MrAbdalrahman/university/Artifical_intelligance/projet1Genetic/AIP1/readme.txt

------------------------------this file helps you to understand how to deal with the program------------------------------

inserting input: 

to insert an input go the the input.txt each line represents a single job in each job there is a set of operations

seperated by " -> ". you dont have to decide how many machines should the system support it generates machines upon the 

higest machine id. let's say your input included M1,M2,M3,M7 it will create machines from M1 to M7.

---------------------------------------------------------------------------------------------------------------------------

analaysing output:

the output is very simple. 

the Y-axis represents the machines 

the X-axis represents the time any operation has been working 

merged togother gives us a simple view of the best schedule for your jobs in your factory

___________________________________________________________________________________________________________________________________________
