MrAbdalrahman/university/project_management/projectManegment.pptx

## Intelligent Speed Bump Alert System

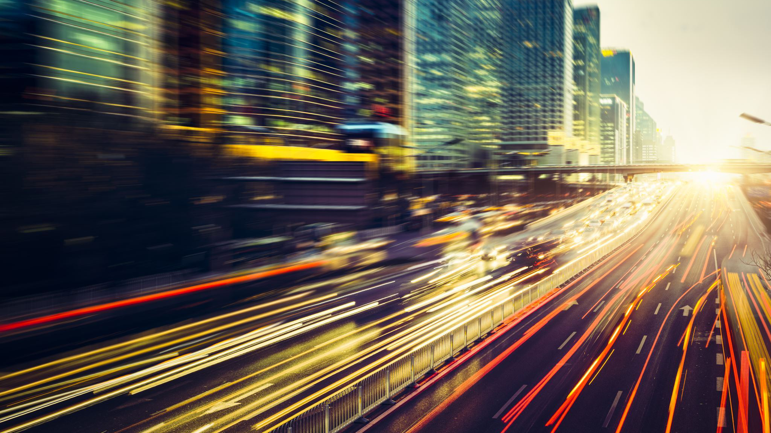
[picture p9: figure]
Traffic light trails at night

## Executive Summary

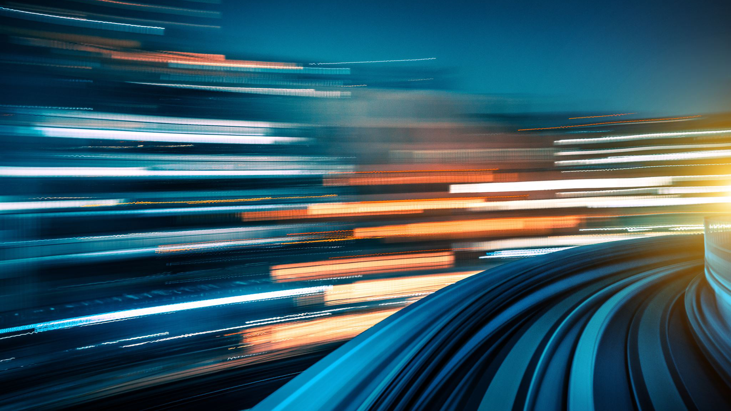
[picture p10: figure]
Long exposure of lights

The Smart Bump Alert System aims to enhance road safety through a compact device in cars. It includes a tiny computer, GPS, SIM card, and a user-friendly screen, alerting drivers about upcoming speed bumps. Our project focuses on careful research and harnessing public support for data collection. In the future, we envision collaborating with the government to enhance road safety using our collected data. Additionally, potential partnerships with map companies could involve sharing our data to improve their maps. Our ultimate objective is to contribute to safer roads for everyone. This project will begin its application on 1/1/2024 and will be ready on 21/5/2024 .

## Project Deliverables and Objective

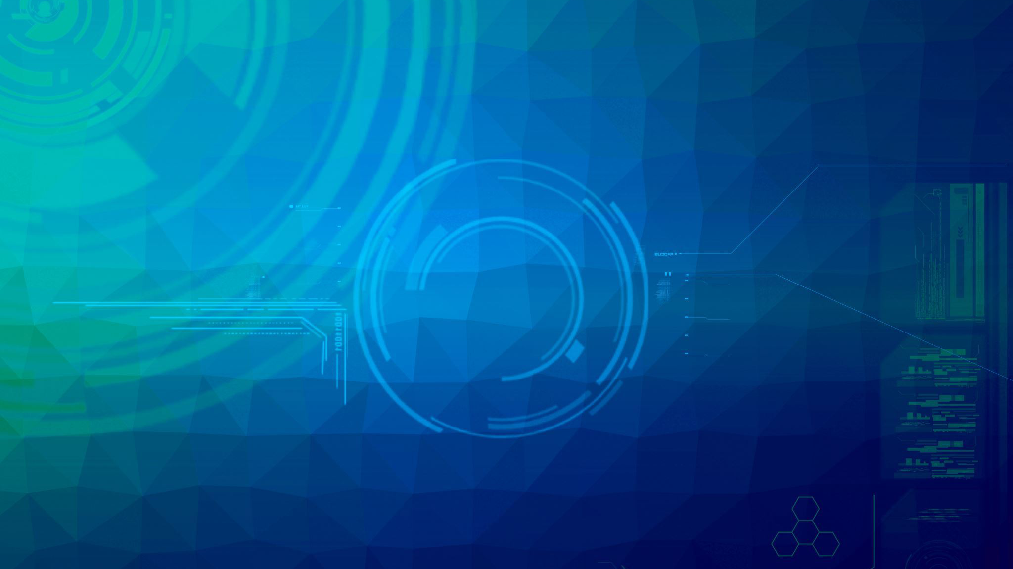
[picture p11: figure]
Technological background

Project Deliverables :
- Acquire Equipment and hire staff: Procure microcontroller, GPS module, SIM card, and necessary elements.
- Java Code Development: Write Java code for the Smart Bump Alert System.
- Data Collection Strategy: Plan how to collect both initial and real-time data.
- Digital Elements Integration: Connect and integrate digital components for seamless functionality.
- Code Installation: Install Java code onto the Smart Bump Alert Device.
- First Prototype Assembly: Assemble hardware components for the initial prototype.
- Prototype Testing: Test the prototype thoroughly for effective operation.
- Feedback application: Review feedback and refine both hardware and software.
- Data Collection Implementation: Implement the data collection strategy.
- Final Prototype Development: Develop the finalized Smart Bump Alert Device.

Project Objective :
- Smart Bump Alert Device first prototype:
Fully functional hardware device with integrated microcontroller, GPS, SIM card, and user-friendly display.
- Collected Data:
Collected initial dataset.

## Mile stones

Equipment Procurement Complete (7/1/2024):
Acquired microcontroller, GPS module, SIM card, and necessary components.
Java Code Development Completed
(14/1/2024)
Developed, tested, and finalized the Java code for the Smart Bump Alert System.
Data Collection Strategy Defined (21/1/2023):
Documented and finalized the strategy for initial and real-time data collection.
Digital Elements Integrated
(11/2/2024):
Successfully connected and integrated all digital components.
Java Code Installed on Device (Week 18/2/2024):
Completed the installation of Java code onto the Smart Bump Alert Device.
First Prototype Assembled and Tested
(18/3/2024):
Assembled hardware components into the initial prototype and conducted comprehensive testing.
Iterative Refinement Completed (17/4/2024):
Reviewed feedback, made necessary refinements to both hardware and software components.
Data Collection Implemented (31/4/2024):
Operational integration of the real-time data collection strategy.
Finalized Device Ready for Production (21/5/2024):
Completed version of the Smart Bump Alert Device ready for manufacturing.

## Slide 5

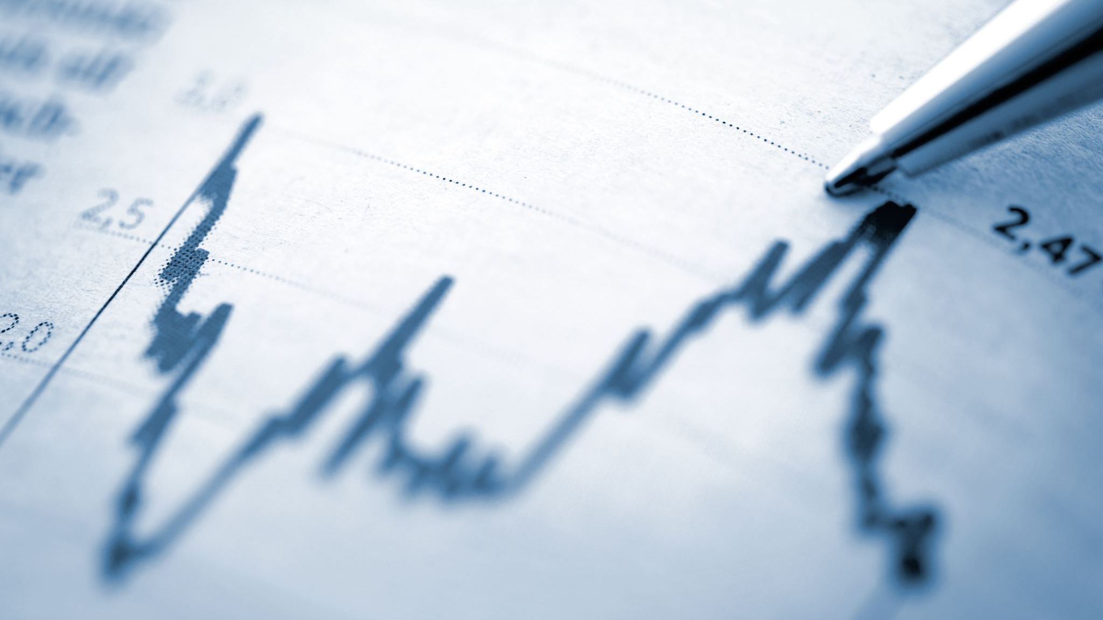
[picture p12: figure]
Graph on document with pen

Technical Requirements and limits and exclusions

Technical Requirements:
- Supplies:
Microcontroller, GPS Module , SIM Card, User-Friendly Display ,Other components like wires ,etc.
- Human resources:
Computer engineer , computer scientist , network specialist , drivers.

Limits and Exclusions:
1- Data Collection and Update:
Inclusion of Government Assistance: Collaboration with the government will be considered to aid in data collection, acknowledging the challenging nature of this task.
2- Restricted Data:
Exclusion of Hole Detection: The system will not have the capability to detect road holes or similar features. It is specifically designed for speed bump detection.
Random Road Geographies: Given that road geographies are created by random individuals, the system's focus is on speed bumps, and it does not account for variations in road conditions such as holes or other irregularities.

## Project priorities

Driver Safety:
Priority: High
Explanation: The primary goal is to enhance driver safety by providing timely and accurate alerts for speed bumps.
Clear Display in Sunlight:
Priority: High
Explanation: Ensuring the display's visibility in bright sunlight is crucial for effective communication with the driver..
Real-Time Response:
Priority: High
Explanation: Achieving a real-time response to speed bump detection is essential for immediate driver awareness and safety.
Adaptability:
Priority: Moderate
Explanation: While important, adaptability to various car models is a secondary priority compared to the core objectives of safety and real-time functionality.

## Work Breakdown structure

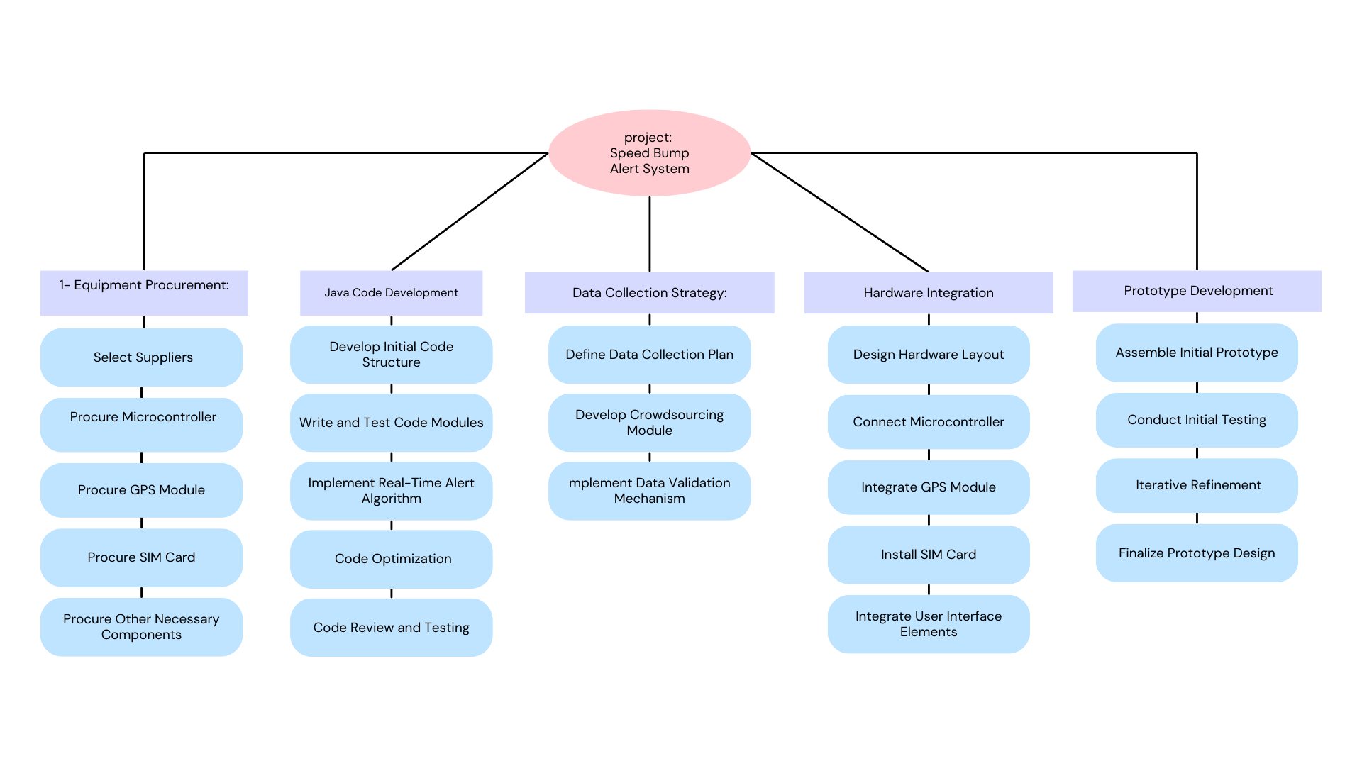
[picture p13: figure]

## Times and Costs

| Equipment procurement | Java Code Development | Initial Data Collection | Hardware and software Integration | Prototype Development
Time | 1 week: 3 days to find suppliers 4 days to purchase equipment | 1 week: 5 days to develop structure 2 days to test code | 6 weeks Initial data collection will be Distributed among workers 3 weeks to data collection 3 weeks to define method | 4weeks 1 week GPS integration 1 week SIM integration 1 week display integration 1week code installation | 4 weeks to test the device
Cost | Raspberry Pi 4 kit: $160 GPS module: $12 Hologram IoT SIM: $55 LCD Display:$10 | Programmer to write the structure: $300 Code tester to test the algorithm: $100 | $1 per 1 location Initial required locations: 1000 location $1000 | Computer Engineer will be working on this $300 per successful integration | Testing will be held by a specialized tester who will get $400 and have to handle a report.

Total time : 16 week + 4 weeks (feed back updates ) = 20 weeks
Total cost : $3237 + $400 as spare if any component lost = $3637
