MrAbdalrahman/university/networks/project1_socket/project_report.pdf

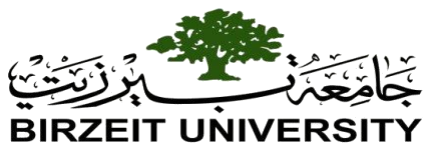
[picture p31: figure]

# Department of Electrical and Computer Engineering

# Computer Networks

# ENCS3320

# Project1

# Prepared by:

Mahmoud Awad | Student NO. 1212677

# Instructor: Dr. Abdalkarim Awad

# Section: One

Abd AlRahman Shaheen | Student NO. 1211753

# Instructor: Dr. Mohammad Jubran

# Section: Two

Omar Daghlas | Student NO. 1222500

# Instructor: Dr. Imad Tartir

# Section: Four

## Date: 22_12_2023

# Part1:

# 1. In your own words, what are ping, tracert, nslookup, and telnet (write one sentence for each one)

## - Ping: ping is a small packet of data sent from one computer to another to check if the

recipient is reachable and how long it takes for the data to travel back.

## - Tracert: tracert is a network diagnostic tool used to trace the route that packets take

from a source device to a destination device or server on an IP network.

## - Nslookup: nslookup is a command-line tool used for querying Domain Name System (DNS) servers to obtain domain name or IP address mapping, DNS records, and other

DNS-related information.

## - Telnet: telnet is a network protocol and a command-line tool that allows for

bidirectional text communication between two devices over a network.

## 2. Make sure that your computer is connected to the internet and then run the following commands:

## 1. Ping a device in the same network, e.g. from a laptop to a smartphone

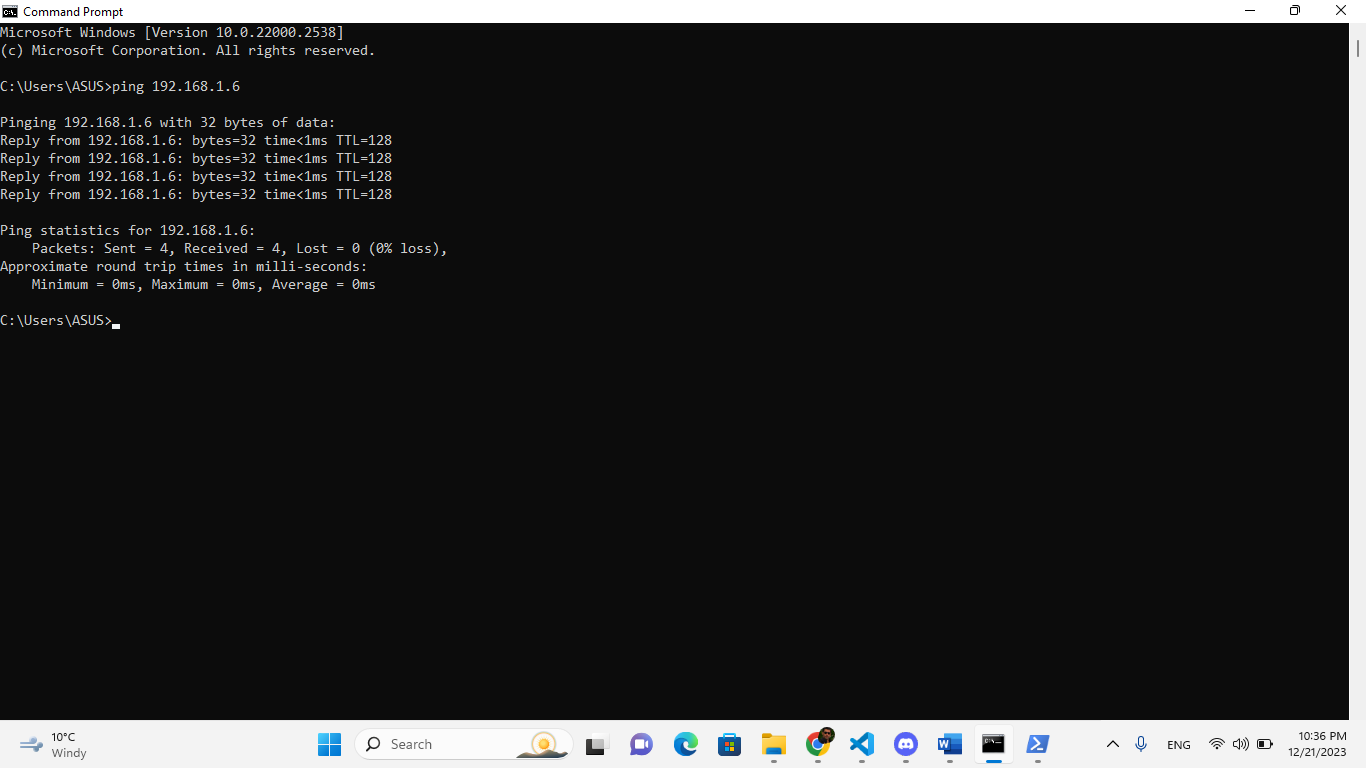
[picture p32: figure]

## Explanation of the output:

This command displays the results of each ICMP echo request. For each packet sent (four in this case), the output shows a reply from the specified IP address (192.168.1.6) along with the size of the data packet (32 bytes), the round trip time (time<1ms, indicating a response time of less than 1 millisecond), and the Time to Live (TTL) value, which is 128 in this case.

## 2. ping www.cornell.edu 1) Using Command Prompt:

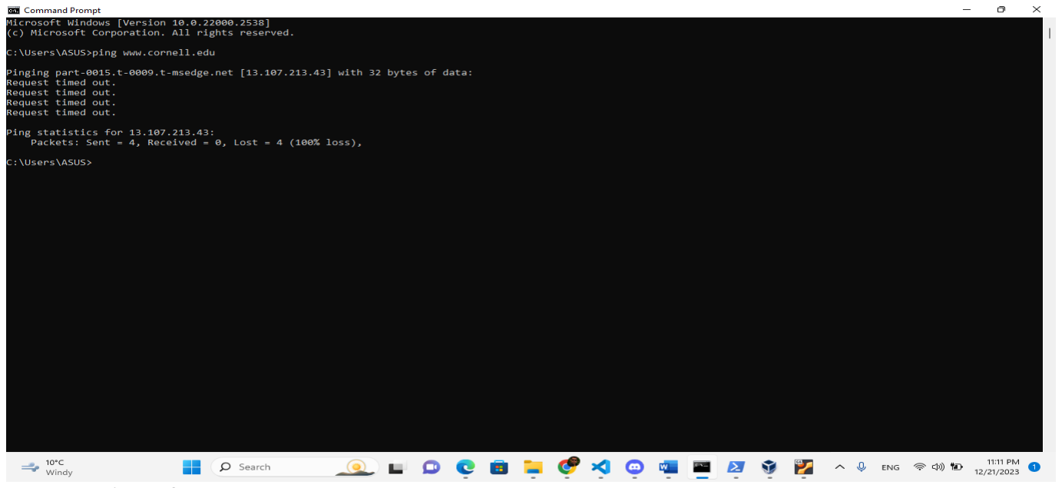
[picture p33: figure]

## Explanation of the output:

The output shows that the ping attempts to the IP address 13.107.213.43 (associated with the domain www.cornell.edu) resulted in four consecutive timeouts. Each "Request timed out" message indicates that the ping packet did not receive a response within the expected time frame.

## 2) Using Linux:

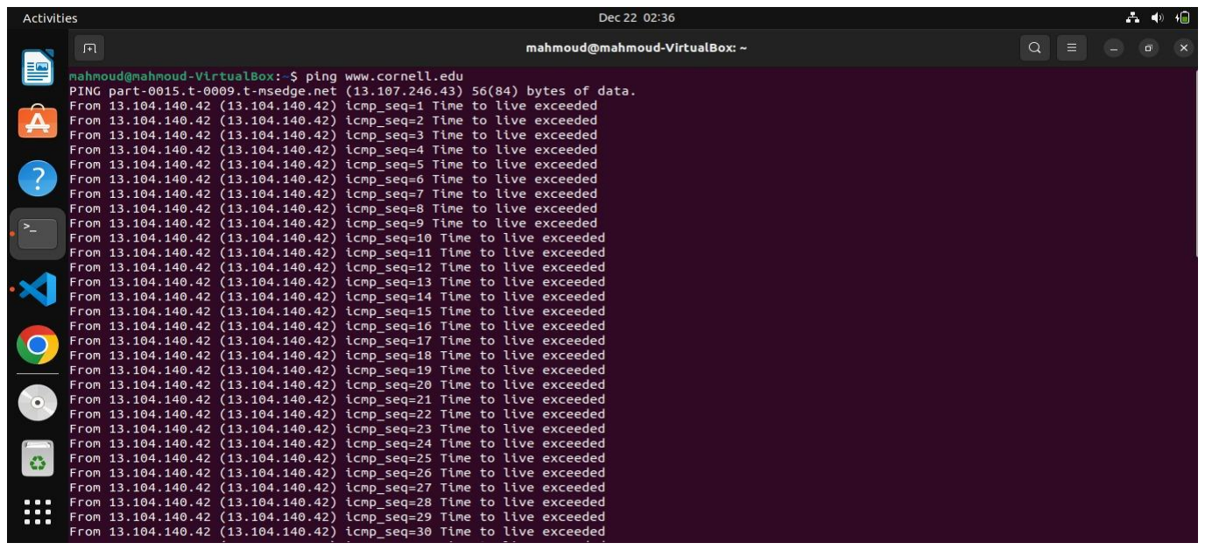
[picture p34: figure]

## Explanation of the output:

The subsequent lines show responses received from the IP address 13.104.140.42, indicating that the Time to Live (TTL) for the packets has been exceeded. This typically occurs when a packet traverses routers, and the TTL value reaches zero, preventing it from reaching the destination. The router then sends an ICMP Time to Live Exceeded message back to the source.

## 3. tracert www.cornell.edu

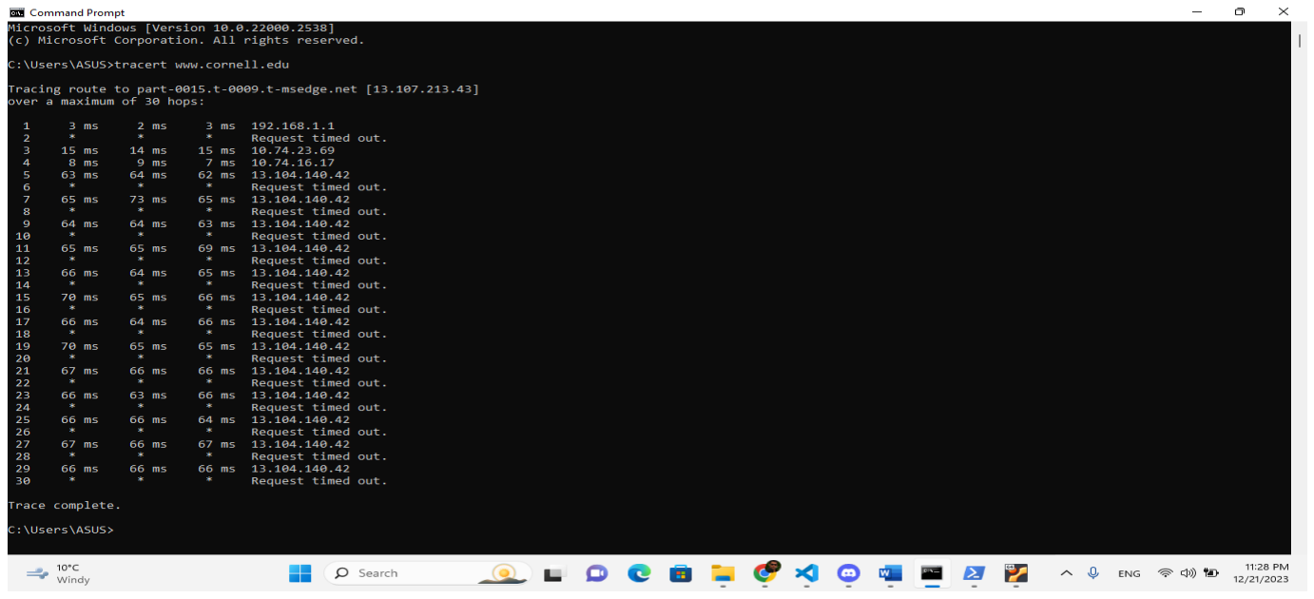
[picture p35: figure]

## Explanation of the output:

The first step (hop) is quick and takes about 3 milliseconds to reach a place labeled as 192.168.1.1, which might be like the entrance gate to the internet.
The second step didn't respond, and we don't know what happened there.
The third step took about 15 milliseconds to reach another place with the address 10.74.23.69.

## 4. nslookup www.cornell.edu

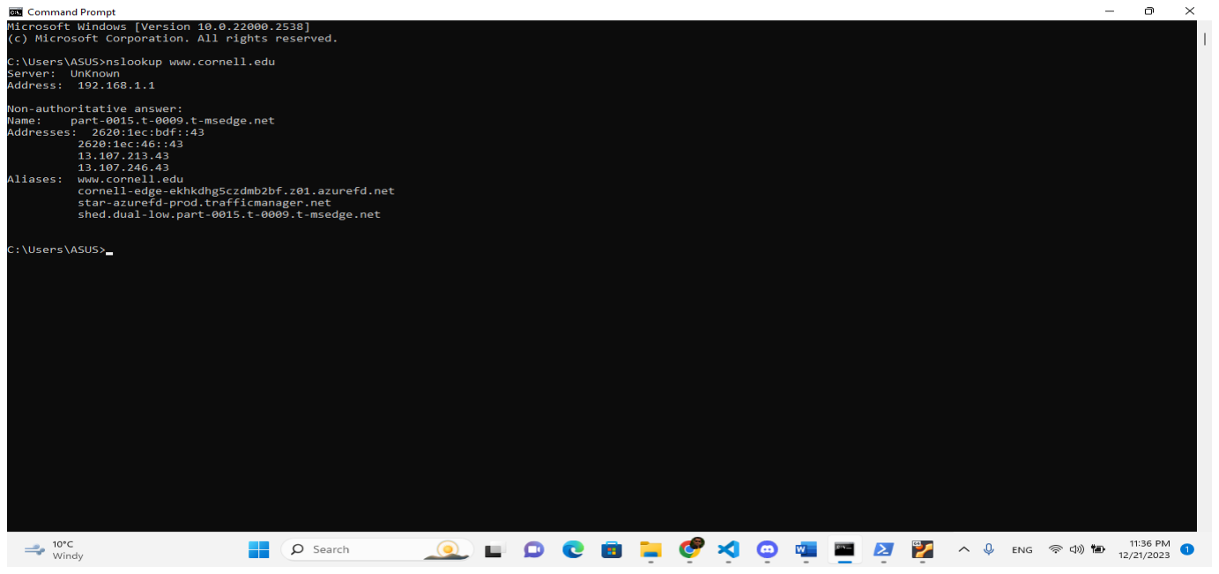
[picture p36: figure]

## Explanation of the output:

The website www.cornell.edu has other names like part-0015.t-0009.t-msedge.net.
It can be reached using different numbers (addresses) like 2620:1ec:bdf::43, 2620:1ec:46::43, 13.107.213.43, and 13.107.246.43.
The website has nicknames or aliases like www.cornell.edu.
It's associated with other names like cornell-edge-ekhkdhg5czdmb2bf.z01.azurefd.net and star-azurefd-prod.trafficmanager.net.

3. Use wireshark to capture some DNS messages.

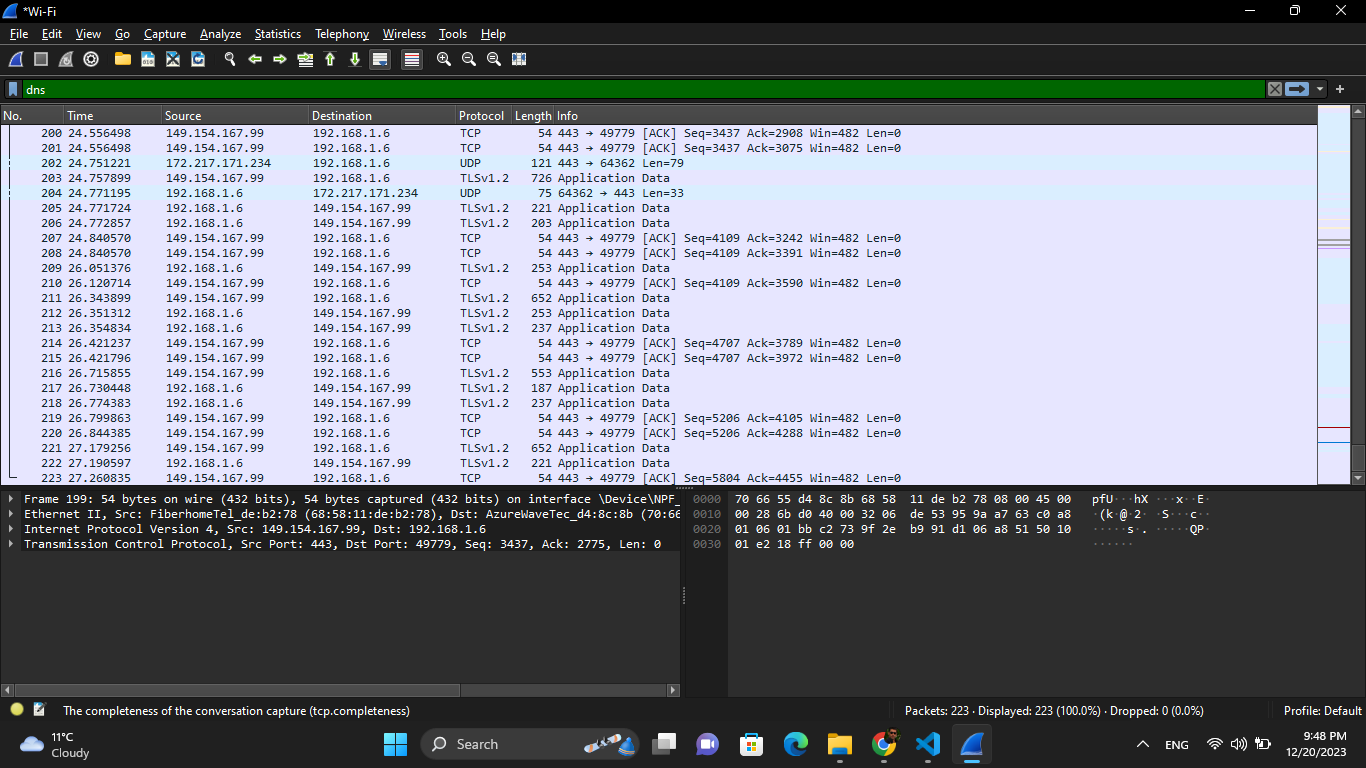
[picture p37: figure]

## Explanation of the output:

Wireshark Interface: Displays captured network packets with details like number, time, source, destination, protocol, length, and information.
Color-coded rows represent individual packets, allowing for easy identification and analysis.
TCP Details: The bottom section shows details of a specific Transmission Control Protocol (TCP) packet. Taskbar Icons: Includes Wi-Fi signal strength and battery level indicators.

## - From the ping results, do you think the response you have got is from USA?

Explain your answer briefly.

- When you use the "ping" command to talk to a server, you're checking if it responds back. The response time is shown, but it doesn't tell you the exact route or where the server is. It just says if the server is reachable or not.
- If you want to know the path your data takes to reach a destination, you can use tools like "traceroute" or "tracert" on your computer. These tools reveal each stop (router) along the way, helping you see the route and possibly the location of each middle server.

### - depending on the previous run of tracert: As you notice the time diffirance on 2 specific points: from (7ms) to (62ms)

this is where the response transported through the ocean and went to America. hence, the response we got is from USA.

# Part2:

❖ Using socket programming, implement TCP client and server applications in python. The server should listen on port 9955. The server waits for a message from a client. If the message is with one of the students ID (1211773, 1222500, 1212677).

## the sever should do the following:

## 1. display a message on the server side that the OS will lock screen after 10 seconds 2. send a message to the client that the sever will lock screen after 10 seconds 3. then wait 10 seconds

4. then call a function lock the screen of the operating system windows.

## Code:

## 1. Server Code:

1. import socket
2. import threading
3. import time

4.

5. dataBase = ["1211753", "1222500", "1212677"]
6. PORT = 9955 # using port 9955
7. FORMAT = "utf-8" # format used for our messages decoding
8. HEADER = 64
9. D = "DES"
10. SERVER = socket.gethostbyname(socket.gethostname()) # dynamic ip address getter
11. ADDR = (SERVER, PORT) # adding the server and the port
12. server = socket.socket(socket.AF_INET, socket.SOCK_STREAM) # using ipv4 address family and type

stream for the server

13. server.bind(ADDR) # binding the server and the port
14. # sever is built and ready to use

15.

16. def lockScreen():
17. print("screen is locked")

18.

19. def send(msg, client):
20. MSG = msg.encode(FORMAT) # encoding the decoded message with the same format
21. msg_len = len(MSG) # message length got
22. send_len = str(msg_len).encode(FORMAT)
23. send_len +=b' '*(HEADER - len(send_len))
24. client.send(send_len)
25. client.send(MSG)

26.

27. def client(conn, addr, clients):

28.

29. print(f"{addr} Is Connected!")

30. connected = True # connection status
31. while connected:
32. msg_len = conn.recv(HEADER).decode(FORMAT) # take the message header and check the length

and allocate 64

33. if msg_len:
34. msg_len = int(msg_len) # now we have the message length
35. msg = conn.recv(msg_len).decode(FORMAT)
36. if msg == D:
37. connected = False
38. print(f"{addr} disconnected")
39. if msg in dataBase:
40. print(f"{addr} {msg} exists")
41. print("the OS will lock screen after 10 seconds")
42. send("the OS will lock screen after 10 seconds",conn)
43. time.sleep(10)
44. lockScreen()
45. else:
46. print("student id does not exist in our data base")
47. send("the OS will not lock the screen ", conn)
48. conn.close()

49.

50. def start():
51. server.listen() # setting the server to listening mode
52. print(f"The Server Is Listening to {SERVER} ")
53. clients = []
54. while True: # this will receive any connection
55. conn, addr = server.accept() # obtaining connection and ip address
56. clients.append(conn) # appending connections
57. thread = threading.Thread(target=client, args=(conn, addr, clients))
58. thread.start()

59.

60. print("The Server Is Starting")
61. start()

## 2. Client Code:

## 1. import socket 2. import threading

3.

4. PORT = 9955 # using port 9955 5. FORMAT = "utf-8" # format used for our messages decoding 6. D = "DES" 7. HEADER = 64 8. SERVER = "192.168.56.1" # my ip address 9. ADDR = (SERVER, PORT) # adding the server and the port 10. client = socket.socket(socket.AF_INET, socket.SOCK_STREAM) # using ipv4 address family and type stream for the client 11. client.connect(ADDR)

12.

## 13. def send(msg): 14. MSG = msg.encode(FORMAT) # encoding the decoded message with the same format 15. msg_len = len(MSG) # message length got 16. send_len = str(msg_len).encode(FORMAT) 17. send_len +=b' '*(HEADER - len(send_len)) 18. client.send(send_len) 19. client.send(MSG)

20.

## 21. def read(): 22. msg_len = client.recv(HEADER).decode(FORMAT) # take the message header and check the length and allocate 64 23. if msg_len: 24. msg_len = int(msg_len) # now we have the message length 25. msg = client.recv(msg_len).decode(FORMAT) 26. print(f"{msg} ")

27.
28. x = ''

## 29. while 1: 30. x = input() 31. if x!='DES': 32. send(x) 33. thread = threading.Thread(target=read) 34. thread.start() 35. send(D)

## Result:

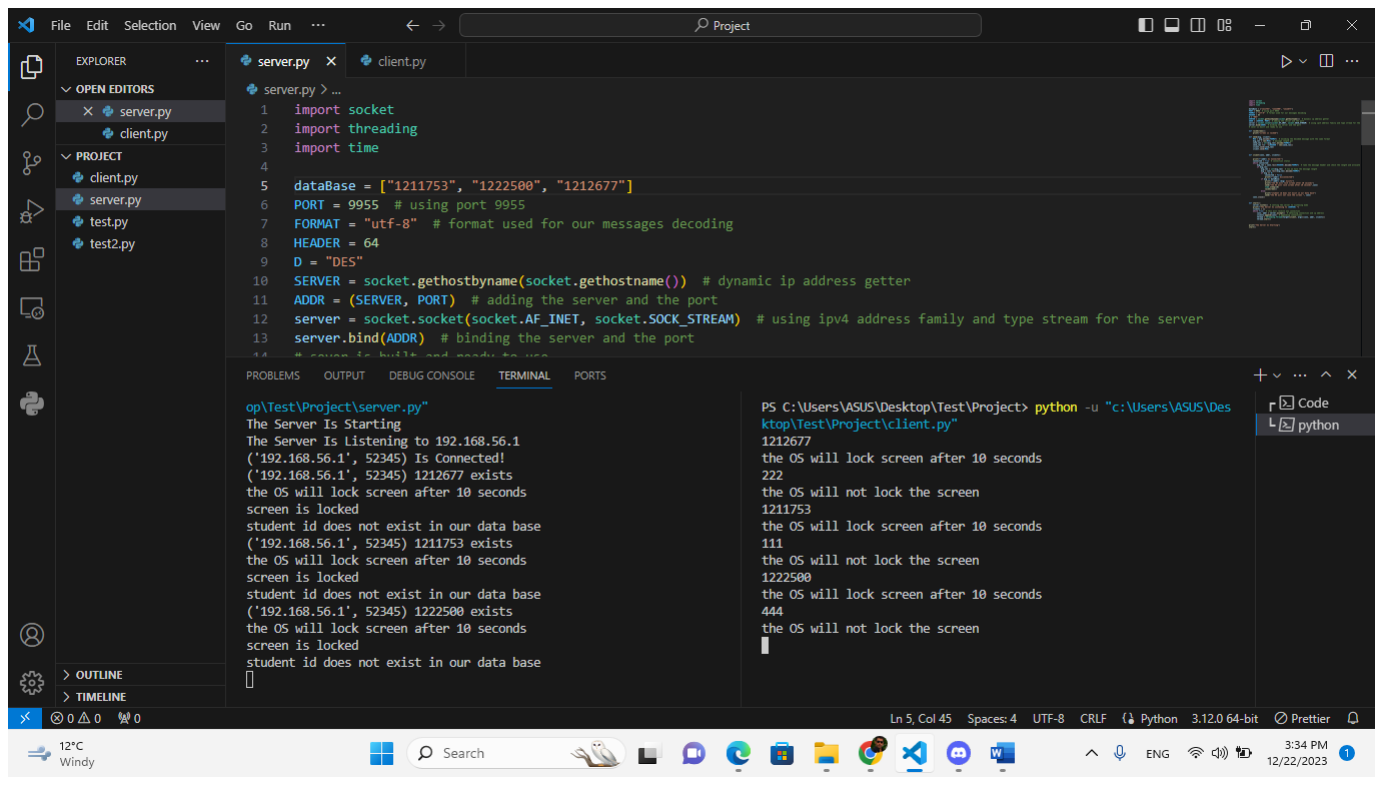
[picture p38: figure]

# Part3:

# Code:

## 1. Server Code:

1. import socket
2. import os
3. import urllib.parse
4. from threading import Thread

5.

6. class MyHTTPServer:
7. def __init__(self, host, port):
8. self.host = host
9. self.port = port
10. self.server_socket = socket.socket(socket.AF_INET, socket.SOCK_STREAM)
11. self.server_socket.setsockopt(socket.SOL_SOCKET, socket.SO_REUSEADDR, 1)
12. self.server_socket.bind((self.host, self.port))
13. self.server_socket.listen(5)

14.

15. def start(self):
16. print(f"Server listening on {self.host}:{self.port}")
17. while True:
18. client_socket, client_address = self.server_socket.accept()
19. client_handler = Thread(target=self.handle_client, args=(client_socket,))
20. client_handler.start()

21.

22. def handle_client(self, client_socket):
23. client_address = client_socket.getpeername()
24. request_data = client_socket.recv(1024).decode("utf-8")
25. if not request_data:
26. return

27.

28. method, path, _ = request_data.split(" ", 2)
29. path = urllib.parse.unquote(path)
30. file_path = path.lstrip("/")

31.

32. if method == "GET":
33. if file_path == "index.html" or file_path == "en" or file_path == "":
34. status_code = "200"
35. self.log_request_details(client_address, method, path, "HTML", status_code)
36. self.send_html_response(client_socket, "main_en.html")
37. elif file_path == "ar":
38. status_code = "200"
39. self.log_request_details(client_address, method, path, "HTML", status_code)
40. self.send_html_response(client_socket, "main_ar.html")
41. elif file_path.endswith(".html"):

42. status_code = "200"
43. self.log_request_details(client_address, method, path, "HTML", status_code)
44. self.send_html_file(client_socket, file_path)
45. elif file_path.endswith(".css"):
46. status_code = "200"
47. self.log_request_details(client_address, method, path, "CSS", status_code)
48. self.send_css_file(client_socket, file_path)
49. elif file_path.endswith(".png"):
50. status_code = "200"
51. self.log_request_details(client_address, method, path, "PNG", status_code)
52. self.send_image(client_socket, file_path, "image/png")
53. elif file_path.endswith(".jpg"):
54. status_code = "200"
55. self.log_request_details(client_address, method, path, "JPG", status_code)
56. self.send_image(client_socket, file_path, "image/jpeg")
57. elif file_path in ["cr", "so", "rt"]:
58. status_code = "307"
59. self.log_request_details(client_address, method, path, "Redirect", status_code)
60. self.send_redirect(client_socket, file_path)
61. else:
62. status_code = "404"
63. self.log_request_details(client_address, method, path, "Unknown", status_code)
64. self.send_error_response(client_socket)
65. else:
66. self.send_error_response(client_socket)

67.

68. client_socket.close()

69.

70. def log_request_details(self, client_address, method, path, file_type, status_code):
71. print(f"Received request from {client_address}: Method: {method}, Path: {path}, File Type:

{file_type}, Status Code: {status_code}")

72.

73. def send_static_file(self, client_socket, file_path, content_type):
74. abs_file_path = os.path.abspath(os.path.join(os.path.dirname(__file__), "static",

file_path))

75. if not os.path.exists(abs_file_path):
76. self.send_error_response(client_socket)
77. return

78.

79. with open(abs_file_path, "rb") as file:
80. content = file.read()

81.

82. response = f"HTTP/1.1 200 OK\r\nContent-Type: {content_type}\r\nContent-Length:

{len(content)}\r\n\r\n"

83. client_socket.sendall(response.encode("utf-8") + content)

84.

85. def send_html_response(self, client_socket, filename):
86. self.send_static_file(client_socket, filename, "text/html")

87.

88. def send_html_file(self, client_socket, file_path):
89. self.send_static_file(client_socket, file_path, "text/html")

90.

91. def send_css_file(self, client_socket, file_path):
92. self.send_static_file(client_socket, file_path, "text/css")

93.

94. def send_image(self, client_socket, file_path, content_type):
95. self.send_static_file(client_socket, file_path, content_type)

96.

97. def send_redirect(self, client_socket, target):
98. locations = {"cr": "http://cornell.edu", "so": "http://stackoverflow.com", "rt":

"http://ritaj.birzeit.edu"}

99. if target in locations:
100. response = f"HTTP/1.1 307 Temporary Redirect\r\nLocation: {locations[target]}\r\n\r\n"
101. client_socket.sendall(response.encode("utf-8"))
102. else:
103. self.send_error_response(client_socket)

104.

105. def send_error_response(self, client_socket):
106. response = "HTTP/1.1 404 Not Found\r\nContent-Type: text/html\r\n\r\n"

107.

108. try:
109. with open(os.path.join("static", "DNE.html"), "rb") as file:
110. content = file.read()
111. client_socket.sendall(response.encode("utf-8") + content)
112. except FileNotFoundError:
113. error_message = "<html><body><h1>File Not Found</h1></body></html>"
114. client_socket.sendall(response.encode("utf-8") + error_message.encode("utf-8"))

115.

116. if __name__ == "__main__":
117. host = '0.0.0.0'
118. port = 9966
119. server = MyHTTPServer(host, port)

120.

121. try:
122. server.start()
123. except KeyboardInterrupt:
124. print("Server stopped by user") 125.

## 2. main_en.html:

1. <!DOCTYPE html>
2. <html>
3. <head>
4. <title>ENCS3320-My Tiny Webserver 23/24</title>
5. <style>
6. body {
7. background: linear-gradient(to right, #6dd5ed, #2193b0);
8. font-family: Arial, sans-serif;
9. color: #fff;
10. margin: 0;
11. padding: 0;
12. }

13.

14. .info-box,
15. .student {
16. background-color: #fff;
17. color: #333;
18. border-radius: 10px;
19. box-shadow: 0 0 10px rgba(0, 0, 0, 0.2);
20. margin: 20px;
21. padding: 20px;
22. position: relative;
23. transition: all 0.3s ease;
24. }

25.

26. .info-box:hover,
27. .student:hover {
28. box-shadow: 0 0 15px rgba(0, 0, 0, 0.3);
29. }

30.

31. .students {
32. display: flex;
33. justify-content: space-around;
34. flex-wrap: wrap;
35. }

36.

37. .student-photo {
38. width: 100px;
39. height: 100px;
40. border-radius: 50%;
41. object-fit: cover;
42. position: absolute;
43. top: 10px;
44. right: 10px;

45. }

46.

47. footer {
48. text-align: center;
49. padding: 20px;
50. }

51.

52. a {
53. color: #1a75ff;
54. margin: 0 10px;
55. transition: color 0.3s ease;
56. }

57.

58. a:hover {
59. color: #ffcc29;
60. }
61. </style>
62. </head>
63. <body>
64. <h1>Welcome to our course Computer Networks, <span style="color: blue;">This is a tiny

webserver</span></h1>

65.

66. <div class="info-box">
67. <p>Content-Type in HTTP is used to indicate the media type of the resource. In responses,

a Content-Type header tells the client what the content type of the returned content actually

is.</p>

68. </div>

69.

70. <div class="student-container">
71. <div class="student">
72. <img src="student1.png" alt = "student1 image" style="width: 100px; height: 100px;

border-radius: 50%; object-fit: cover; position: absolute; top: 10px; right: 10px;">

73. <h2>Omar Daghlas</h2>
74. <p>ID: 1222500</p>
75. <p>Projects: Gaza- Humanitarian Information Managing System</p>
76. <p>Skills: Public Speeches</p>
77. <p>Hobbies: Swimming</p>
78. </div>

79.

80. <div class="student">
81. <img src="student2.jpg" alt="student2 image" style="width: 100px; height: 100px;

border-radius: 50%; object-fit: cover; position: absolute; top: 10px; right: 10px;">

82. <h2>Abd AlRahman Shaheen</h2>
83. <p>ID: 1211753</p>

84. <p>Projects: private accounting program (c), local web server(html)(css)(python),

simple CPU(multisim)(vhdl). </p>

85. <p>Skills: c,c++,css,html,python,java,verilog,embeded c, fast learning, self learning.

</p>

86. <p>Hobbies: Coding, gamming, smoking. </p>
87. </div>

88.

89. <div class="student">
90. <img src="student3.jpg" alt="student3 image" style="width: 100px; height: 100px;

border-radius: 50%; object-fit: cover; position: absolute; top: 10px; right: 10px;">

91. <h2>Mahmoud Awad</h2>
92. <p>ID: 1212677</p>
93. <p>Projects: Train Seat Reserving System</p>
94. <p>Skills: Programming</p>
95. <p>Hobbies: Cycling</p>
96. </div>
97. </div>

98.

99. <a href="main_ar.html"> Arabic Page</a>
100. <a href="https://www.w3schools.com/python/python_strings.asp">Python Strings at W3Schools</a>
101. </body>
102. </html>

## 3. main_ar.html:

1. <!DOCTYPE html>
2. <html lang="ar" dir="rtl">
3. <head>
4. <meta charset="UTF-8">
<title/<خادم الويب الصغير الخاص بي 3320-24/23ENCS>title <5.
6. <link rel="stylesheet" type="text/css" href="style.css">
7. </head>
8. <body>
<1h/><span/<هذا خادم ويب صغير<";blue :color="style span<مرحبًا بكم في دورتنا لشبكات الكمبيوتر، <1h <9.

10.

11. <div class="info-box">
لإلشارة إلى نوع الوسائط للمورد. في االستجابات، يخبر رأس نوع المحتوى العميل بنوع المحتوى الفعلي HTTP يُستخدم نوع المحتوى في<p <12.

<p/<.ال ُمرجع

13. </div>

14.

15. <div class="student-container">

16. <div class="student">
17. | <img src="student1.png" alt=" | االول | الطالب | صورة | "class="student-photo" style="width: 100px;

height: 100px; border-radius: 50%; object-fit: cover; position: absolute; top: 10px; left: 10px;"> <2h/<عمر دغلس<2h <18.

<p/<الرقم التعريفي: 1222500<p <19.

<p/<المشاريع: نظام إدارة المعلومات اإلنسانية في غزة<p <20.

<p/<المهارات: الخطابة العامة<p <21.

<p/<الهوايات: السباحة<p <22.

23. </div>

24.

25. <div class="student">
26. | <img src="student2.jpg" alt=" | الثاني | الطالب | صورة | "class="student-photo" style="width: 100px;

height: 100px; border-radius: 50%; object-fit: cover; position: absolute; top: 10px; left: 10px;"> <2h/<عبد الرحمن شاهين<2h <27.

<p/<الرقم التعريفي: 1211753<p <28.

<p/<معالج بسيط ,المشاريع: برنامج محاسبة خاص , خادم ويب محلي <p <29.

<p/<المهارات: البرمجة,التلعم السريع,التعلم الذاتي<p <30.

<p/<الهوايات: البرمجة,العاب الفيديو,التدخين<p <31.

32. </div>

33.

34. <div class="student">
35. | <img src="student3.jpg" alt=" | الثالث | الطالب | صورة | "class="student-photo" style="width: 100px;

height: 100px; border-radius: 50%; object-fit: cover; position: absolute; top: 10px; left: 10px;">

<2h/<محمود عوض<2h <36.
<p/<الرقم التعريفي: 1212677<p <37.

<p/<المشاريع: برنامج حجز مقاعد الطائرات<p <38.

<p/<المهارات: البرمجة<p <39.

<p/<الهوايات: ركوب الدراجات <p <40.

41. </div>
42. </div>

43.

44. <a href="main_en.html">English</a>
45. | <a href="https://www.w3schools.com/python/python_strings.asp">في | األحرف | سالسل | Python | موقع | على

W3Schools</a>

46. </body>
47. </html>
48.

## 4. DNE.html:

1. <!DOCTYPE html>
2. <html lang="en">
3. <head>
4. <meta charset="UTF-8">
5. <meta name="viewport" content="width=device-width, initial-scale=1.0">
6. <title>Error 404</title>
7. <style>
8. body { font-family: Arial, sans-serif; }
9. .error-message { color: red; }
10. .bold { font-weight: bold; }
11. </style>
12. <script>
13. document.addEventListener("DOMContentLoaded", function() {
14. // Use JavaScript to get client IP address and port
15. document.querySelector(".bold.client-ip").innerText = "Client IP: " +

window.location.hostname;

16. document.querySelector(".bold.client-port").innerText = "Client Port: " +

window.location.port;

17. });
18. </script>
19. </head>
20. <body>
21. <h1>HTTP/1.1 404 Not Found</h1>
22. <p class="error-message">The file is not found</p>
23. <p class="bold">Student1 Name: [Omar Daghlas]</p>
24. <p class="bold">Student1 ID: [1222500]</p>
25. <p class="bold">Student2 Name: [Abd AlRahman Shaheen]</p>
26. <p class="bold">Student2 ID: [1211753]</p>
27. <p class="bold">Student3 Name: [Mahmoud Awad]</p>
28. <p class="bold">Student3 ID: [1212677]</p>
29. <p class="bold client-ip"></p>
30. <p class="bold client-port"></p>
31. </body>
32. </html>
33.

## 5. Style.CSS:

1. /* style.css */
2. body {
3. background: linear-gradient(to right, #6dd5ed, #2193b0);
4. font-family: Arial, sans-serif;
5. color: #fff;
6. margin: 0;
7. padding: 0;
8. }
9. .info-box,
10. .student {
11. background-color: #fff;
12. color: #333;
13. border-radius: 10px;
14. box-shadow: 0 0 10px rgba(0, 0, 0, 0.2);
15. margin: 20px;
16. padding: 20px;
17. position: relative;
18. transition: all 0.3s ease;
19. }
20. .info-box:hover,
21. .student:hover {
22. box-shadow: 0 0 15px rgba(0, 0, 0, 0.3);
23. }
24. .students {
25. display: flex;
26. justify-content: space-around;
27. flex-wrap: wrap;
28. }
29. /* Remove styles related to the student photo */
30. footer {
31. text-align: center;
32. padding: 20px;
33. }

34.

35. a {
36. color: #1a75ff;
37. margin: 0 10px;
38. transition: color 0.3s ease;
39. }
40. a:hover {
41. color: #ffcc29;
42. }
43.

## Results:

## 1. main_en.html Results:

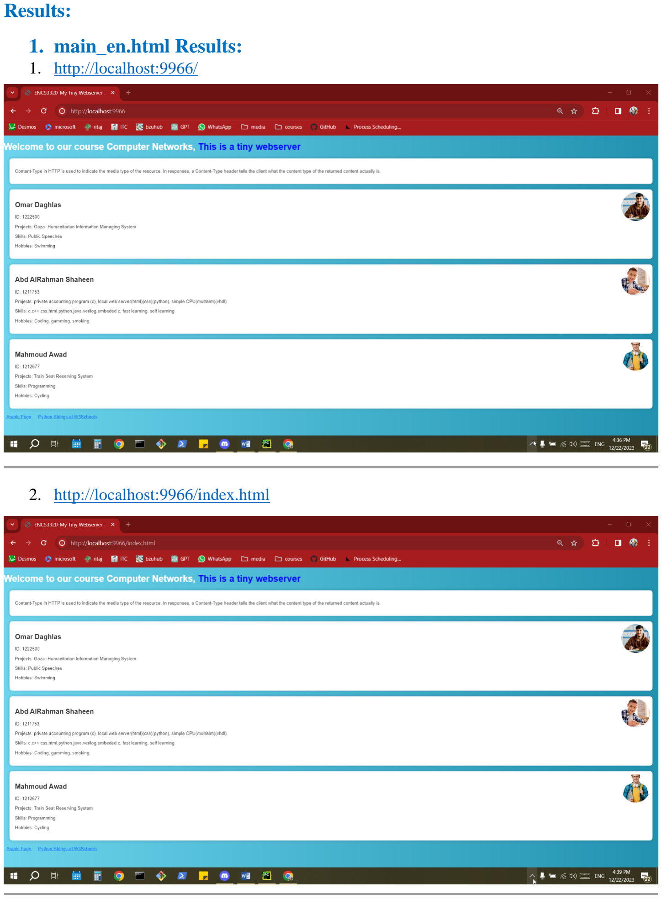
[picture p39: page 19]

## 1. http://localhost:9966/

## 2. http://localhost:9966/index.html

## 3. http://localhost:9966/main_en.html

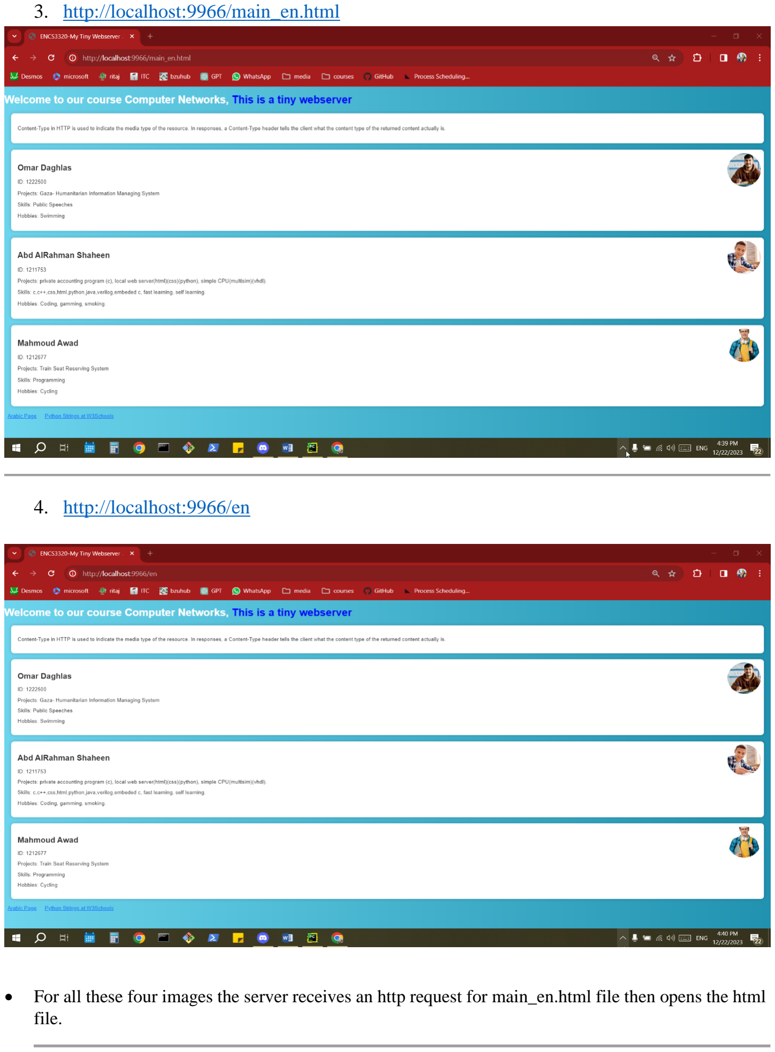
[picture p40: page 20]

## 4. http://localhost:9966/en

- For all these four images the server receives an http request for main_en.html file then opens the html file.

## 2. main_ar.html Result:

## ❖ http://localhost:9966/ar

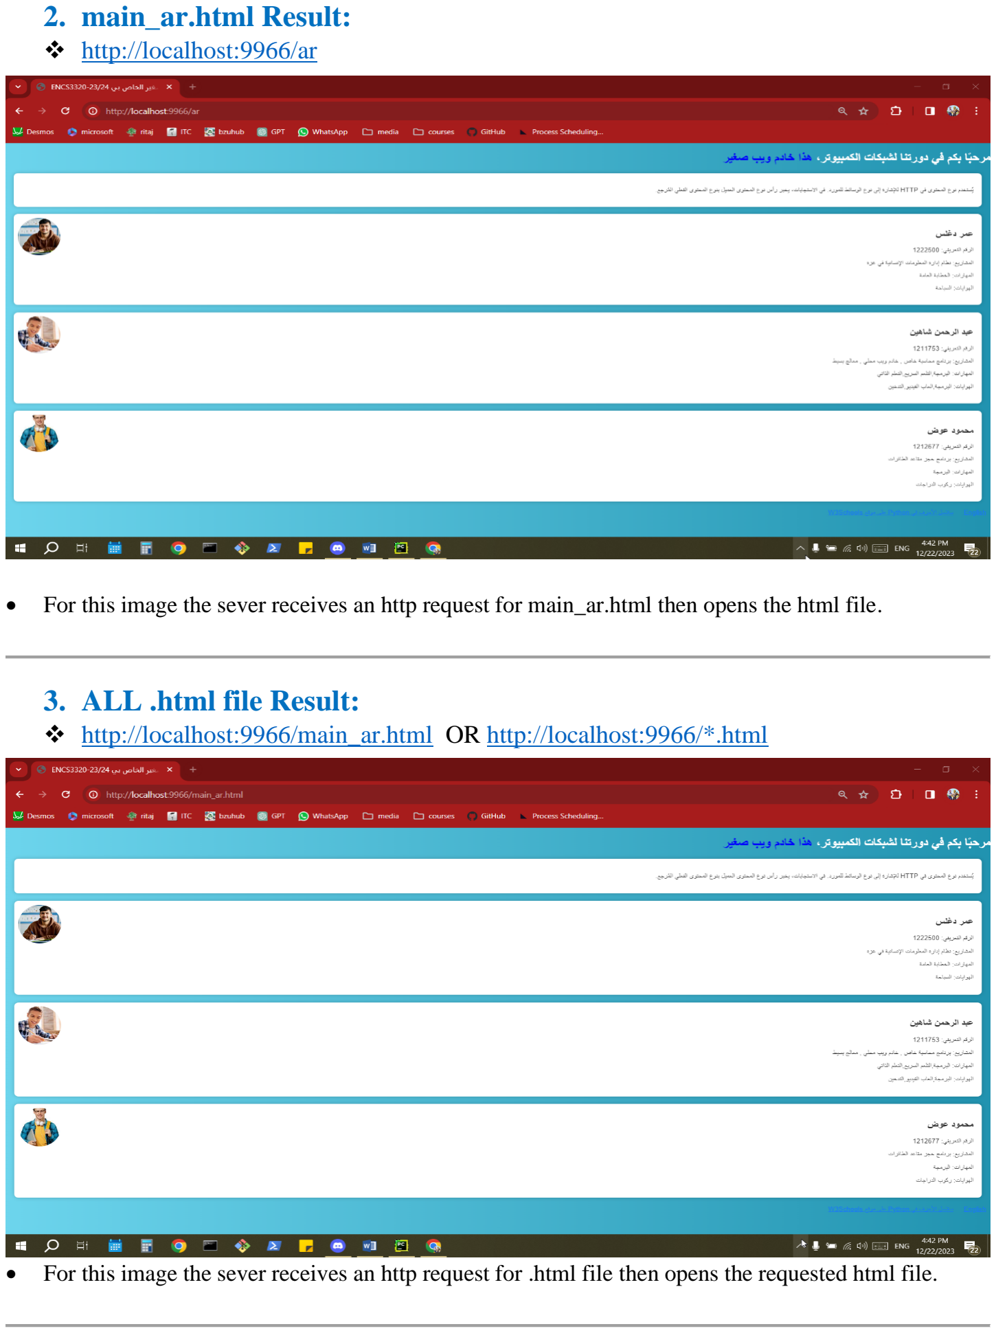
[picture p41: page 21]

- For this image the sever receives an http request for main_ar.html then opens the html file.

## 3. ALL .html file Result:

## ❖ http://localhost:9966/main_ar.html OR http://localhost:9966/*.html

- For this image the sever receives an http request for .html file then opens the requested html file.

## 4. .CSS Result:

## ❖ http://localhost:9966/style.css

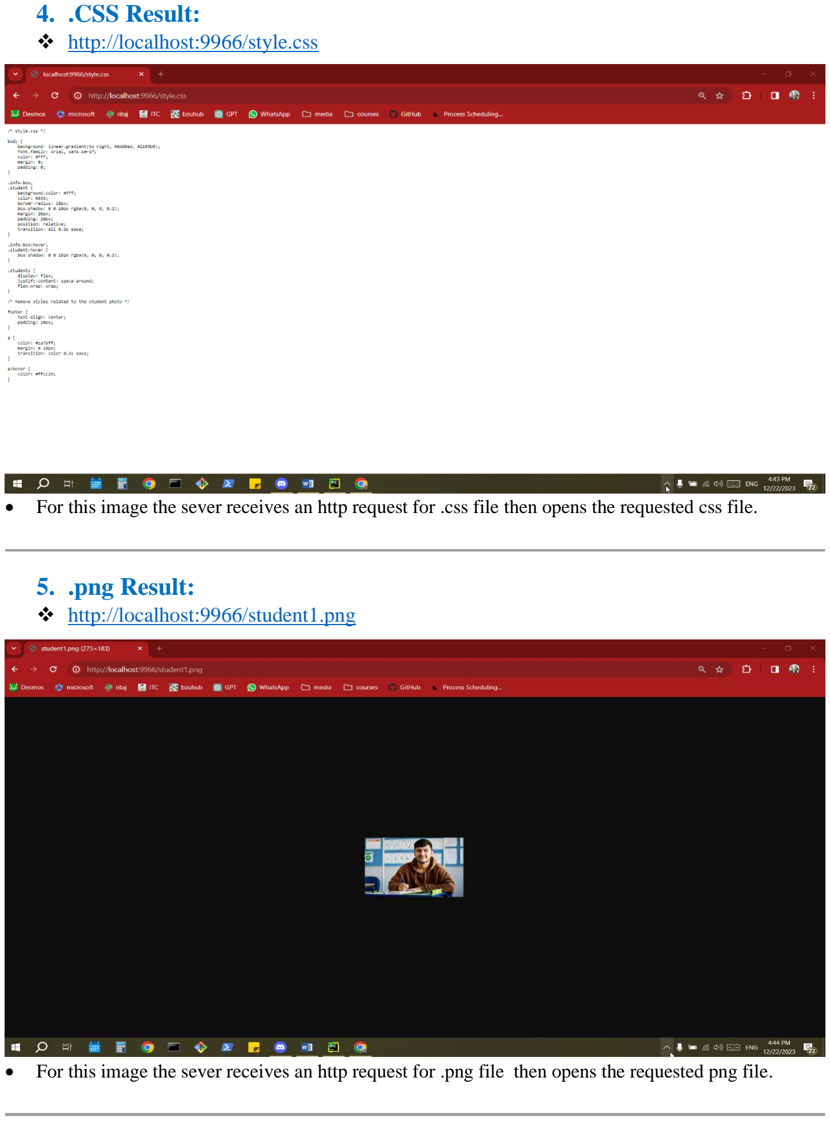
[picture p42: page 22]

- For this image the sever receives an http request for .css file then opens the requested css file.

## 5. .png Result:

## ❖ http://localhost:9966/student1.png

- For this image the sever receives an http request for .png file then opens the requested png file.

## 6. .jpg Result:

## ❖ http://localhost:9966/student2.jpg

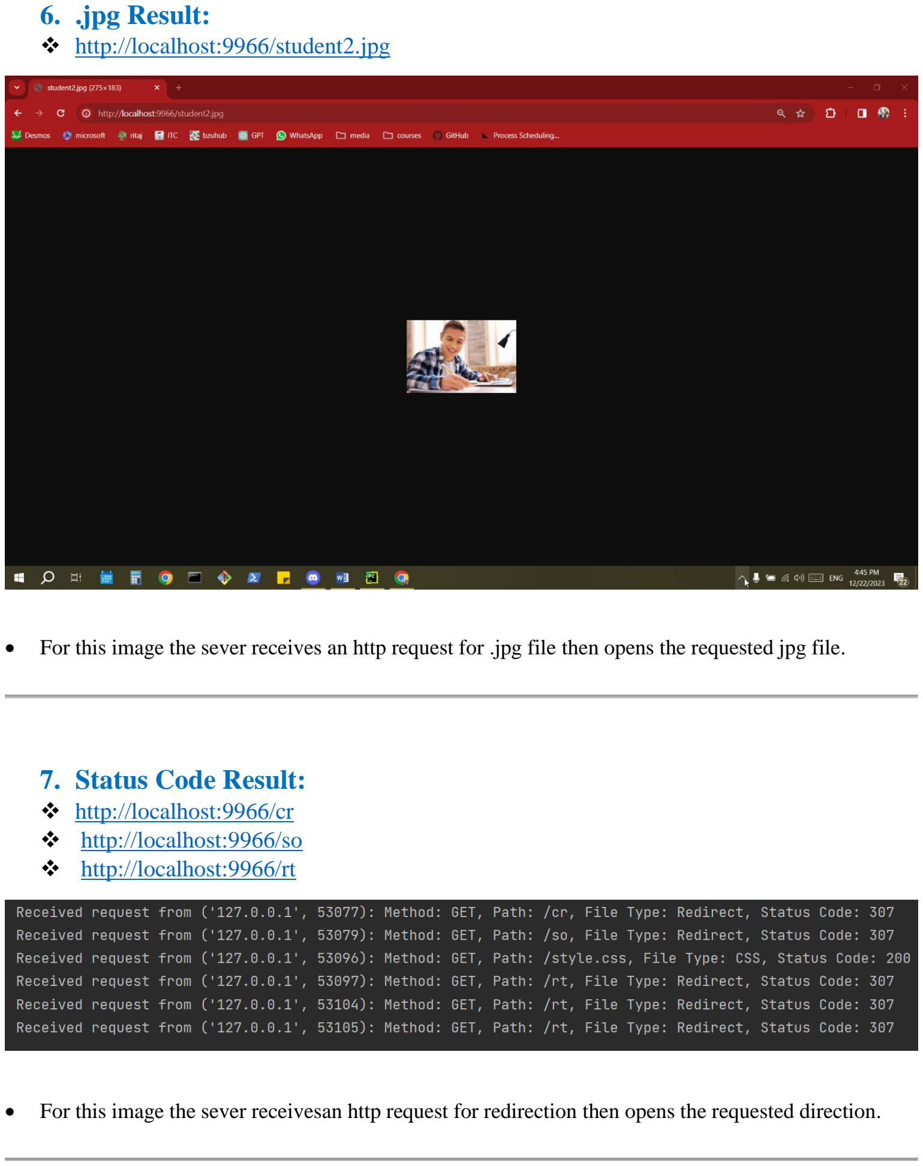
[picture p43: page 23]

- For this image the sever receives an http request for .jpg file then opens the requested jpg file.

## 7. Status Code Result:

## ❖ http://localhost:9966/cr ❖ http://localhost:9966/so ❖ http://localhost:9966/rt

- For this image the sever receivesan http request for redirection then opens the requested direction.

## 8. The Result if the File doesn't Exist:

## ❖ http://localhost:9966/any_does_not_exist_url_:)

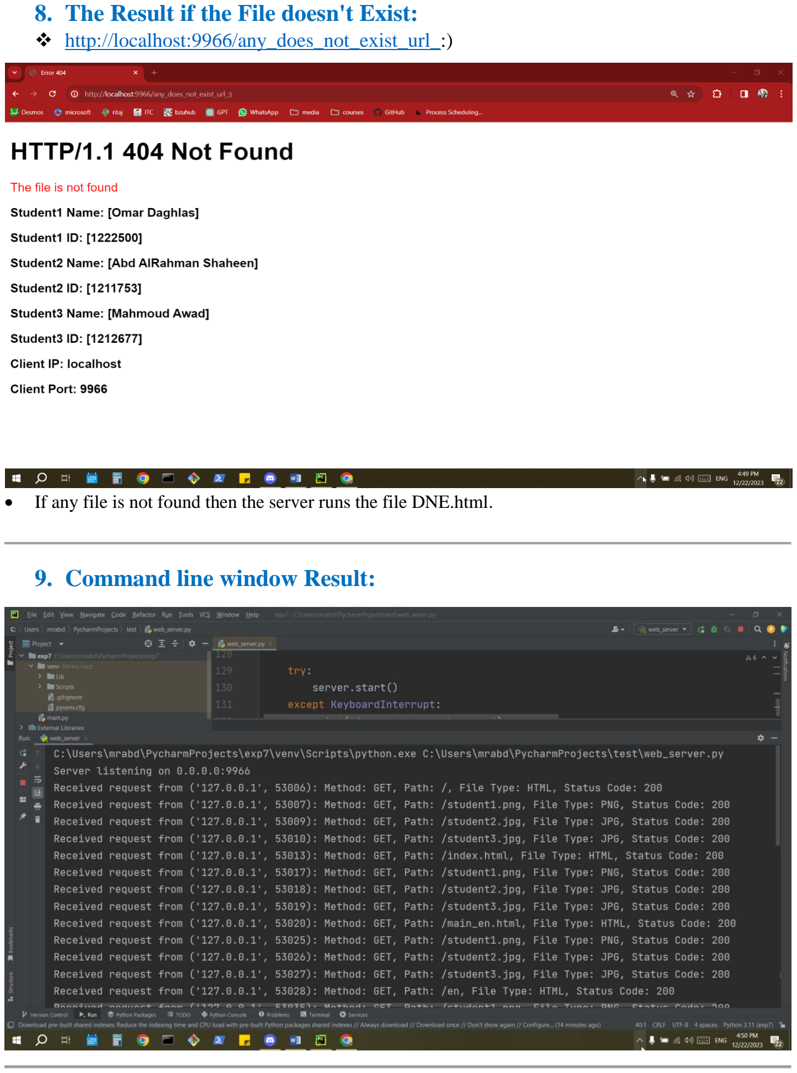
[picture p44: page 24]

- If any file is not found then the server runs the file DNE.html.

## 9. Command line window Result:

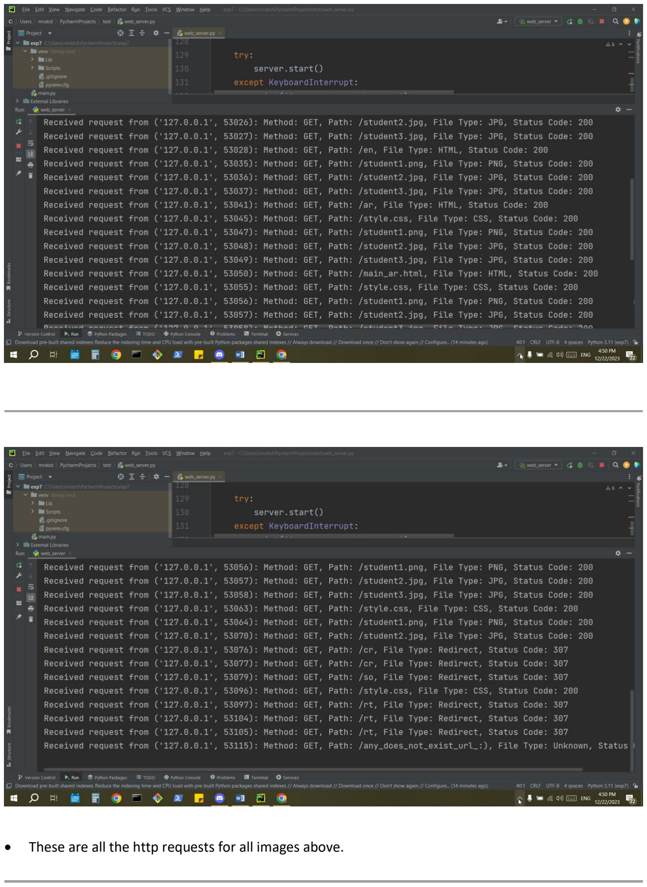
[picture p45: page 25]

- These are all the http requests for all images above.

## - A device on the same Network:

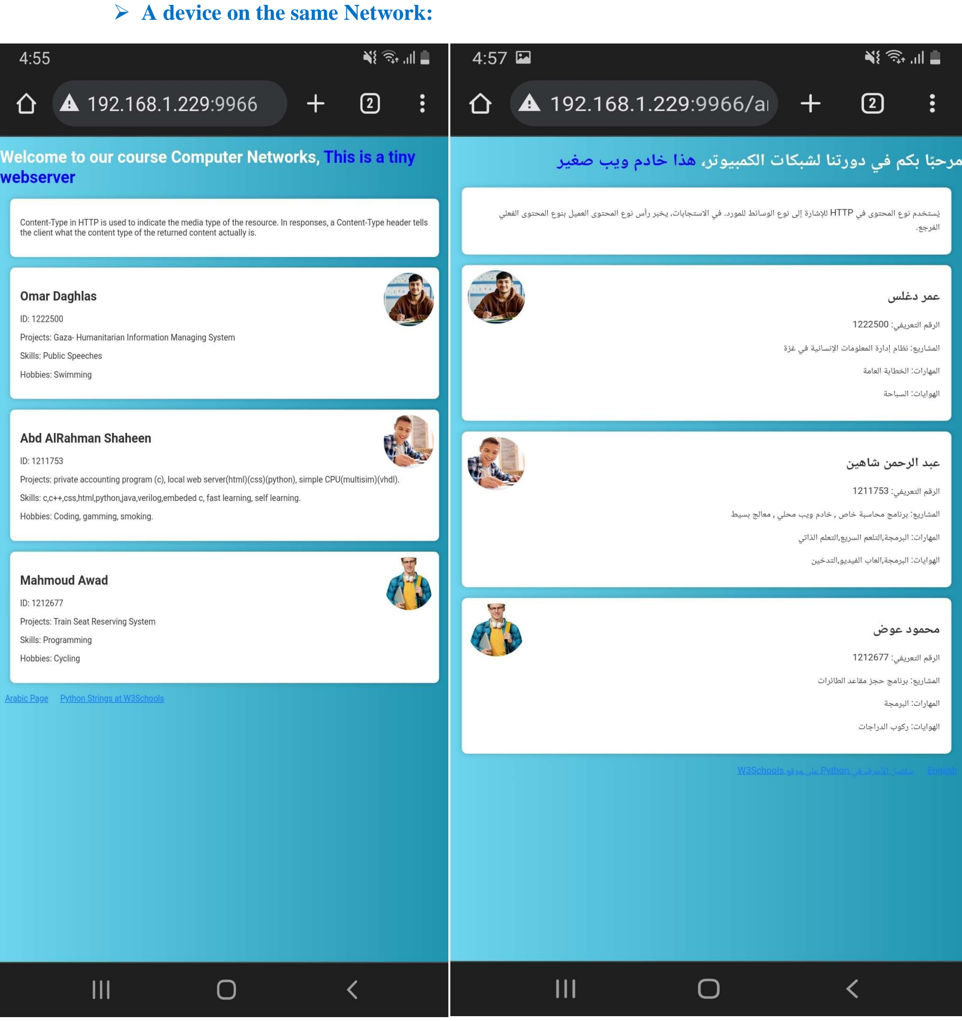
[picture p46: page 26]

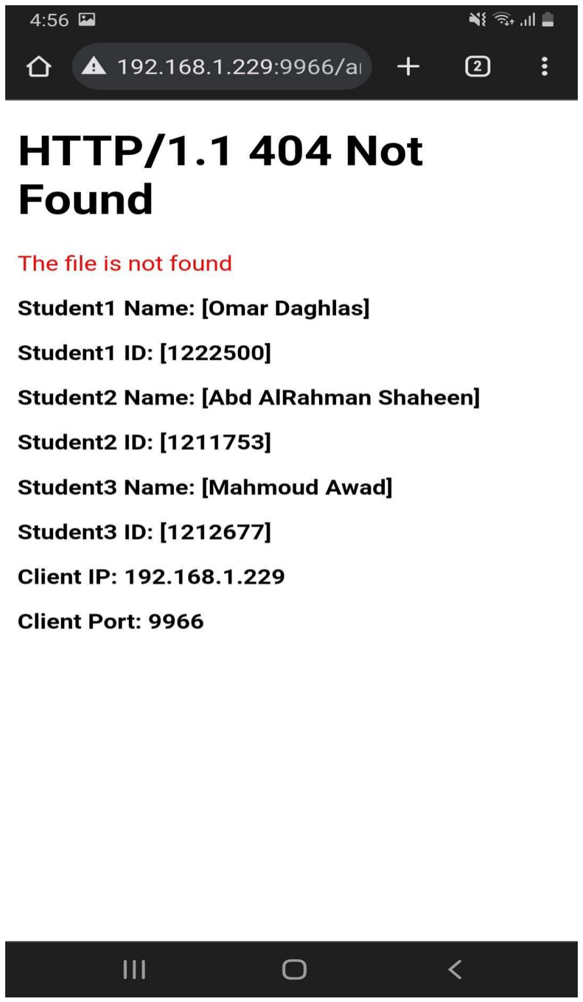
[picture p47: figure]

- These are the runs of my phone on the same network.
