MrAbdalrahman/university/circuit_analysis/pspice.pdf

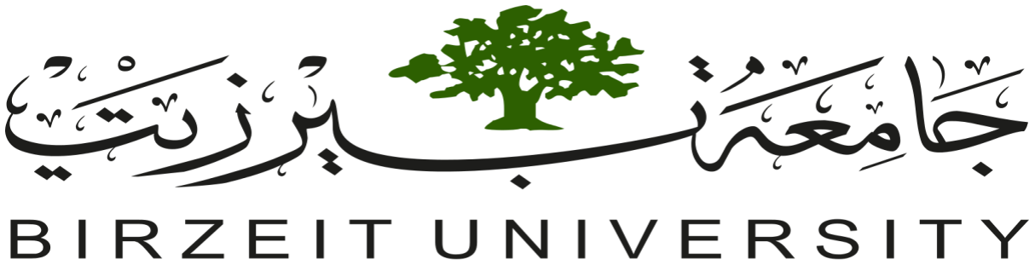
[picture p55: figure]

Electrical and computer engineering department.

Circuit analysis (ENEE 2304).

PSPICE assignment.

Student name: Mr. Abdalrahman Shaheen

Student ID:1211753.

Instructure: Dr. Hakam Shehadeh.

Date: 24/6/2023.

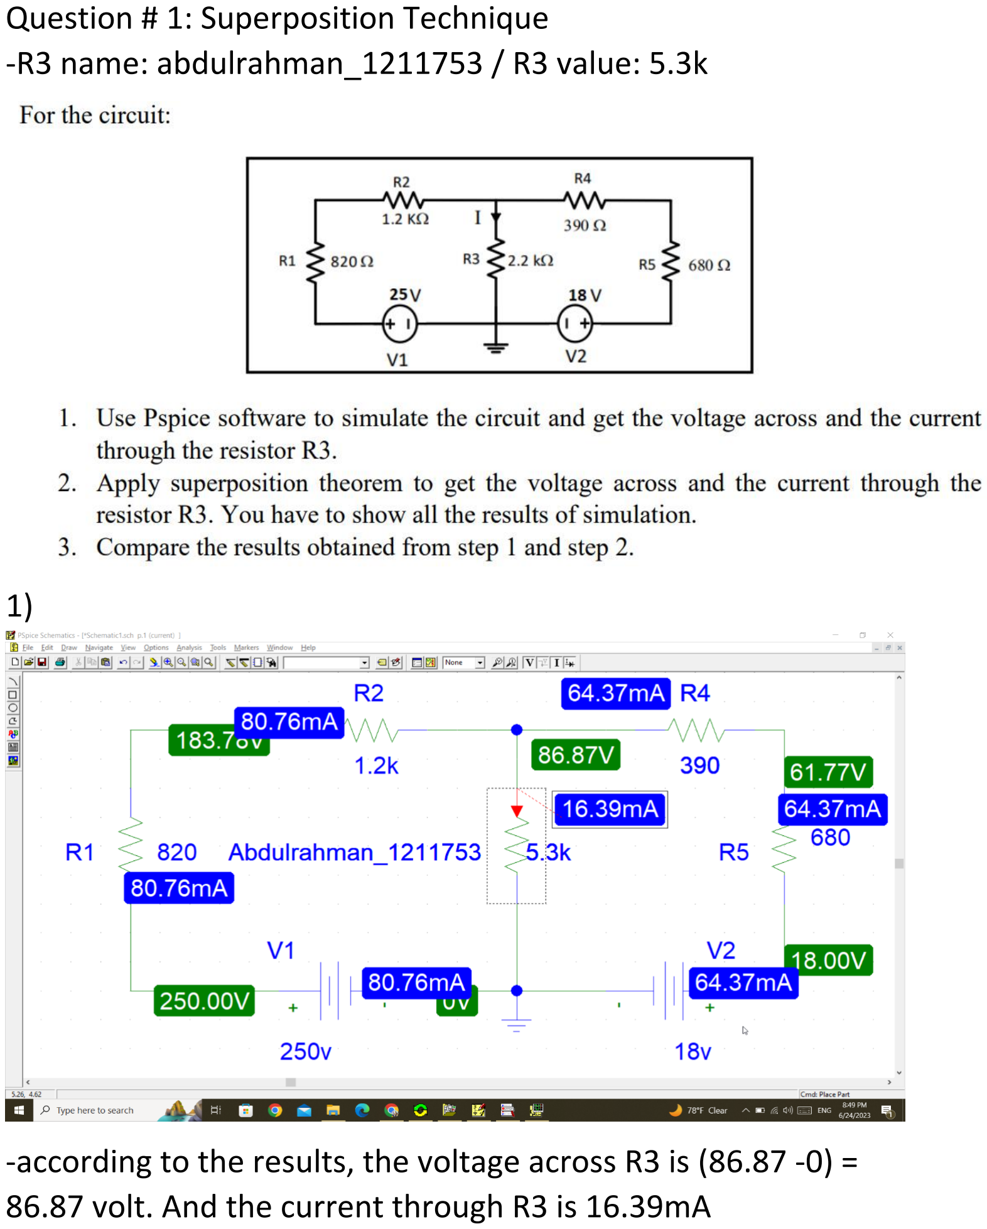
[picture p56: page 2]

Question # 1: Superposition Technique
-R3 name: abdulrahman_1211753 / R3 value: 5.3k

1)

-according to the results, the voltage across R3 is (86.87 -0) = 86.87 volt. And the current through R3 is 16.39mA

2) We need to apply superposition theorem.
- let's start from (I and V) by v1:

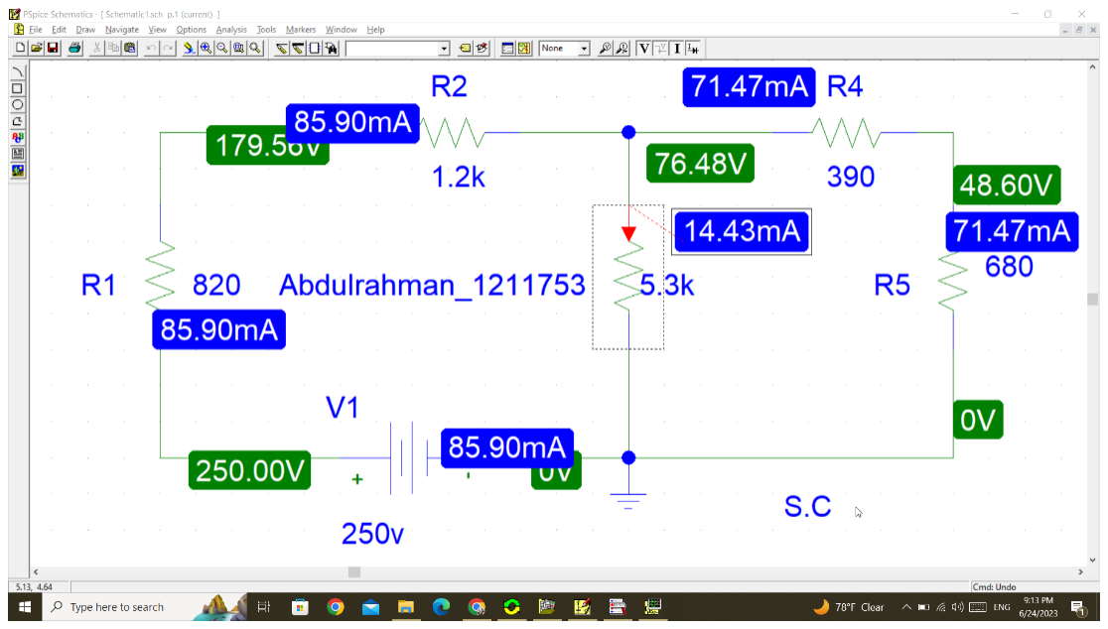
[picture p57: figure]

-V by v1 is 76.48 volt and I is 14.43mA

V0 = 76.48 volt, I0 = 14.43mA

- Now (v and I) by v2:

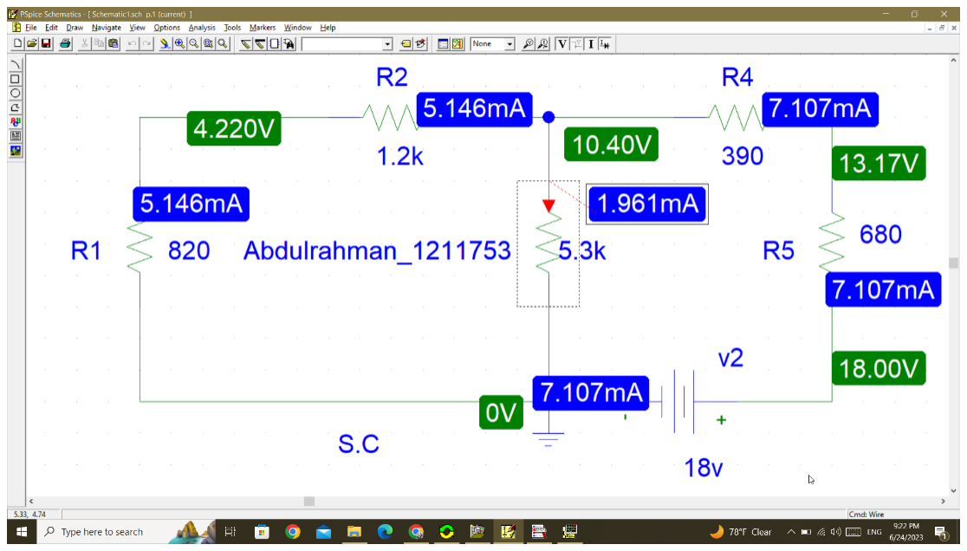
[picture p58: figure]

-V by v2 is 10.40 volt and I is 1.961mA

V1 = 10.40 volt, I1 = 1.961mA

-using superposition theorem:

-V on R3 should equal to V0 + V1:

V0 + V1 = 76.48 + 10.40 = 86.88 volt

-I on R3 should equal to I0 + I1:

I0 + I1 = 14.34m + 1.961m = 16.301 mA

3) V3 = 86.88 volt ≈ 86.87 volt (correct). I3= 16.301 mA ≈ 16.39 mA (correct).

Question #2: Thevenin's Theorem & Maximum Power Transfer

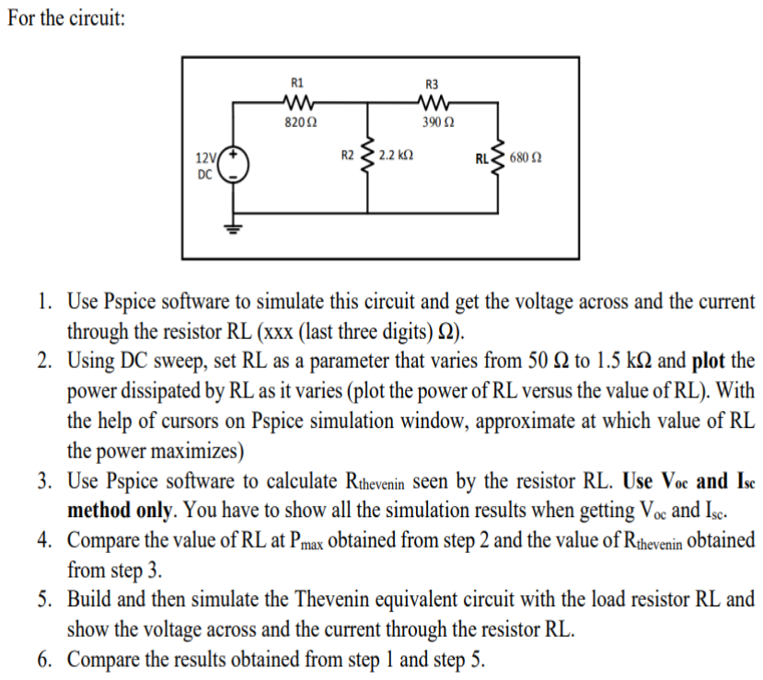
[picture p59: figure]
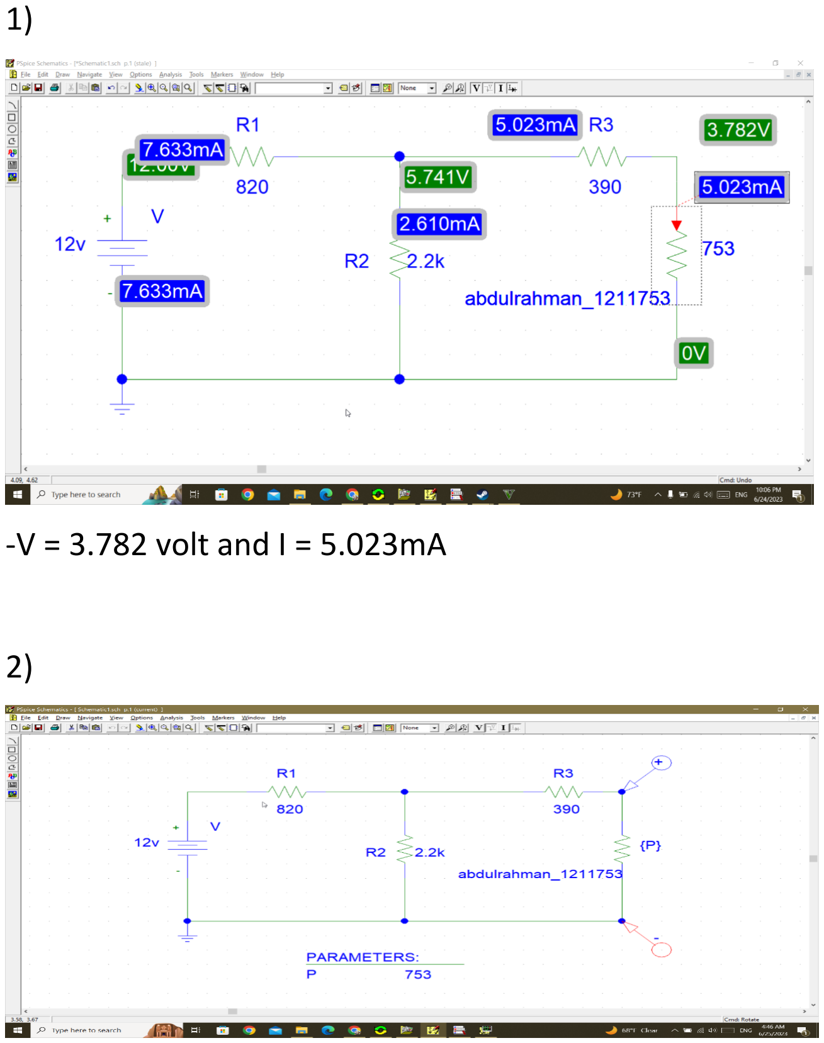
[picture p60: page 6]

1)

-V = 3.782 volt and I = 5.023mA

2)

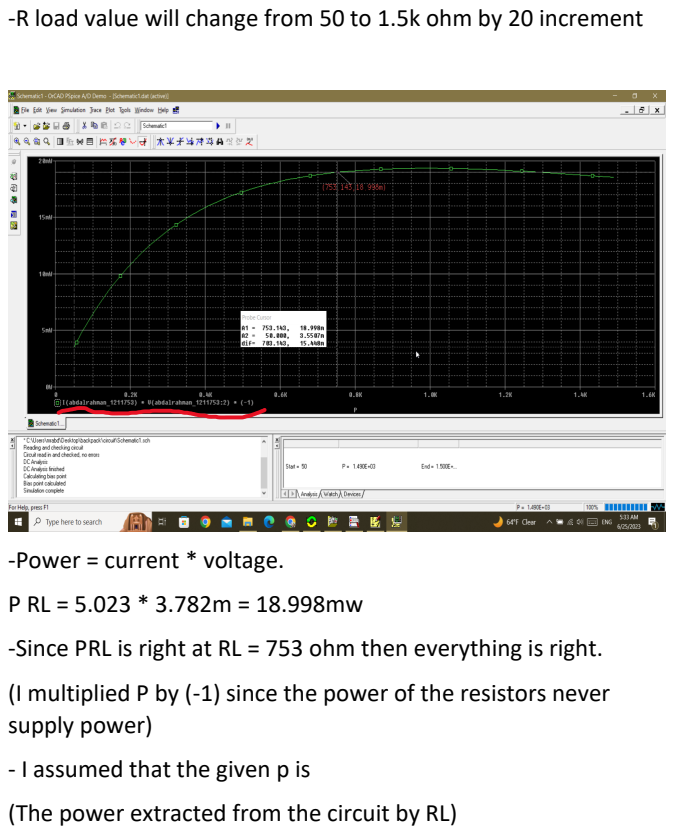
[picture p61: page 7]

-R load value will change from 50 to 1.5k ohm by 20 increment

-Power = current * voltage.
-Since PRL is right at RL = 753 ohm then everything is right.
(I multiplied P by (-1) since the power of the resistors never
supply power)
- I assumed that the given p is
(The power extracted from the circuit by RL)

-By using curser peak tool, I managed to get the value of RL when p is max

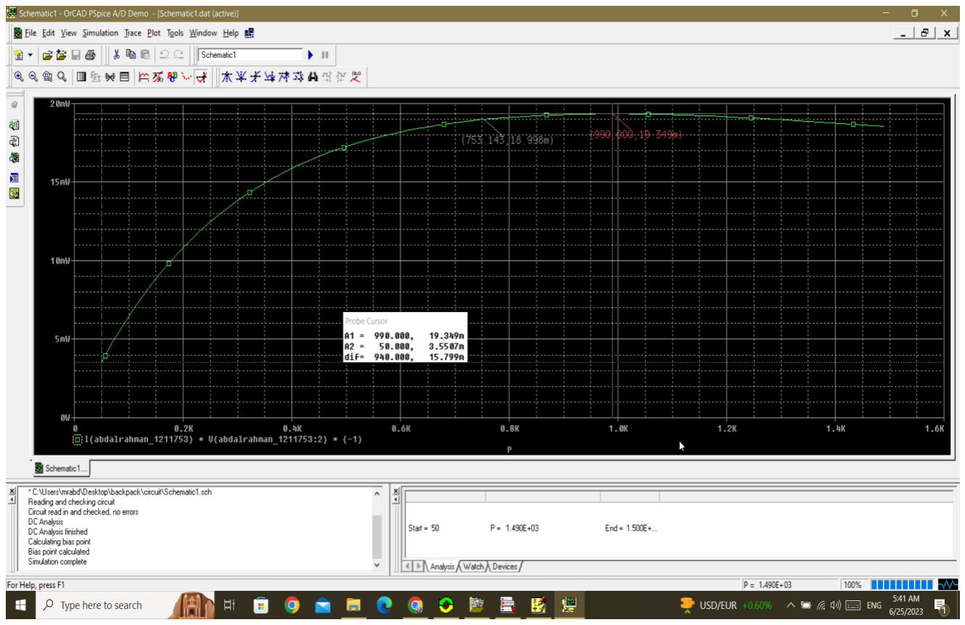
[picture p62: figure]

-As shown in the plot RL = 990 ohm when p is max.

3)

Voc:

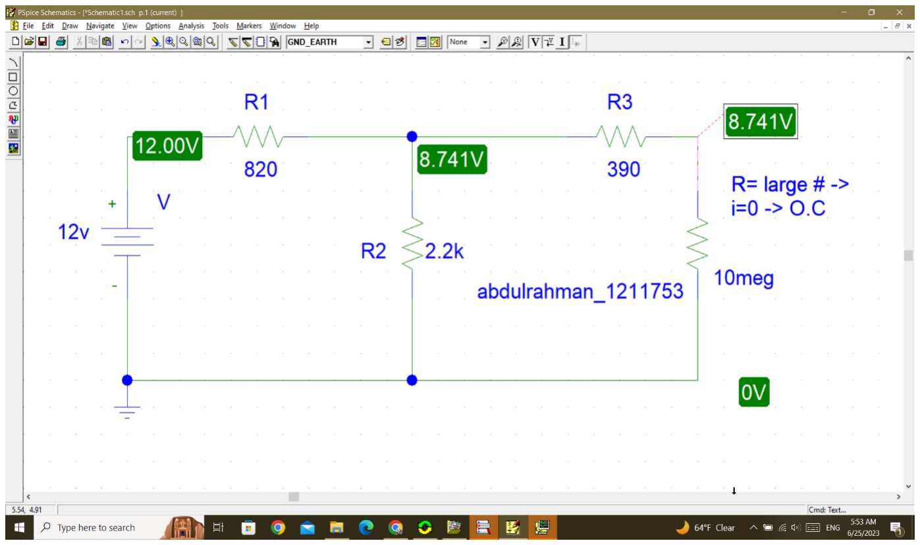
[picture p63: figure]

Voc =8.741 volt.

Isc:

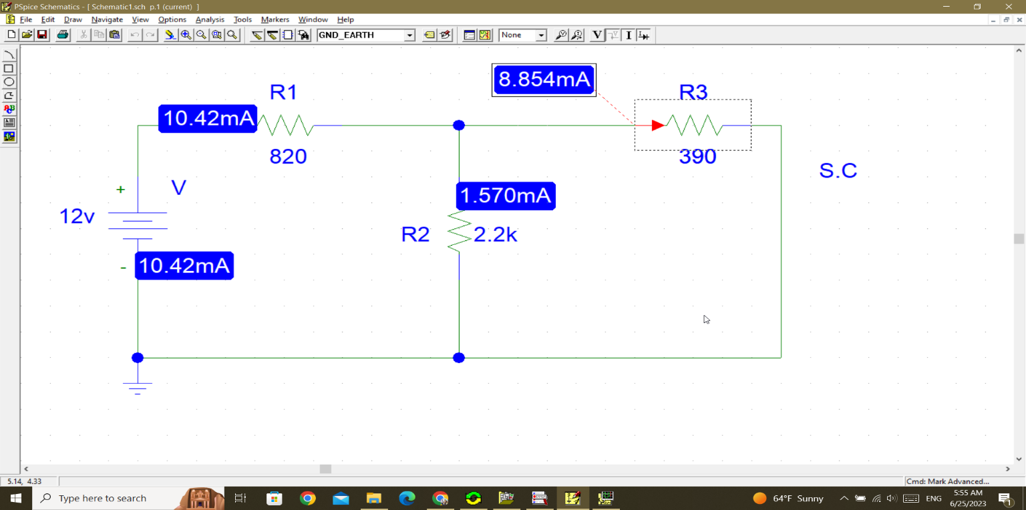
[picture p64: figure]

Isc = IR3 = 8.854mA

-Rth = Voc/Isc = 8.741 / 8.854m = 987 ohm.

- RL when Pmax = Rth = 987 ohm

4)

-from step 2 RL at Pmax = 990 ohm

- from step 3 RL at pmax = 987 ohm

5)

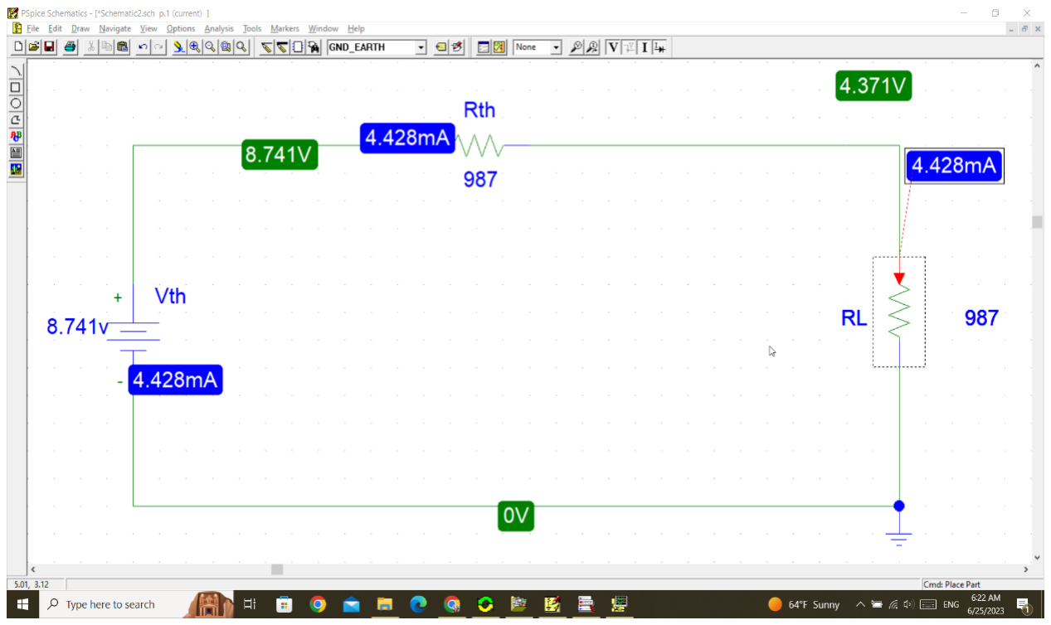
[picture p65: figure]

V = 4.371 volt and I = 4.428mA

6)

In step 1: V = 3.782 volt and I = 5.023mA

But in step 5: V = 4.371 volt and I = 4.428mA

Question # 3: Sinusoidal Steady State Analysis

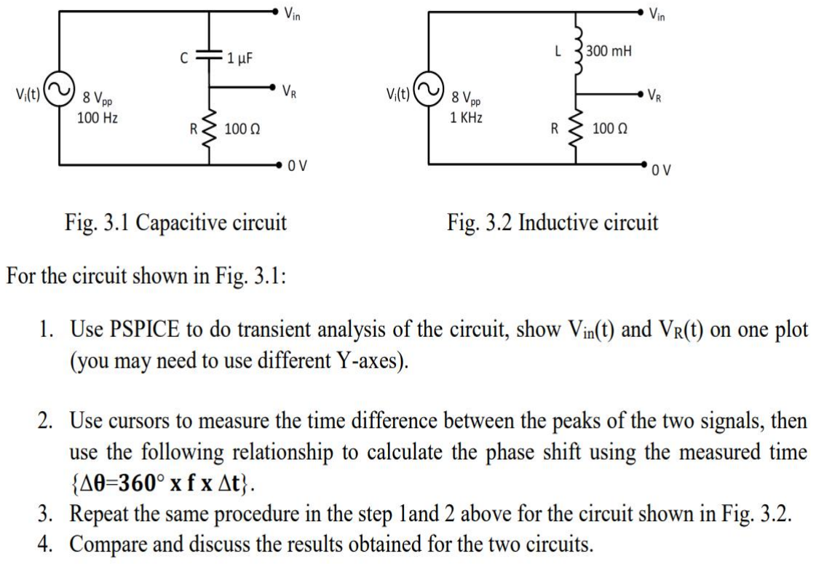
[picture p66: figure]
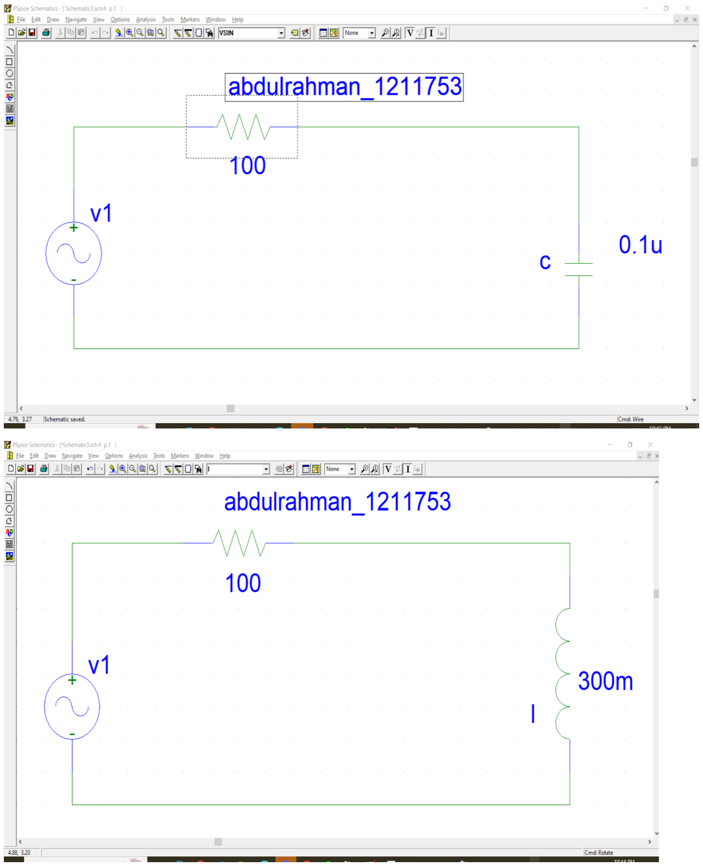
[picture p67: page 13]

1 + 2)

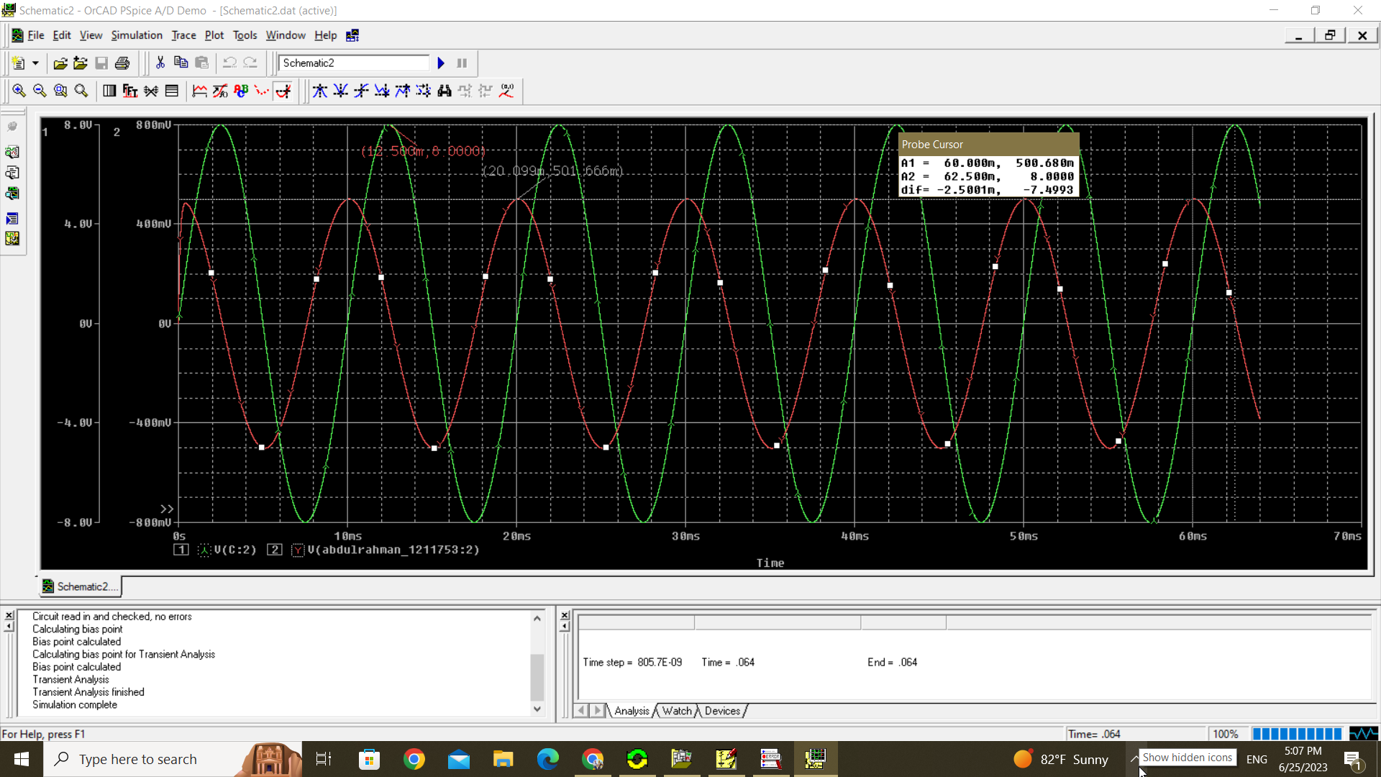
[picture p68: figure]

Δθ=360° * f * Δt
Δt = -2.5 ms

f = 100 hz
Δθ = 360° * 100 *-2.5m = -90°

-When the voltage across a resistor and a capacitor is compared, a phase shift of 90 degrees is expected. This is due to the inherent behavior of capacitors in AC circuits.

3)

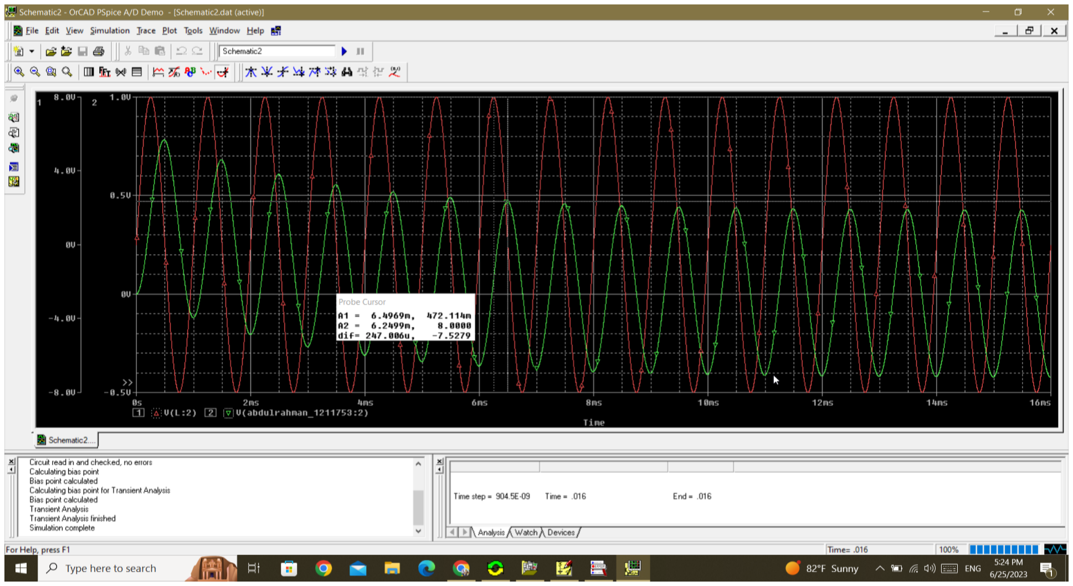
[picture p69: figure]

θ=360° * f * Δt
Δt = -241 us

f = 1k hz
Δθ = 360° * 1000 *247u = 88.92° ≈ 90°.

When comparing the voltage across a resistor and an inductor in an AC circuit, a phase shift of 90 degrees is expected because of the inherent behavior of inductors.

4)
Voltage across a Resistor and an Inductor (R and L):
- The voltage across a resistor and an inductor in series will have a phase shift between them. The voltage across the inductor lags the voltage across the resistor by 90 degrees.

Voltage across a Resistor and a Capacitor (R and C):

- The voltage across a resistor and a capacitor in series will also have a phase shift between them. The voltage across the capacitor leads the voltage across the resistor by 90 degrees.
Question #4: First Order RC Circuit Analysis

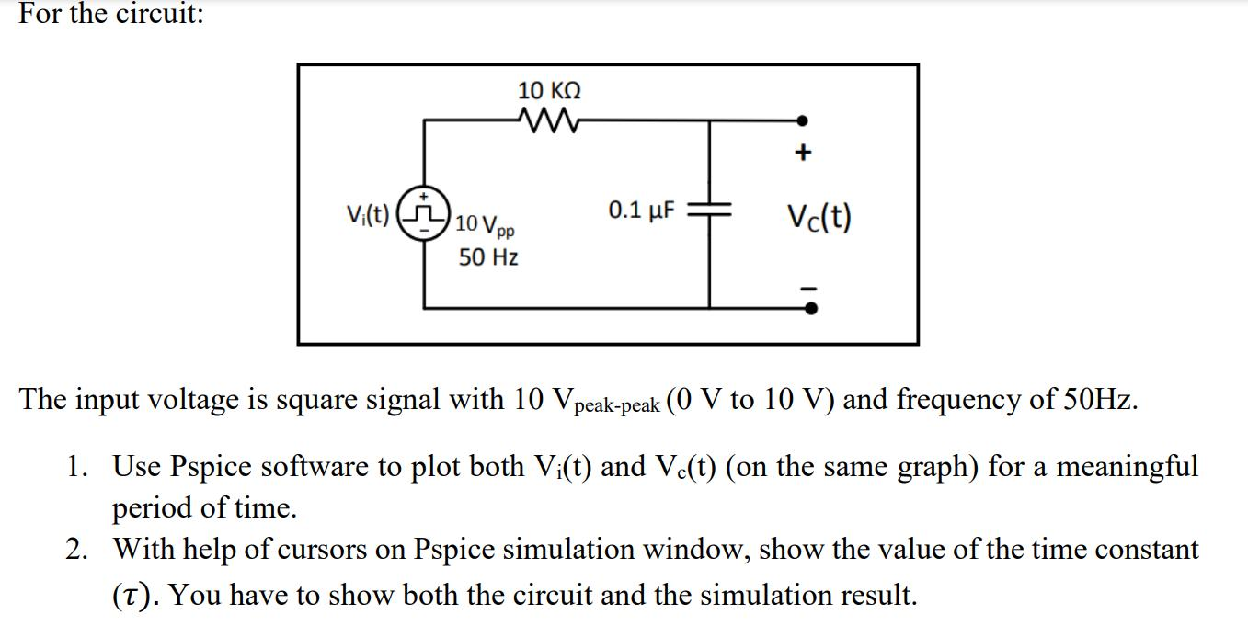
[picture p70: figure]

1)

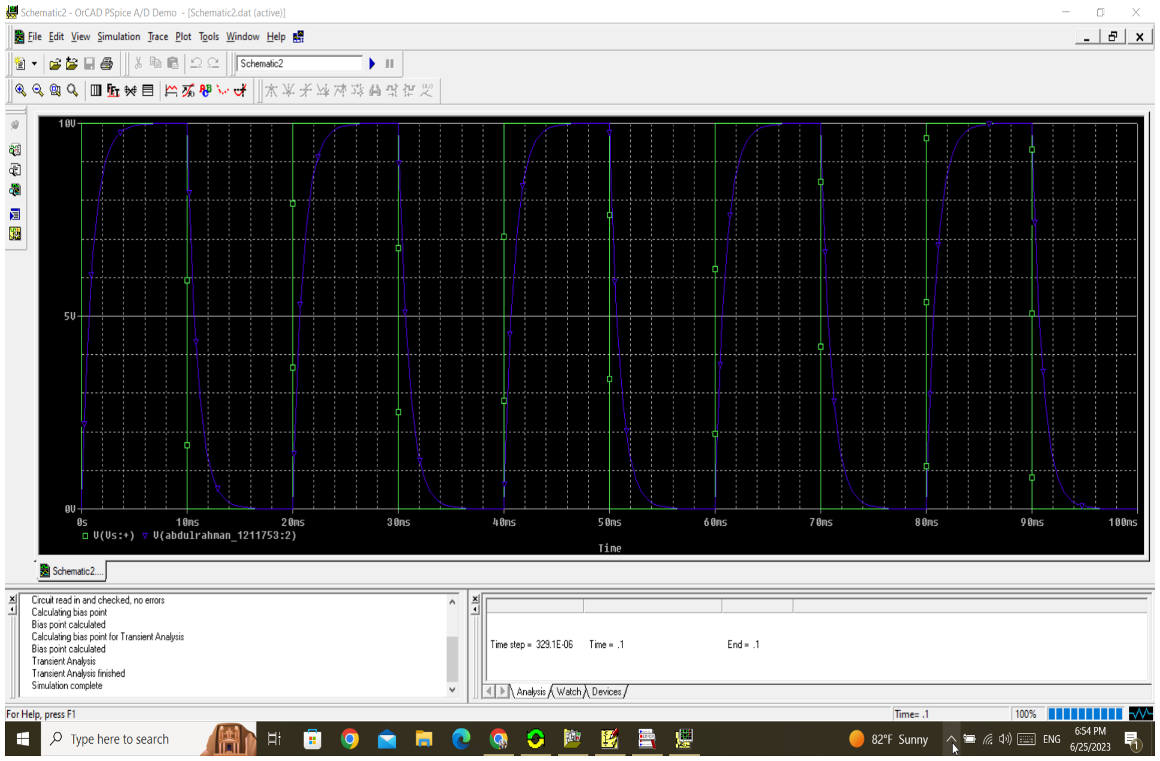
[picture p71: figure]

2) the RC circuit's time constant is defined as the product of the resistance and capacitance values (RC), representing the time it takes for the capacitor to charge or discharge to 63.2% of its maximum voltage.

In this circuit time constant = 0.1u * 10k = 1ms

And by the graph you can calculate it by finding 63.2% of the vc when its full charged -> 63.2% * 10 volt = 6.5891, then the time by this voltage value is time constant = 1ms

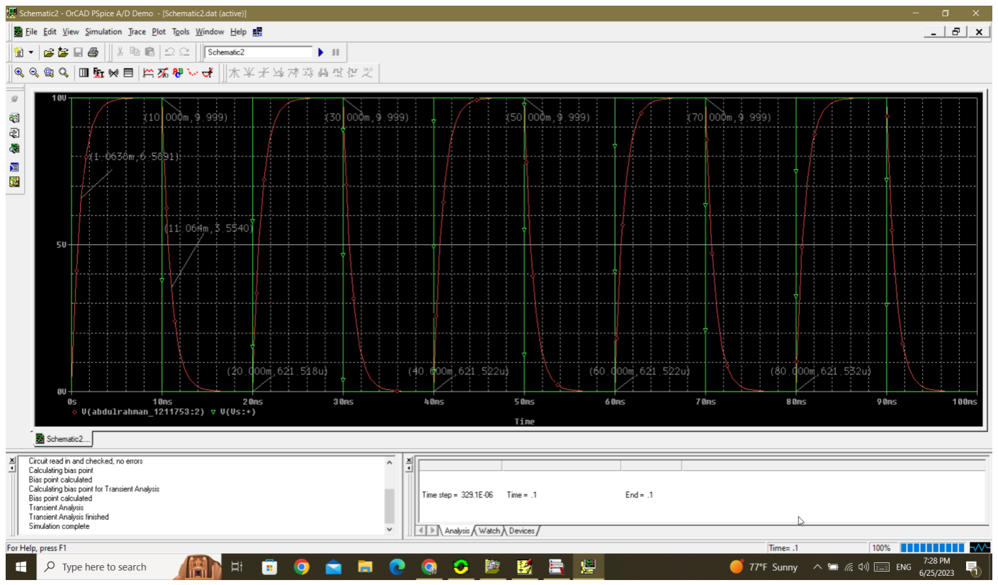
[picture p72: figure]

-As shown in the figure the maximum voltage in the capacitor when it’s fully charged Is 10 volts.

The voltage on t= time constant = 6.5891 volt ≈ 63.2% of 10 volt.

- likely the voltage when time constant passed after 10ms (t = 11ms) the voltage in the capacitor is decreased to 3.5540 volt which means the voltage decreased from 10 volt to 3.5540 volt is 63.2%of 10 volts.

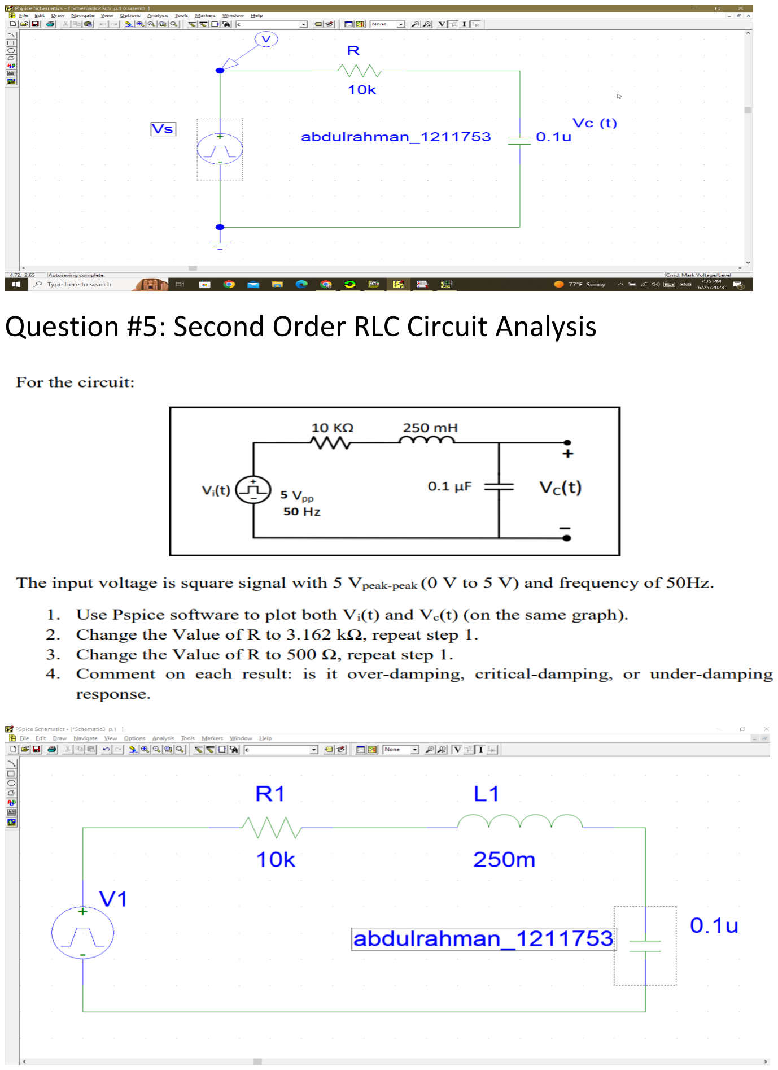
[picture p73: page 19]

Question #5: Second Order RLC Circuit Analysis

1)

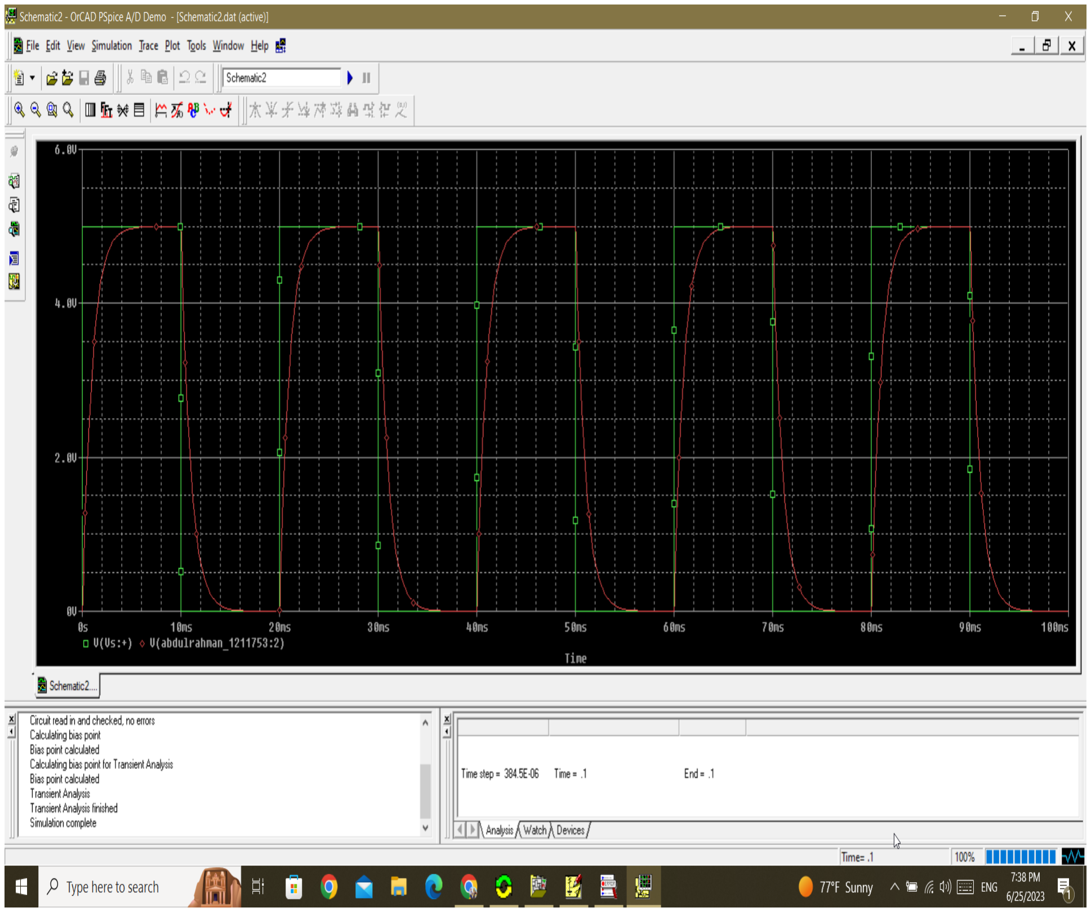
[picture p74: figure]

R=10k, alpha= 20000, Wo = 6324

Alpha > Wo ---> over damped

2)

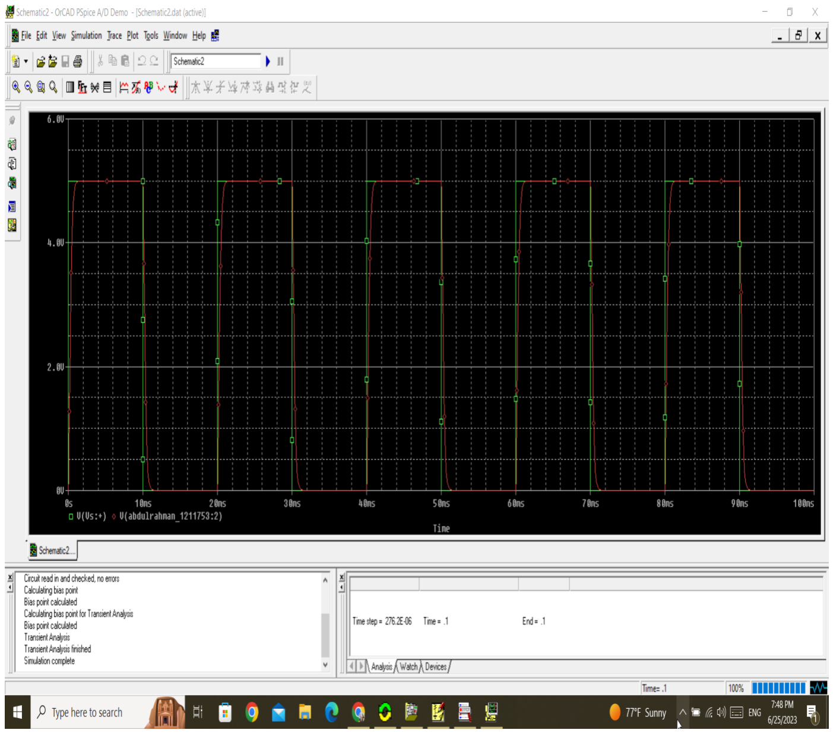
[picture p75: figure]

R=3.162k, alpha= 6324, Wo = 6324

Alpha = Wo ---> critically damped

3)

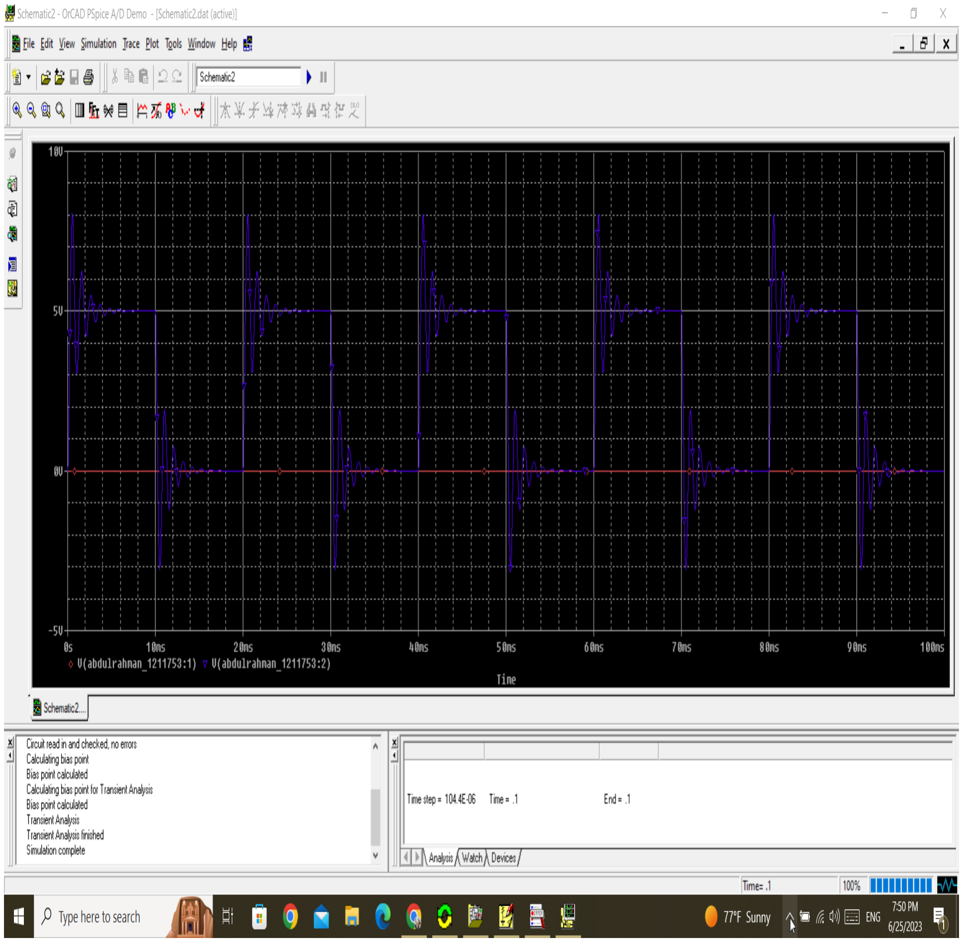
[picture p76: figure]

R=500, alpha= 1000, Wo = 6324

Alpha < Wo ---> under damped

(You also can see the state via graphs.)
