MrAbdalrahman/university/computer_applications/exp_8/Exp8_UART.pdf

### Electrical and Computer Engineering

Computer Design Lab – ENCS4110

## Serial Communication

Objectives:

1. To be familiar with the USART (RS-232) protocol.
2. To be able to transfer data from LPC-PC, PC-LPC and LPC-LPC.
3. To test serial communications with virtual serial ports with Keil and Proteus programs tools.

Introduction

Serial communications is the process of sending data one bit at one time, sequentially, over a communications channel or computer bus. This is in contrast to parallel communications, where all the bits of each symbol are sent together. Serial communications is communications and most computer networks, where the cost of cable and synchronization difficulties makes parallel communications impractical.

Serial computer buses are becoming more common as improved technology enables them to transfer data at higher speeds. Examples of serial communication architectures includes: RS-232, RS-485, Universal Serial Bus (USB), SPI, I2C and others. Serial interfaces have certain advantages over parallel interfaces. The most significant advantage is simpler wiring. In addition, serial interface cables can be longer than parallel interface cables.

USART Protocol

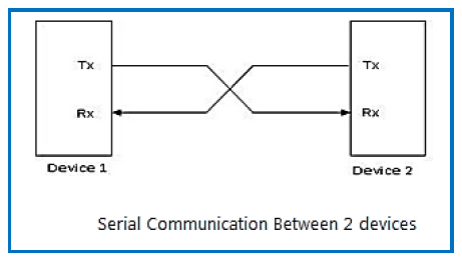
[picture p83: figure]

USART stands for the Universal Synchronous/Asynchronous Receiver/Transmitter.

- Universal means that it can be used with a wide scope of devices
- Synchronous devices that communicate with each other require an external synchronization line (the clock).
- Asynchronous The Asynchronous mode (without the common clock) is easier to implement, although it is generally slower than the synchronous. It is also the older way – The COM port in the PC uses the UART, therefore it named as UART (without S).
- Receiver/Transmitter means that this device can receive and transmit (send) data simultaneously. It is also called the two-way or full duplex communication.

USART Asynchronous Mode

Asynchronous transmission allows data to be transmitted without the sender having to send a clock signal to the receiver. In the case, the sender and receiver must agree on timing parameters(Baud Rate) prior transmission and special bits are added to each word to synchronize the sending and receiving units. The sender sends a Start bit, 5-8 data bits, an optional parity bit, and 1-2 stop bits.

TTL Level

Most microcontrollers with USART uses TTL (Transistor-transistor Logic) level.

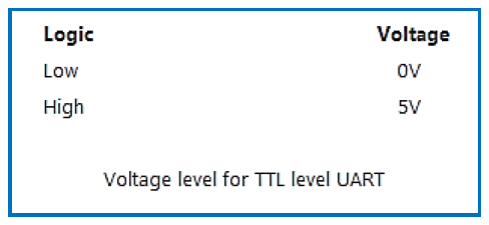
[picture p84: figure]

The USART transmits and receives data using standard non-return-to-zero (NRZ) format. As seen in figure below, this mode does not use clock signal, while the data format being transferred is very simple:

Briefly, each data is transferred in the following way:

- In idle state, data line has high logic level (1);
- Each data transmission starts with START bit which is always a zero (0);
- Each data is 8- or 9-bit wide (LSB bit is first transferred); and
- Each data transmission ends with STOP bit which always has logic level which is always a one (1).

For example Data is H’90’ = B’01011010’ (LSB bit is first transferred)

Each USART contains a shift register which is the fundamental method of conversion between serial and parallel forms. After waiting a further bit time, the state of the line is sampled and the resulting level clocked into a shift register. After the required number of bit periods for the character length (8 ,9 bits typically) have elapsed, the contents of the shift register is made available.

RS-232

The RS-232 standard defines the voltage levels that correspond to logical one and logical zero levels for the data transmission and the control signal lines. Valid signals are plus or minus 3 to 15 volts - the range near zero volts is not a valid RS-232 level.

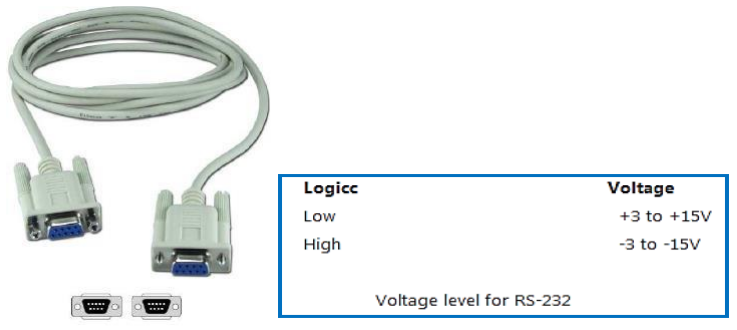
[picture p85: figure]

Pin | Signal abbreviation | Signal Name | DTE (PC)
1 | DCD | Data Carrier Detect | In
2 | RXD | Receive Data | In
3 | TXD | Transmit Data | Out
4 | DTR | Data Terminal Ready | Out
5 | GDN | Signal Ground | -
6 | DSR | Data Set Ready | In
7 | RTS | Request to Send | Out
8 | CTS | Clear to Send | In
9 | RI | Ring Indicator | In

UART Programming

The LPC2138 has two UARTs called UART0 and UART1. The two are identical except that UART1 has some additional functions that make it easier to control a modem. The interface to the outside world is by way of two pins: the transmit pin is TXD0 and the receive pin is RXD0. UART0 has eleven registers which are shown in the table below.

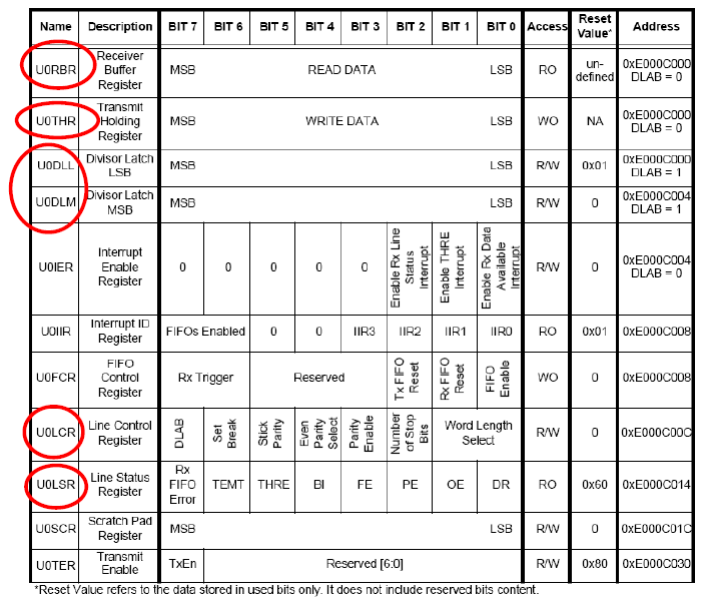
[picture p86: figure]

To use the UART for simple transmission and reception we need to set up the prescaler divider registers (U0DLM and U0DLL), the line control register (U0LCR), pclk (VPBDIV), and the pin select register to enable the UART pins for transmit and receive (PINSEL0). The remaining register reset states allow the UART to run.

To transmit data you write the U0 transmit holding register (U0THR) and to receive data you read it from the U0 Receive Buffer Register (U0RBR).

The Line Status Register can be used to determine if the UART has a character to read or if its transmit buffer is empty. Since the processor can read and write much faster than the UART can transmit data, you must always check the bits in these registers to determine the UART status before reading or writing.

Line Control Register

The Line Control Register U0LCR bit description is shown in table 5.2 below. This register is used to determine such things as the number of stop bits, even or odd parity, etc.

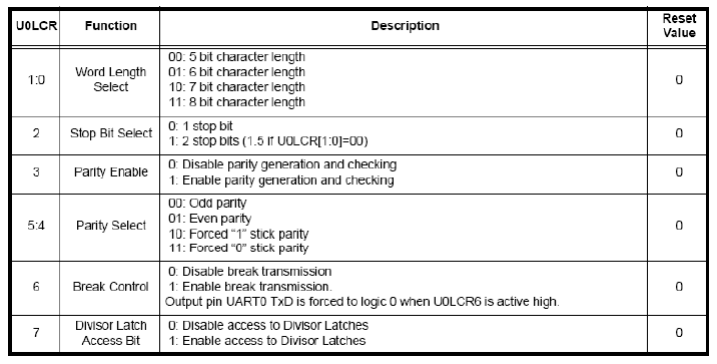
[picture p87: figure]

For our applications in this lab we will have an 8-bit character length, 1 stop bit, disabled parity checking, disabled break control, and we will enable access to the Divisor latches. For example :

U0LCR = 0x83; //8-bit, 1 stop bit, no parity, enable divisor latch

Pin Select Register

The Pin Function Select (PINSEL) Registers enable you to select which pin functions you would like to use, you need to use one of the the three PINSEL registers: PINSEL0, PINSEL1 and PINSEL2. Which register you would use depends on which pin you want to modify.

PINSEL0 contains GPIO pins 0.0 to 0.15

PINSEL1 contains GPIO pins 0.16 to 0.31

PINSEL2 contains GPIO pins 1.16 to 1.31

Each pin of the controller is assigned a 2-bit address from the PINSEL register. For example, P0.0 uses the first two bits in PINSEL0, P0.1 uses the next two bits, and so on. The whole description is as following:

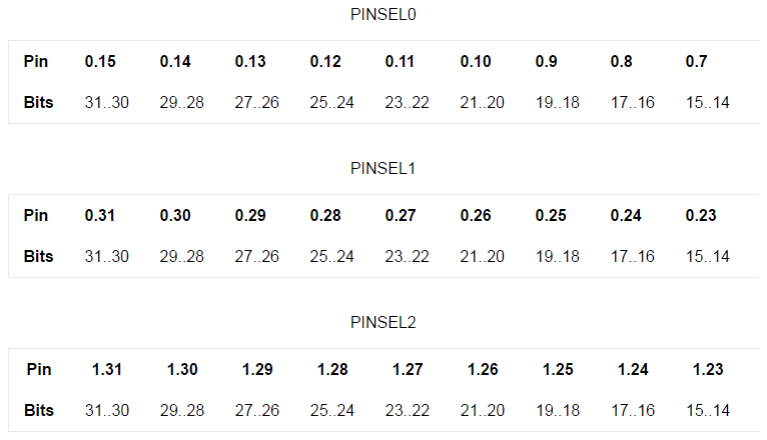
[picture p88: figure]

Now let us see what we have to do to select a specific function of a pinTo select a specific function you simply assign one the following 2-bit values to the appropriate location in your PINSEL register:

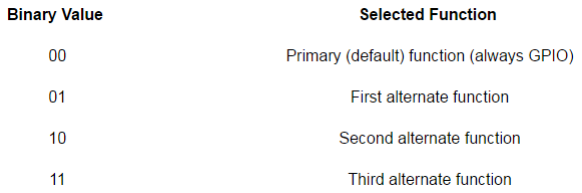
[picture p89: figure]

To enable UART0 I/O pins bits 3, 2, 1, and 0 should be set to 0101. (UART1 needs bits 19, 18, 17, and 16 set to 0101.

PINSEL0 = 0x5;

Baud Rate Prescale Registers

Both UARTs have their own baud rate generators. The input to these generators is the peripheral clock (pclk).

VPBDIV = 0x1; //make pclk = cclk = 30 MHz

then, the master formula for calculating baud rate is given as :

BAUD_RATE = PCLK IN HERTZ/(16 ×(256×DLM+DLL)×( 1+DIVADDVALMULVAL))

The quickest and also the dirtiest(accuracy wise) method without using any algorithm or finetuning is to set DLM=0 and completely ignore the fraction by setting it to 1. In this case MULVAL=1 and DIVADDVAL=0 which makes the Fraction Multiplier = 1. Now we are left with only 1 unknown in the equation which is U0DLL and hence we simplify the equation and solve for U0DLL.

U0DLL = PCLK IN HERTZ/(16 ×DESIRED_BAUDRTE)

Now for a baud rate of 9600 baud we want a divisor = pclk/(16 x 9600) = 195.3125. Rounding this to 195 = 0xC3 gives a true baud rate of 9615.

U0DLM = 0;
U0DLL = 0xC3;

Line Status Register

The line status register bit 0 and bit 5 definitions are shown in the table below.

Bit 0 in this register may be tested to determine if a character has been received and is in the buffer. Bit 5 can be used to determine if the transmit holding register is empty. To transmit a character we can poll bit 5 as shown below:

while (!(U0LSR & 0x20)); //Test bit 5

U0THR = ch; //When bit 5 = 1, load data to transmit ch

Likewise, to receive a character in a polling mode:

while (!(U0LSR & 0x01)); //Test bit 0

return (U0RBR); //When bit 0 = 1, get data from buffer

Lab Work 1

You are going to use these keywords when you search for parts in Proteus:

Part | Keyword
Microcontroller | LPC2138

Write a program that sends a text from LPC to PC.

Keil:

#define NEW_LINE 0x0D

#include <LPC213x.H>

void UART0_init(void);
int putchar (int ch);
void UART0_write_str(char *msg);

int main() {
char msg1[]="Welcome to Serial Communication Lab :)"; char msg2[] = "End";
UART0_init();
UART0_write_str(msg1);
putchar(NEW_LINE);
UART0_write_str(msg2);

while(1);

}

void UART0_init(void){
PINSEL0 = 0x5; /* Enable RxD0 and TxD0 */
U0LCR = 0x83; /* 8 bits, no Parity, 1 Stop bit */
U0DLL = 97; /* 9600 Baud Rate @ 12MHz VPB Clock */ U0LCR = 0x03; /* DLAB = 0 */
}

int putchar (int ch) /* Write single character to Serial Port */ {
while (!(U0LSR & 0x20));
return (U0THR = ch);
}

void UART0_write_str(char *str){ /* send string to the serial port */ int i=0;
while(str[i]!='\0'){
putchar(str[i]);
i++;
}
}

Proteus:

We will use virtual terminal (V.T.) for implementing PC.

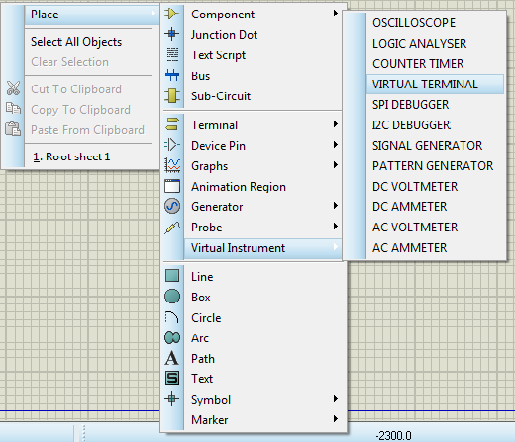
[picture p90: figure]

Double click << Change the baud rate to 9600

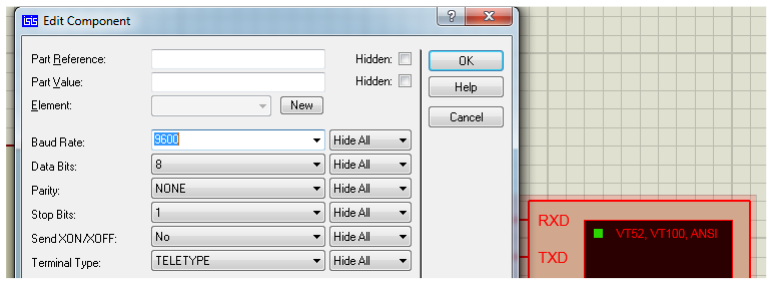
[picture p91: figure]

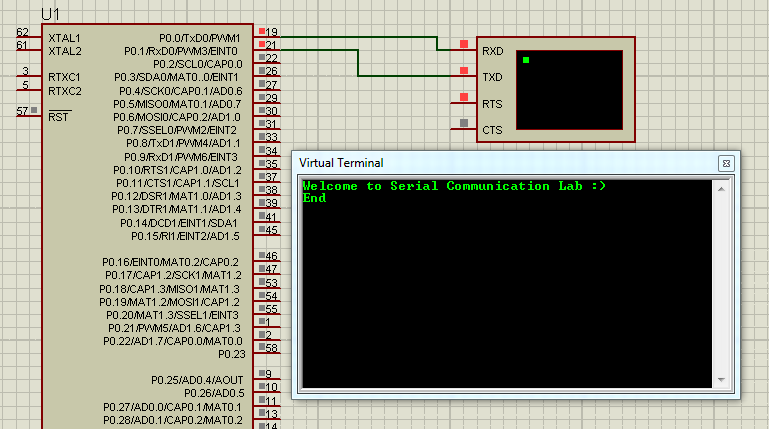
[picture p92: figure]

Lab Work 2

Write a program that sends a text from PC to LPC and view on LCD

Keil:

#include <lpc213x.H>

char UART0_read(void) {
while (!(U0LSR & 0x1)); //wait until the receiver buffer is full return(U0RBR);
}

Int main() {
unsigned char name[20] = "ENCS4110";
unsigned char msg1[50] = "Welcome to Serial Communication Lab:)"; unsigned char msg2[5] = "write here:";

IO1DIR = 0x00FE0000; /* LCD pins set as output P1.16 ..P1.19 */ UART0_init();
Delay(100);
UART0_write_str(msg1);
putchar(NEW_LINE);
UART0_write_str(msg2);
LCD_Init(); | /* Initialise LCD | */
Delay(100);
While(1)
{
LCD_Data(UART0_read());
Delay(50);
}
}

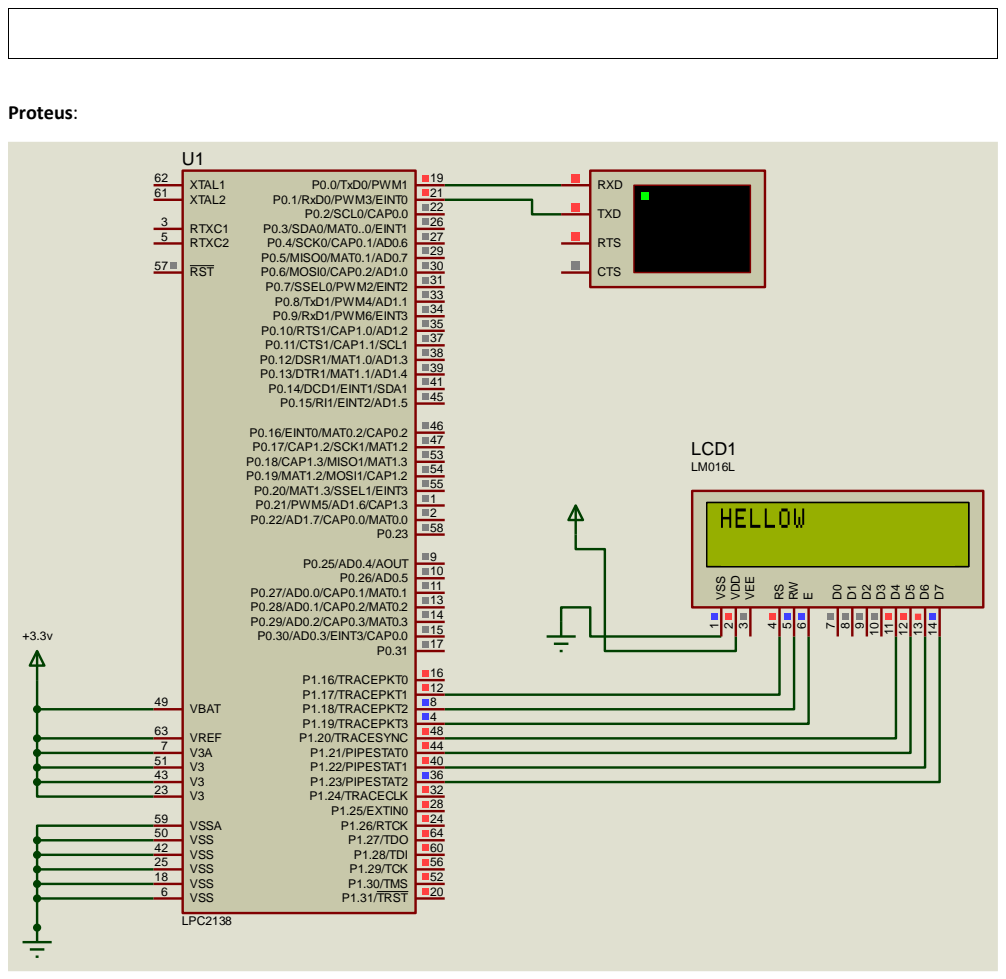
[picture p93: page 9]

Lab work3:

Write a program that sends the state of switch from master LPC to slave LPC(Leds).

Keil:

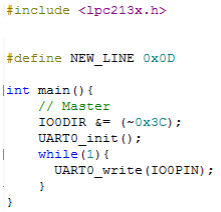
[picture p94: figure]

Proteus:

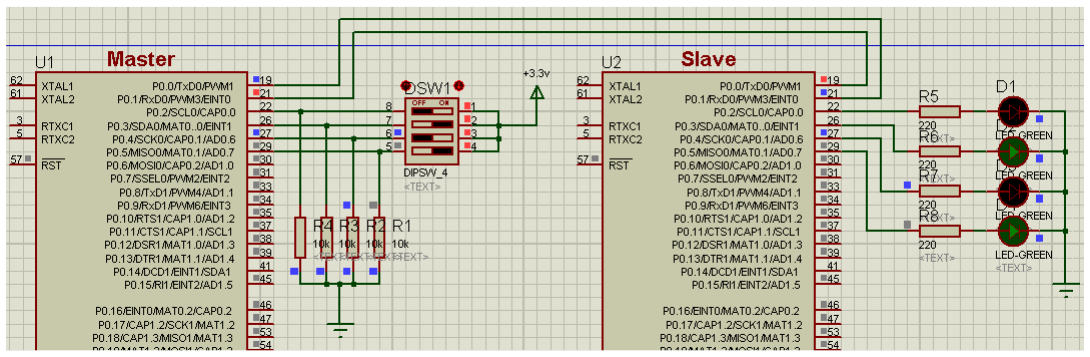
[picture p95: figure]

Post Lab (ToDo)

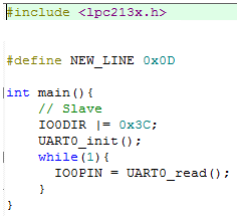
[picture p96: figure]

Write a program (and circuit) that shines the led connected to LPC if the PC (V.T.) entered “hi” word.
