MrAbdalrahman/university/digital_lap/assigments/post lap 3.pdf

post-Lab
Experiment No. 3 - Encoders, Decoders, Multiplexers, and Demultiplexers Logic Circuits. *Student name: Abdulrahman shaheen.
* ID#: 1211753.
* Instructor Name: Dr. Qadri Mayyala * Date: 14/4/2023.
* Section: 2.

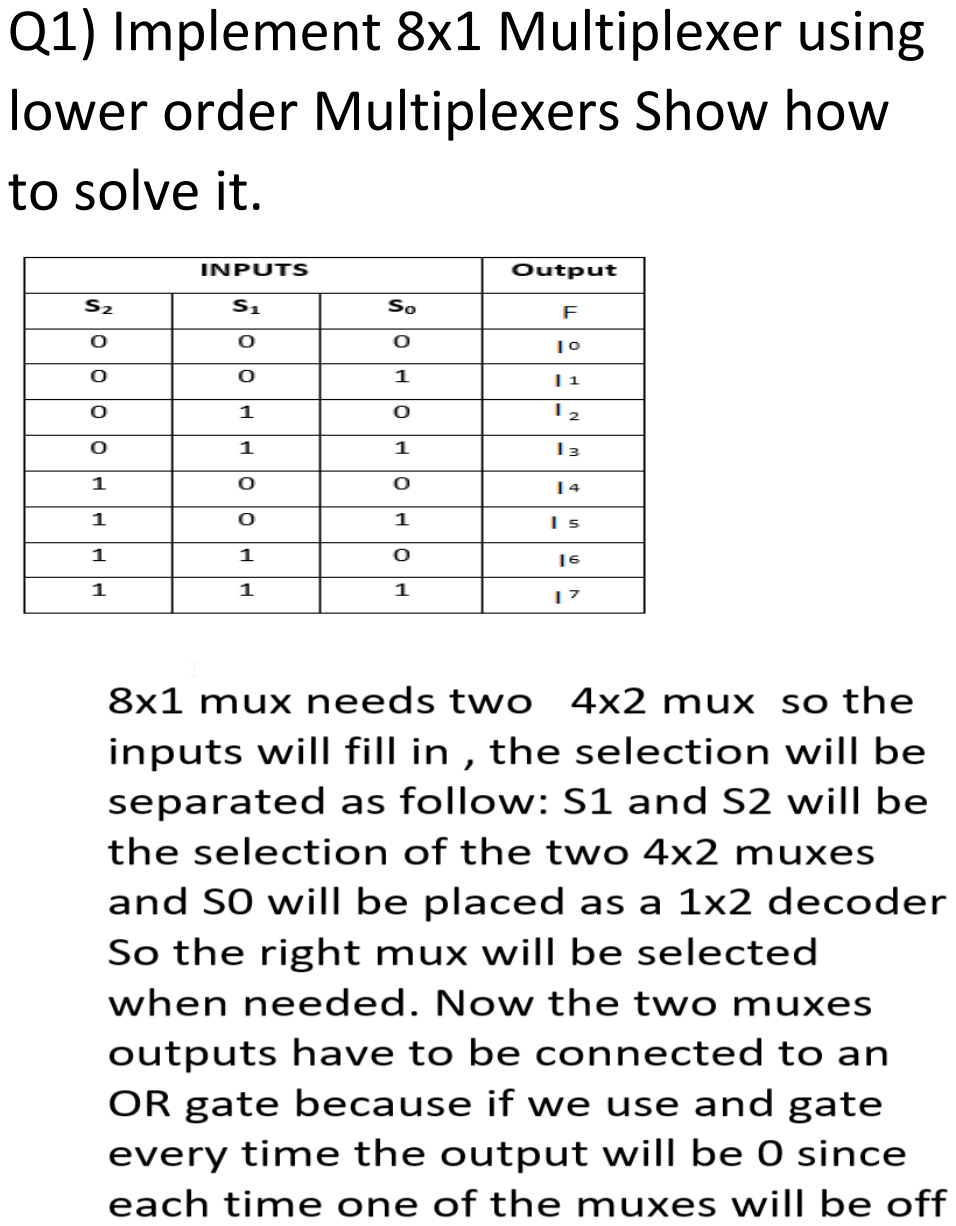
[picture p103: page 2]

Q1) Implement 8x1 Multiplexer using lower order Multiplexers Show how to solve it.

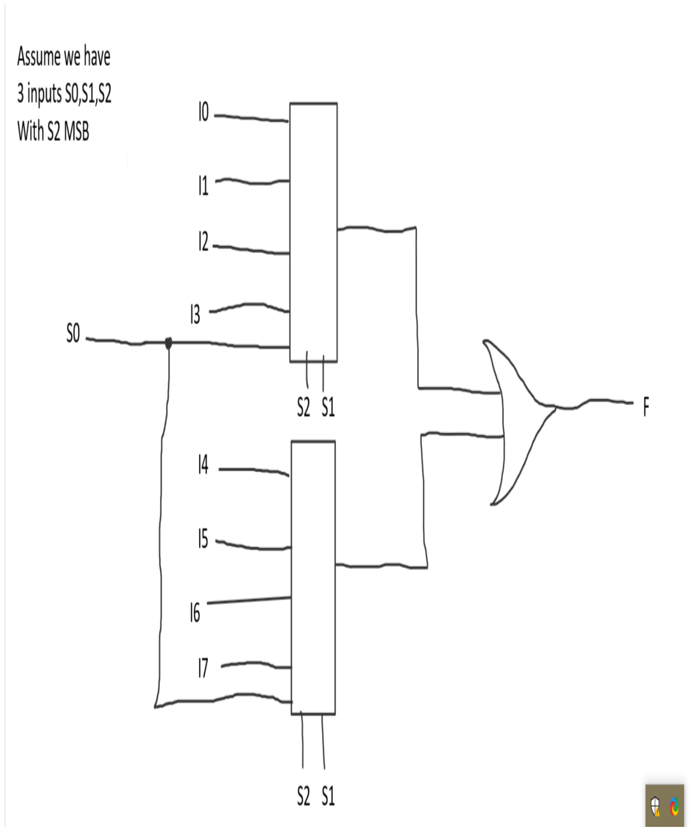
[picture p104: page 3]

Q2) Design a Majority Circuit; a circuit that takes 4 inputs A, B, C, D and 1 output Y. Its output equals 1 when 3 or 4 of the inputs are 1. You can only use two 4×1 multiplexers.
Sol 1)

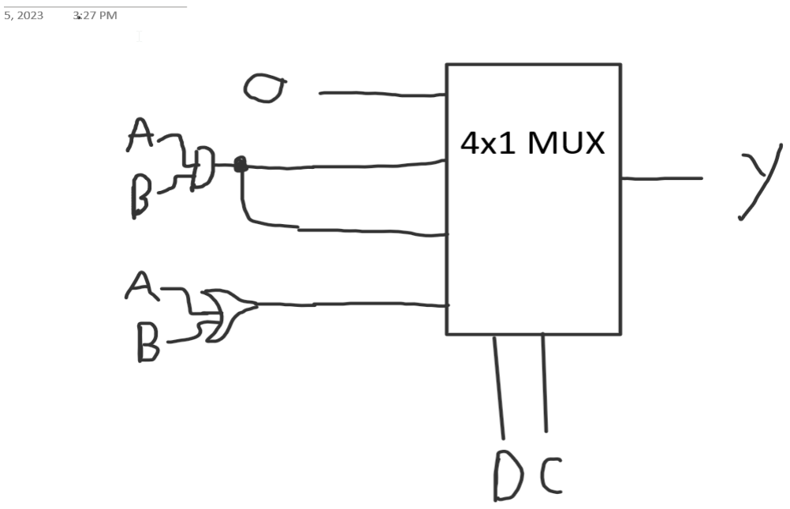
[picture p105: figure]
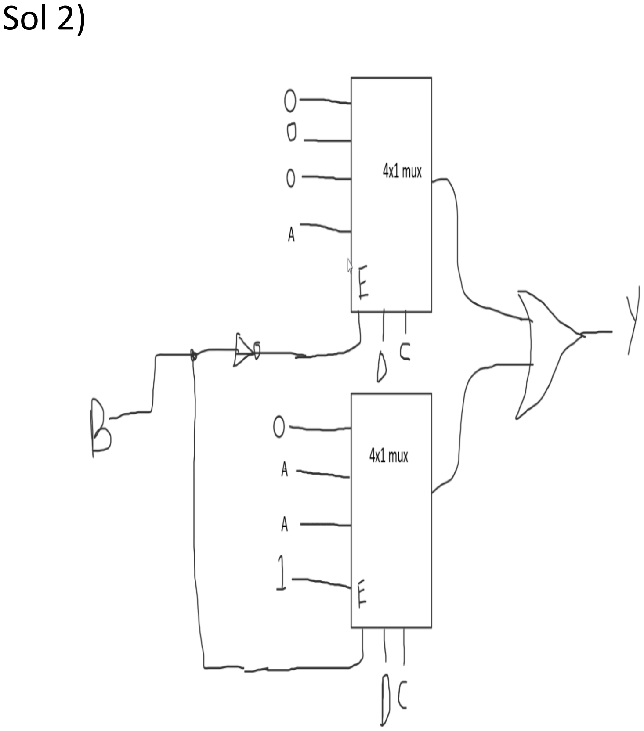
[picture p106: page 5]

Sol 2)
