MrAbdalrahman/university/digital_lap/assigments/preLap6.pdf

# preLab Experiment No. 6 - Sequential Logic Circuits using Breadboard and IC’s *Student name: Abdulrahman

shaheen.
* ID#: 1211753.

# * Instructor Name: Dr. Qadri Mayyala

* Date: 17/5/2023.
* Section: 2.

## 1) What is the appropriate display type (common anode/common cathode) that must be used with 7447 display decoders? Explain

your answer.

The appropriate display type to be used with the 7447 decoder depends on the internal circuitry of the 7447. 7447A: This version is designed for use with common anode 7-segment displays. In a common anode display, the anode (positive terminal) of all the LED segments are connected together and are typically driven with a logic low (0) to activate a particular segment. 7447B: This version is designed for use with common cathode 7-segment displays. In a common cathode display, the cathode (negative terminal) of all the LED segments are connected together and are typically driven with a logic high (1) to activate a particular segment.

t's important to note that connecting the 7447 to a display of the incorrect type will result in incorrect output.

## 2) Assuming that the turn-on voltage for the LEDs is 1.7v, what is the proper value of the 94 resistors to be connected between the

7447 decoder and the seven-segment display,

## to limit the current in the LED segments to

10mA?

R = Vr / I

Vr= Vcc – Vled

where Vr = Voltage across the resistor, Vcc = Supply voltage Vled = LED voltage drop

I=10mA (given), Vcc= 5V since it’s what we are using. Vled= 1.7 (given)

R = (5V - 1.7V) / 0.01A

R = 330Ω

## 3)Assume that the resistors provided in the lab are 220Ω. What would the current flowing into the LEDs be?

I = V / R ---> I = (Vcc - Vled) / R -----> I = (Vcc - 1.7V) / 220Ω -----> I = (5V - 1.7V) / 220Ω

I ≈ 0.013A or 13mA

## 4) Design a decade counter circuit using the 7490 counters, the 7447 decoder and a seven-segment display. Show the pin

numbers on the ICs in your design.

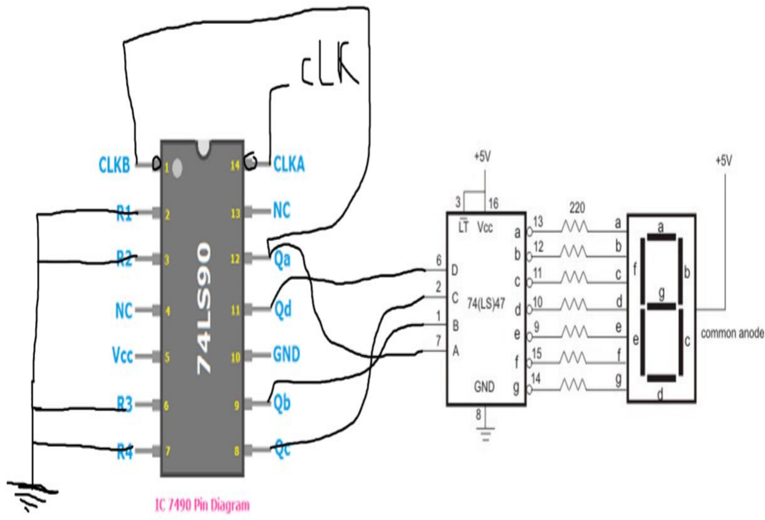
[picture p121: figure]
