MrAbdalrahman/university/digital_lap/assigments/post lap 1 .pdf

post-Lab
Experiment No. 1 - Combinational Logic Circuits.
*Student name: Abdulrahman shaheen.
* ID#: 1211753.
* Instructor Name: Dr. Qadri Mayyala * Date: 4/5/2023.
* Section: 2.

Q1: Draw the logic diagram showing the implementation of the following Boolean equation using “NAND” gates
a) F = AB (CA).
b) F= (D.A) + (C.B)
c) F = XZ + Y’Z + X’YZ

a)

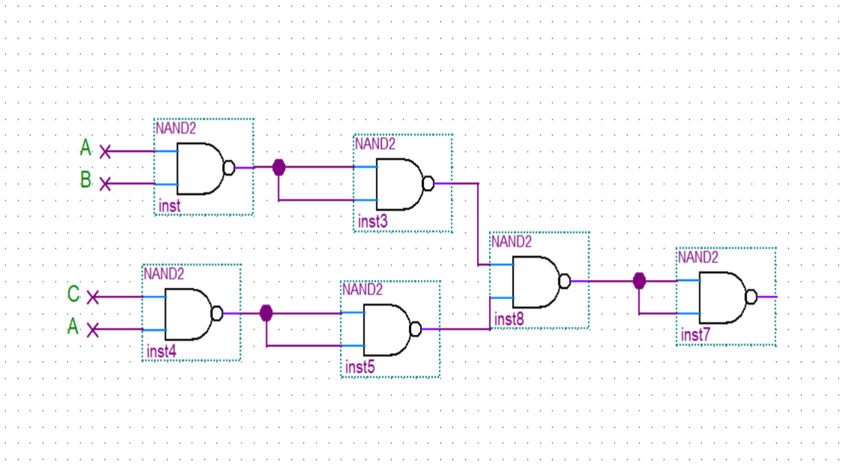
[picture p251: figure]
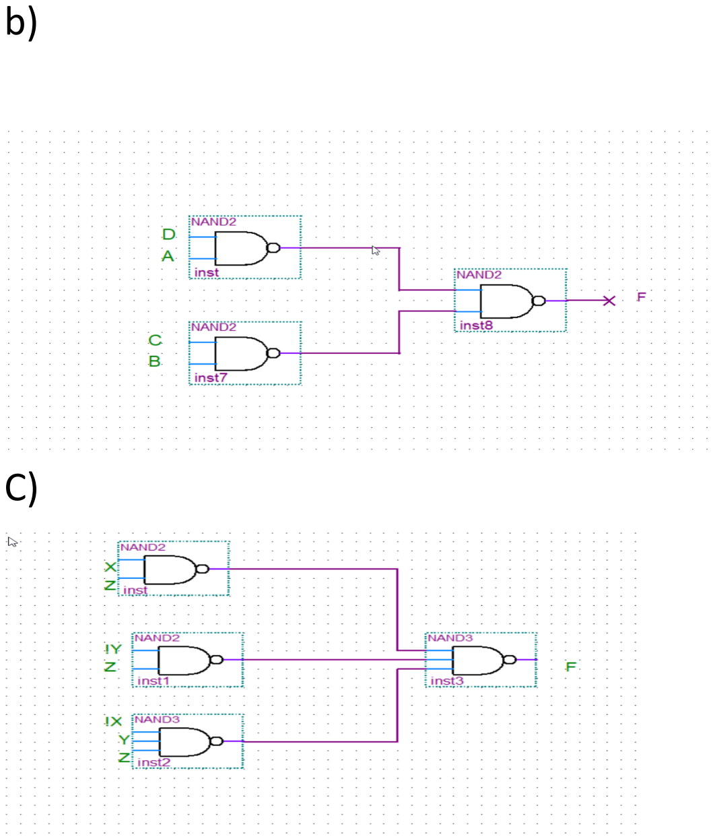
[picture p252: page 3]

b)

C)

Q2:
Draw the logic diagram of the following Boolean equations using NOR gates.
a) F=(A+B) (CD+A)
b) F= (ABC+D) C
c) F = (X+Z) (Y’+Z) (X’+Y+Z)

a)

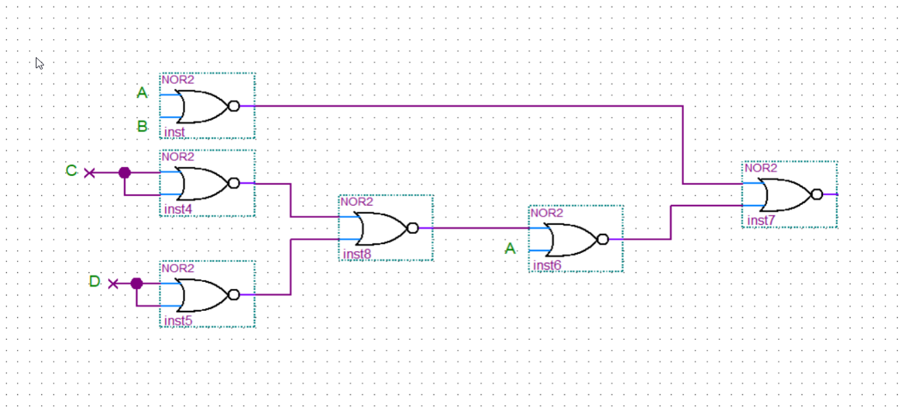
[picture p253: figure]

b)

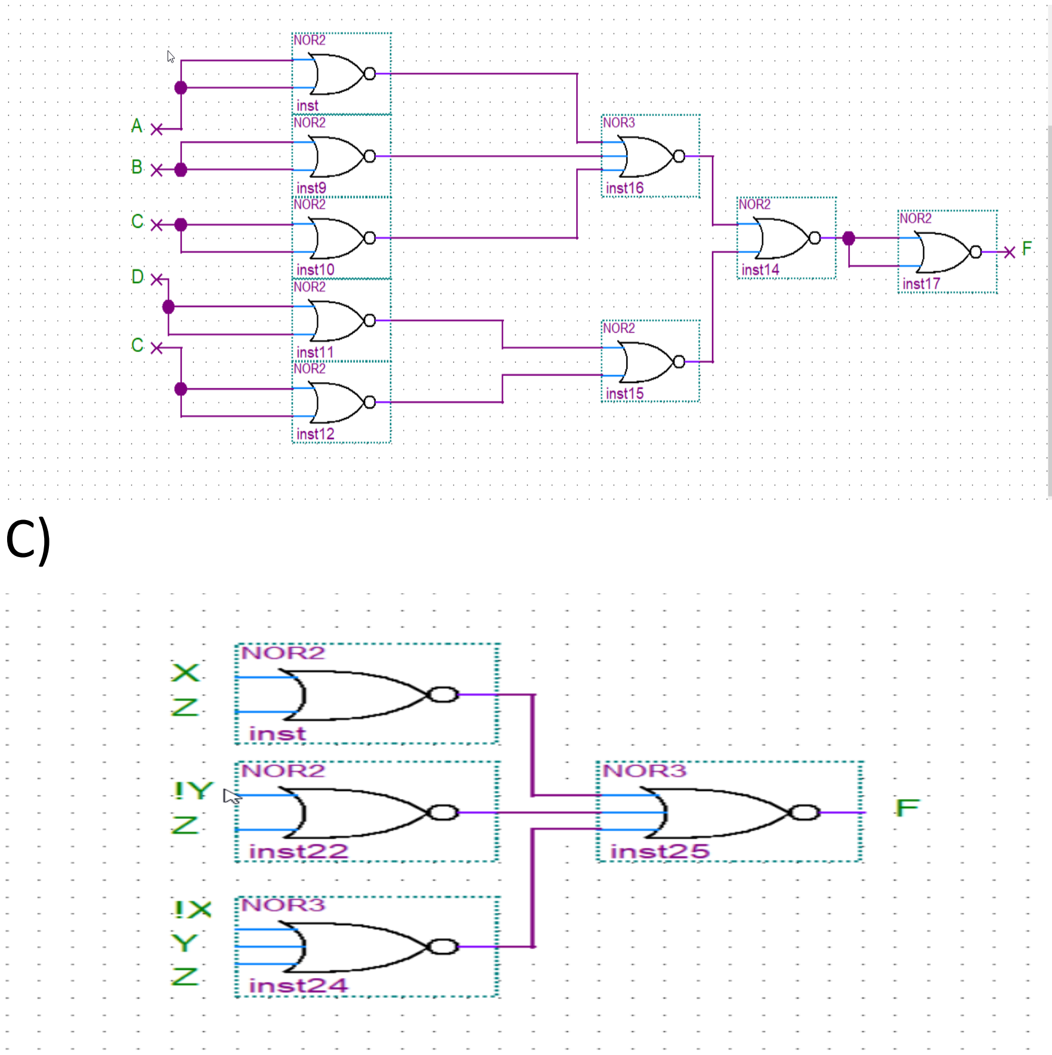
[picture p254: page 5]

C)

Q3) Implement the OR operation using AND, NOT gate. Draw the logic diagram and write the Boolean equation.

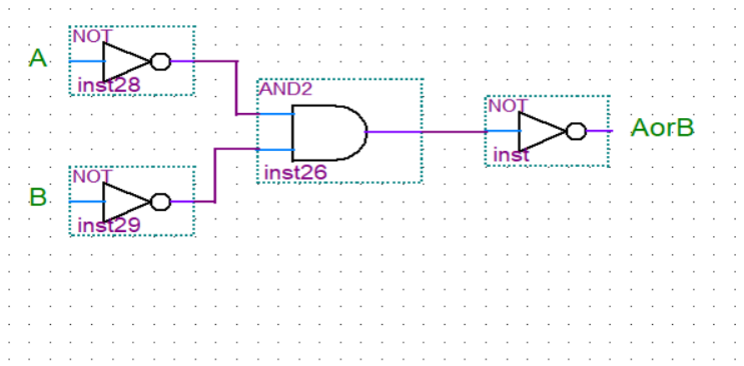
[picture p255: figure]

A OR B = !(!A and !B)
A+B=!(!A.!B)

Q4) Implement the AND gate using OR, NOT gate. Draw the logic diagram and write the Boolean equation.

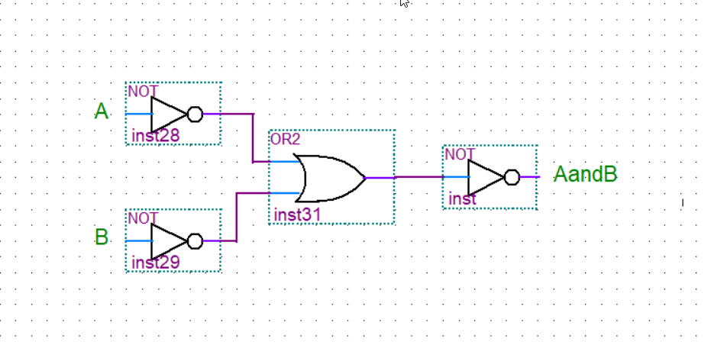
[picture p256: figure]

A and B = !(!A or !B)
A.B=!(!A+!B)

Q5) Prove that the equality operation Fl =AB+A’B’ is the inverse of exclusive OR operation F2=AB’+A’B (use Demerger’s theorem).
(ab+a’b’)’=(a’+b’).(a+b)=
ab’+bb’+aa’+a’b=ab’+a’b=xor

Q6) Show how is it possible to reduce Boolean expressions using the Karnaugh map:

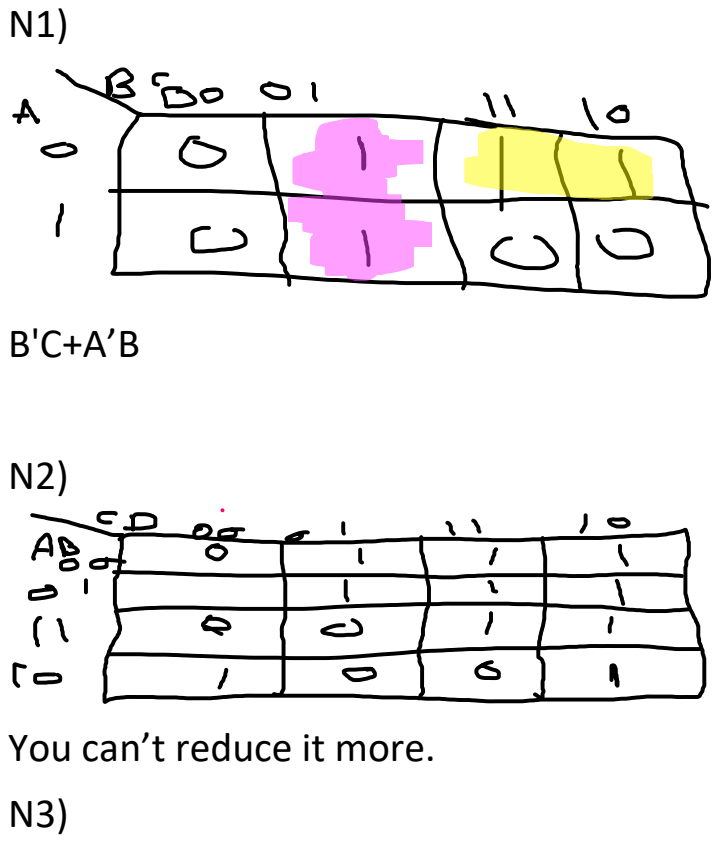
[picture p257: page 9]

You can’t reduce it more.

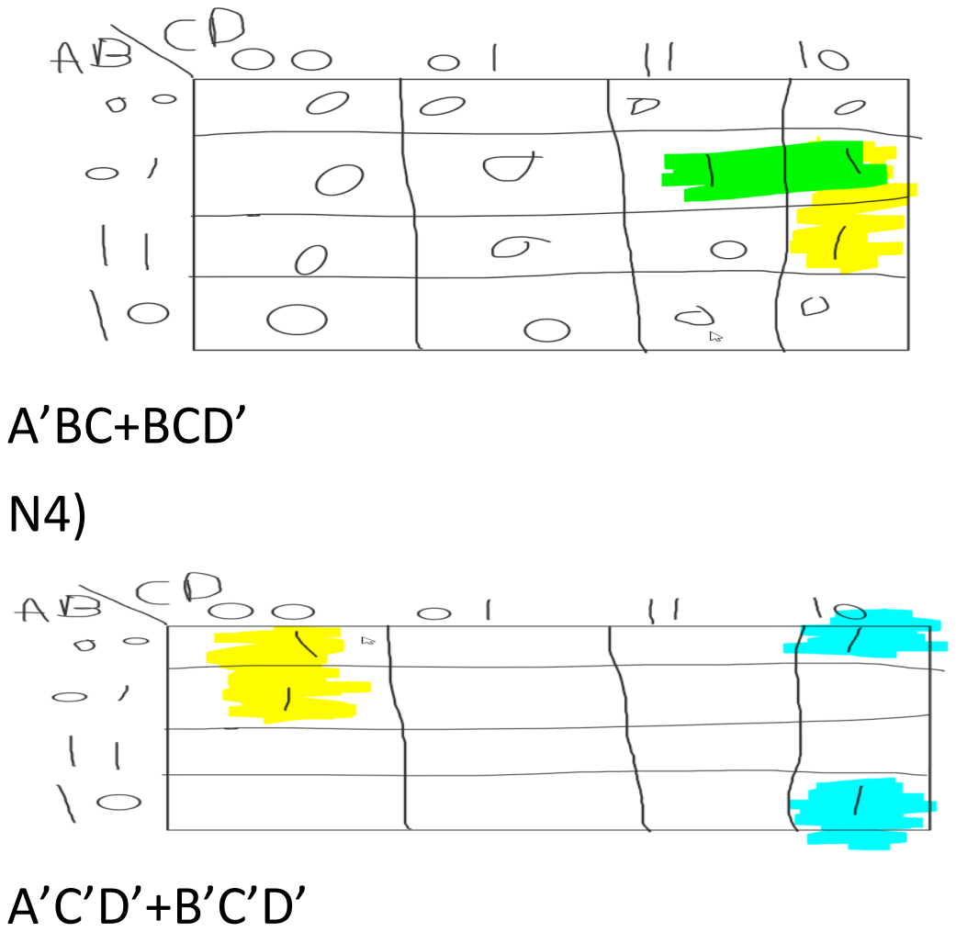
[picture p258: page 10]

A’BC+BCD’
N4)

A’C’D’+B’C’D’
