MrAbdalrahman/university/digital_lap/assigments/post lap 2.pdf

Post-lap
Experiment No. 2 - Comparators, Adders, and Subtractors
*Student name: Abdulrahman shaheen.
* ID#: 1211753.
* Instructor Name: Dr. Qadri Mayyala * Date: 4/12/2023.
* Section: 2.

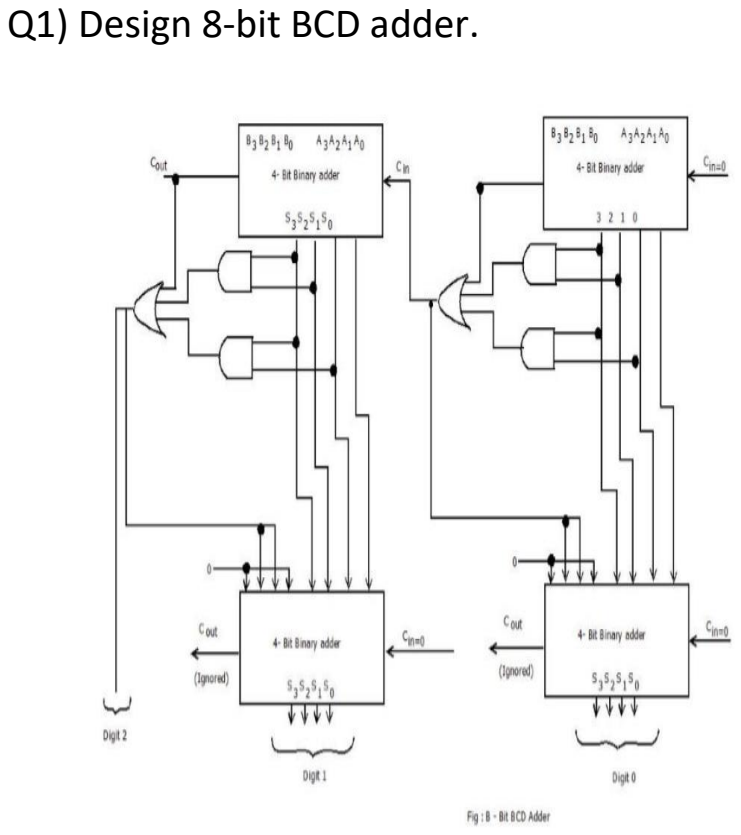
[picture p259: page 2]

Q1) Design 8-bit BCD adder.

Q2) Design 8-bit comparator using 2 of 4-bit comparator.

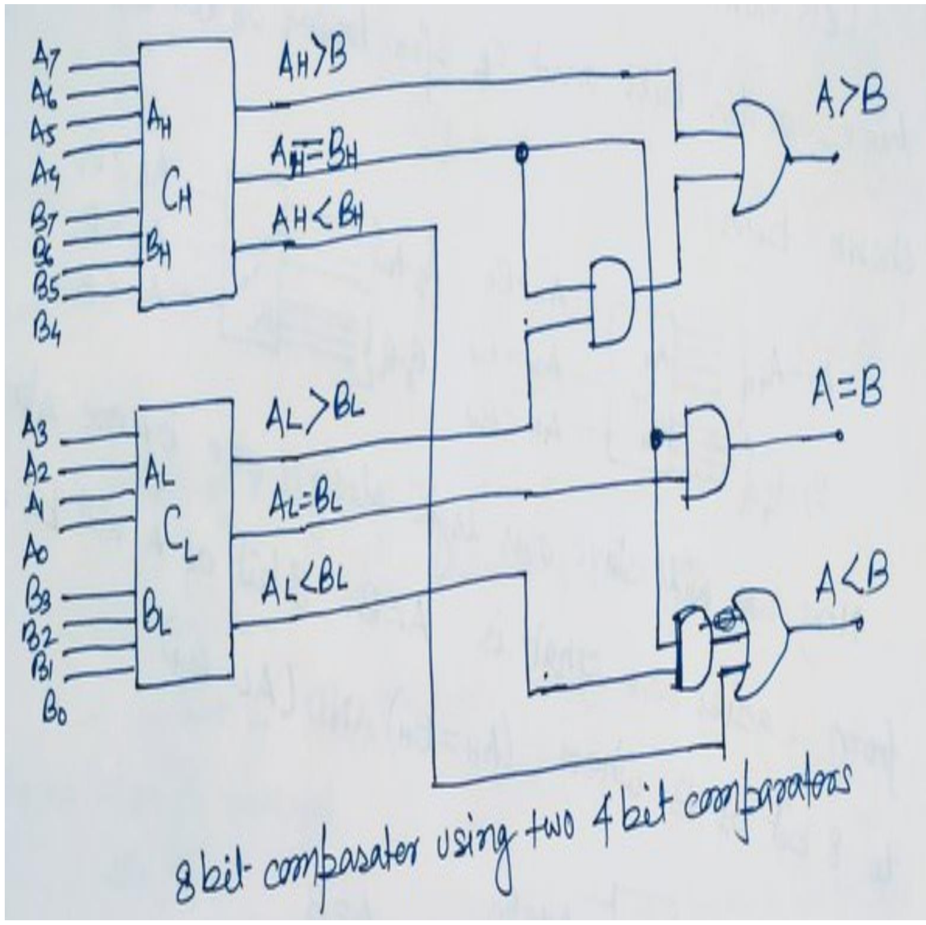
[picture p260: figure]

Q3) A 4-inputs, 3-outputs circuit that compares 2-bit unsigned numbers and outputs a ‘1’ on one of three output lines according to whether the first number is greater than, equal to, or less than the other number. You can only use two 4×1 multiplexer.

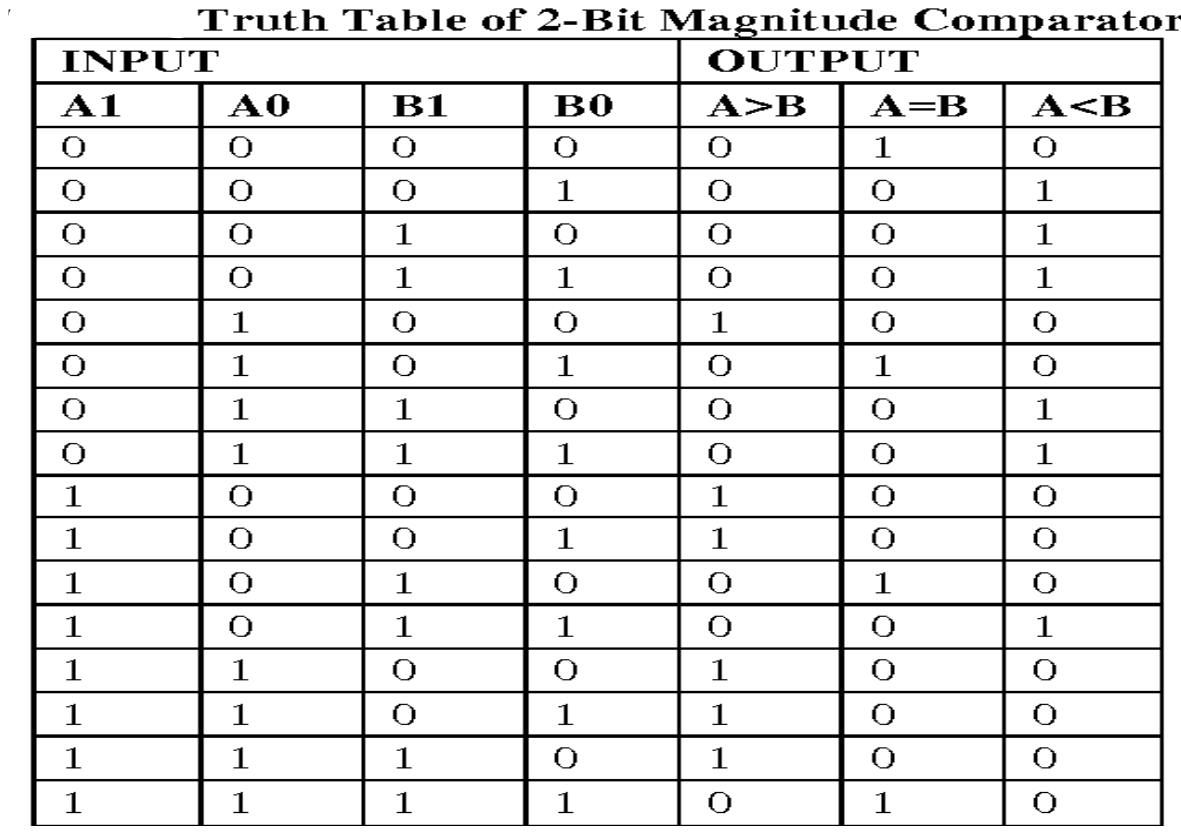
[picture p261: page 5]

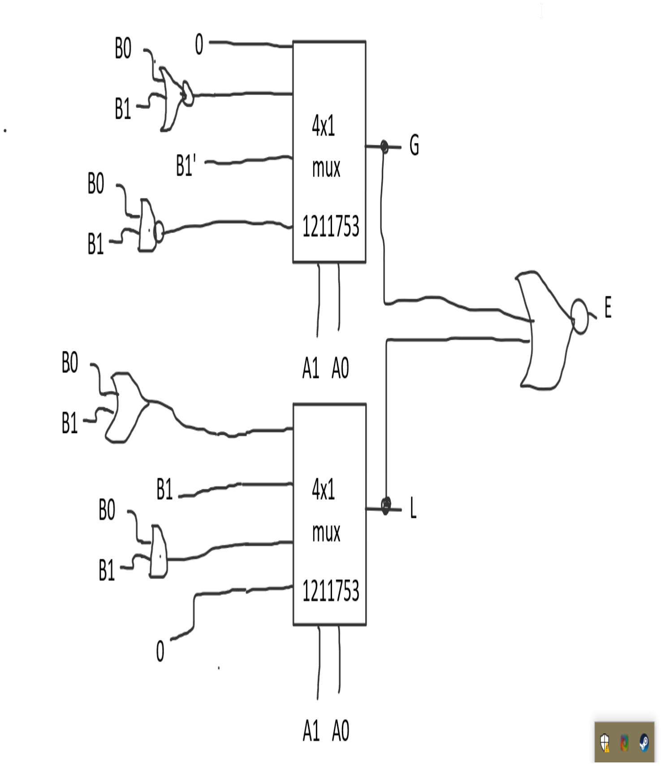
[picture p262: figure]
