MrAbdalrahman/university/digital_lap/assigments/post_lap4.pdf

post-Lab
Experiment No. 4 - Digital Circuits Implementation using Breadboard *Student name: Abdulrahman shaheen.
* ID#: 1211753.
* Instructor Name: Dr. Qadri Mayyala * Date: 3/5/2023.
* Section: 2.

Q1) by just adding the enable signal to each and gate:

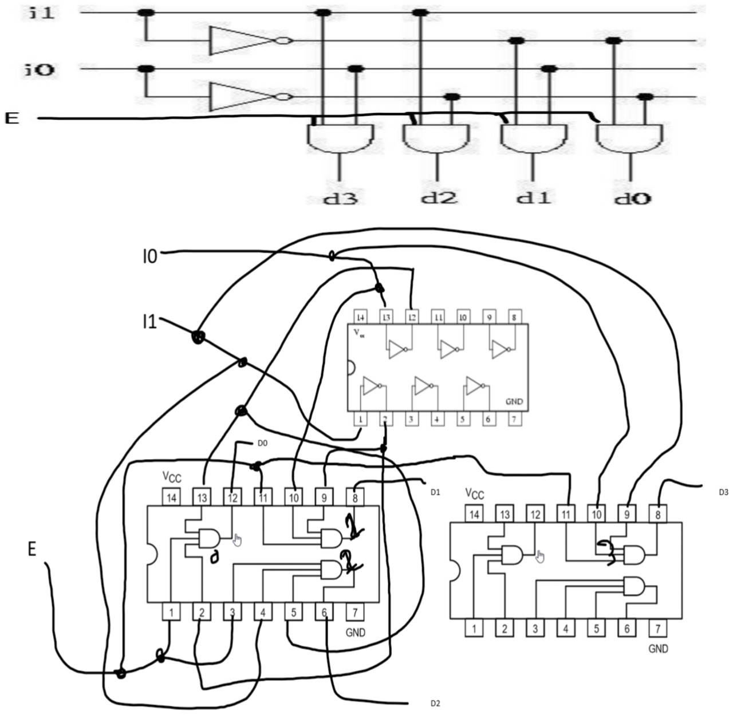
[picture p263: figure]

Q2)

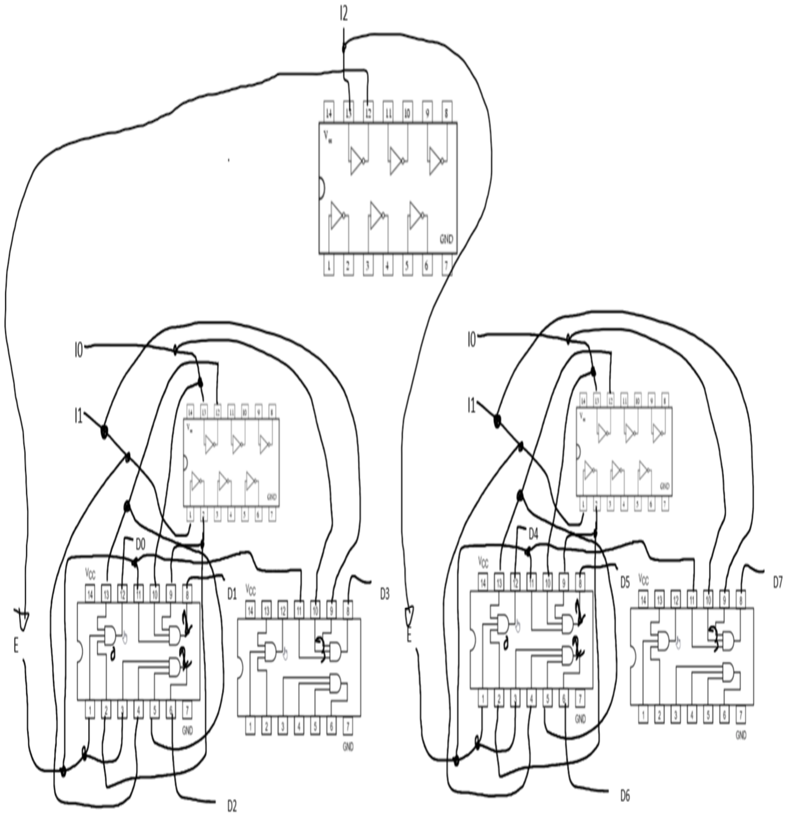
[picture p264: figure]
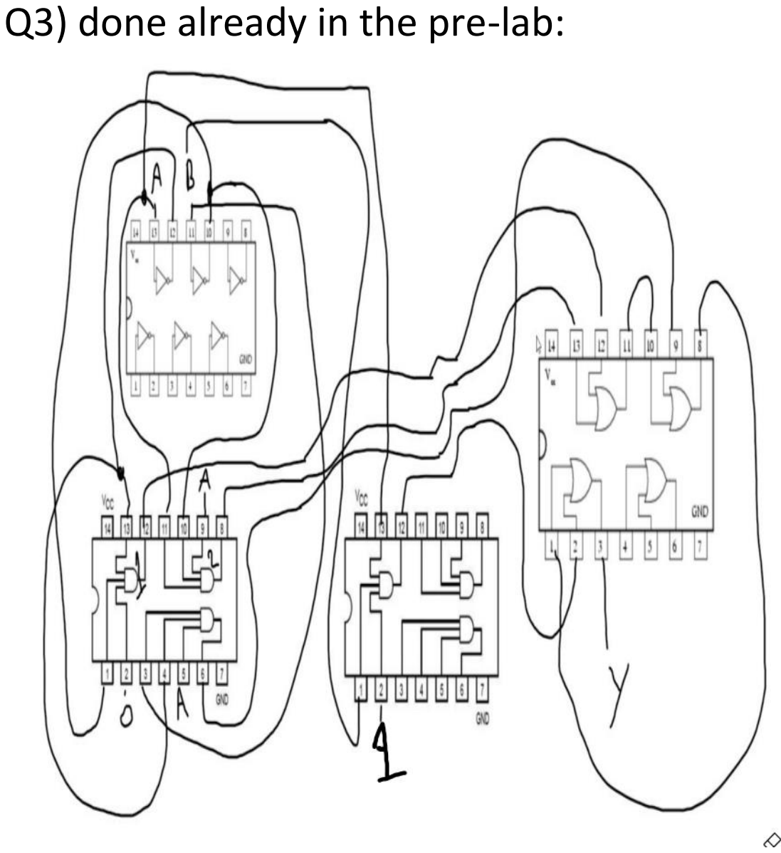
[picture p265: page 5]

Q3) done already in the pre-lab:

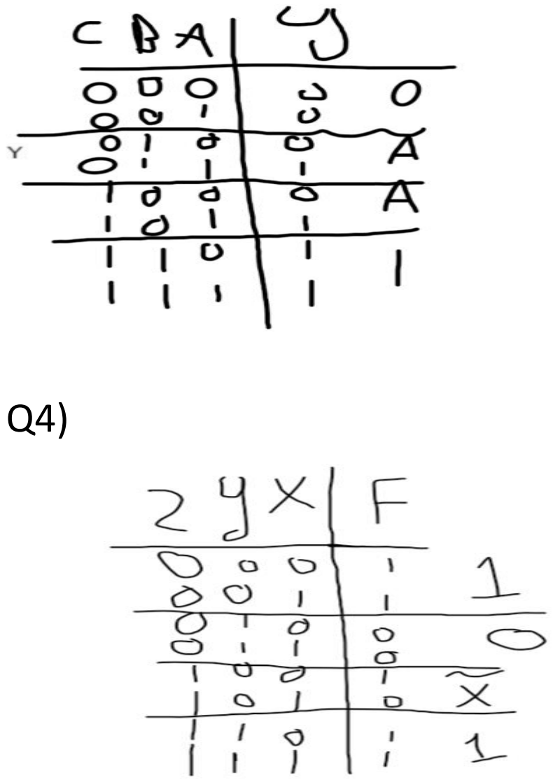
[picture p266: page 6]

Q4)

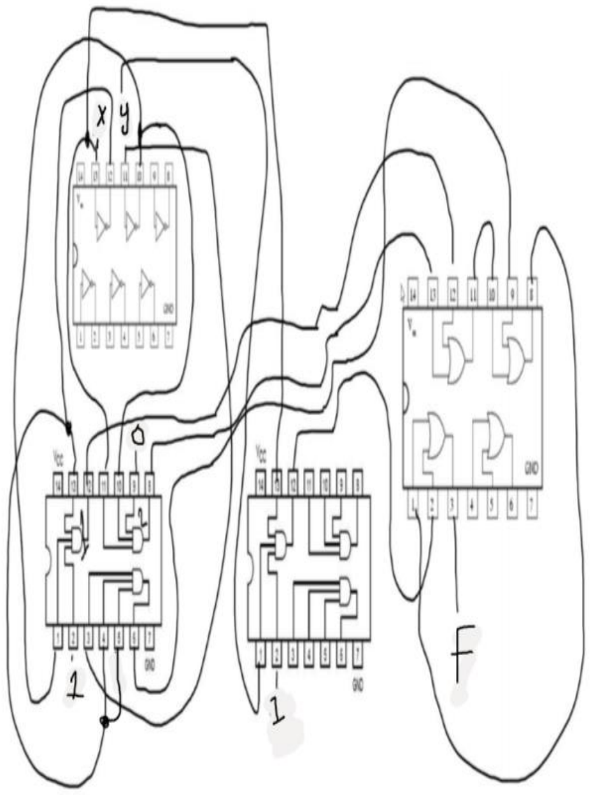
[picture p267: page 7]
