MrAbdalrahman/university/digital_lap/assigments/pre lap 2.pdf

Pre-Lab
Experiment No. 2 - Comparators, Adders, and Subtractors.
*Student name: Abdulrahman shaheen.
* ID#: 1211753.
* Instructor Name: Dr. Qadri Mayyala * Date: 4/5/2023.
* Section: 2.

At first there is the truth table and Boolean equations for the half adder

- Truth table:

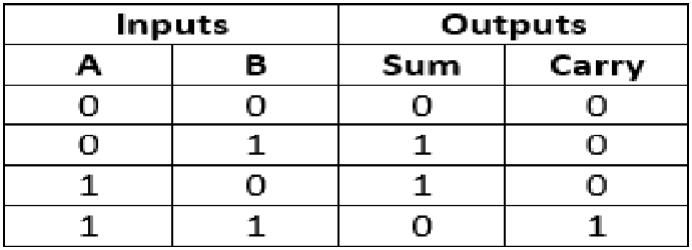
[picture p268: figure]

Boolean equation in min terms: Sum = X’Y +XY’
Carry = XY

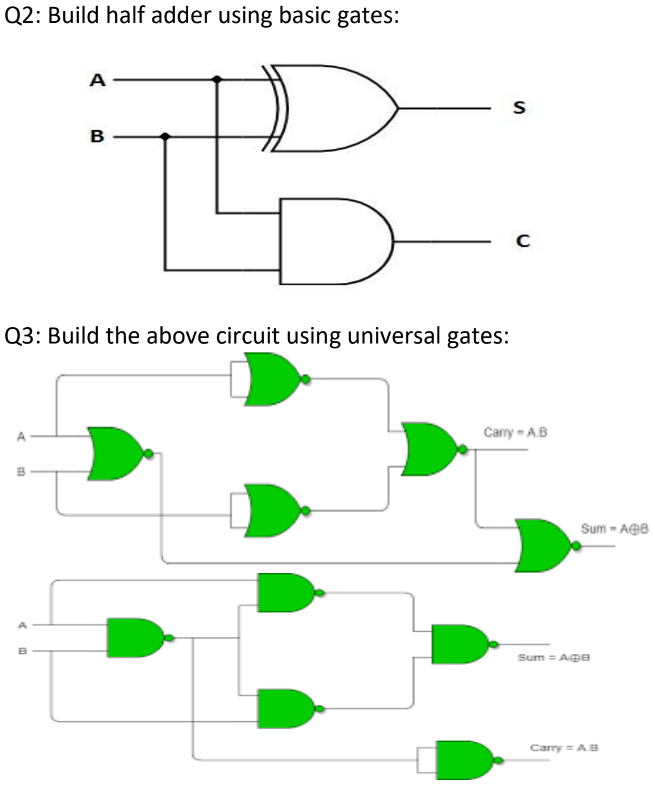
[picture p269: page 3]

Q2: Build half adder using basic gates:

Q3: Build the above circuit using universal gates:

At first there is the truth table and Boolean equations for the full adder: Truth table:

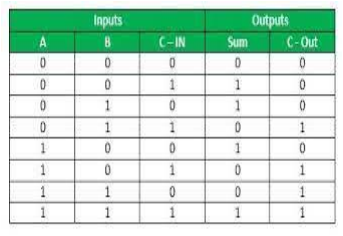
[picture p270: figure]

Boolean equation in min terms:
Sum = X’Y’C’ + X’YC’ + XY’C’ + XYC Carry = XY + YC + XC

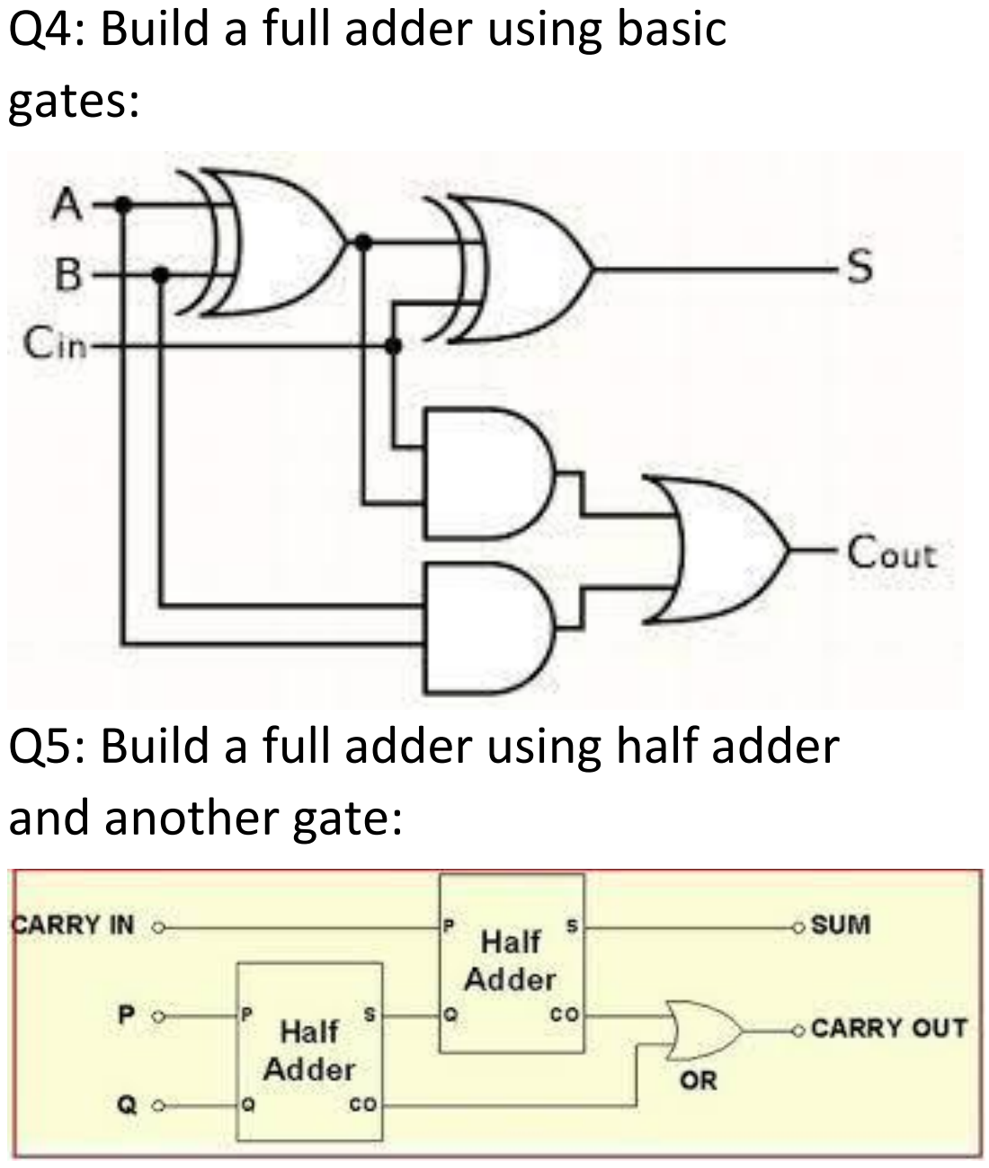
[picture p271: page 5]

Q4: Build a full adder using basic gates:

Q5: Build a full adder using half adder and another gate:

Q6: Build a 4-bit adder using a full adder:

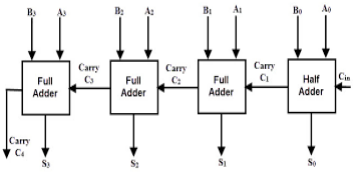
[picture p272: figure]

Q7: Build a 4-bit subtractor using basic gates.

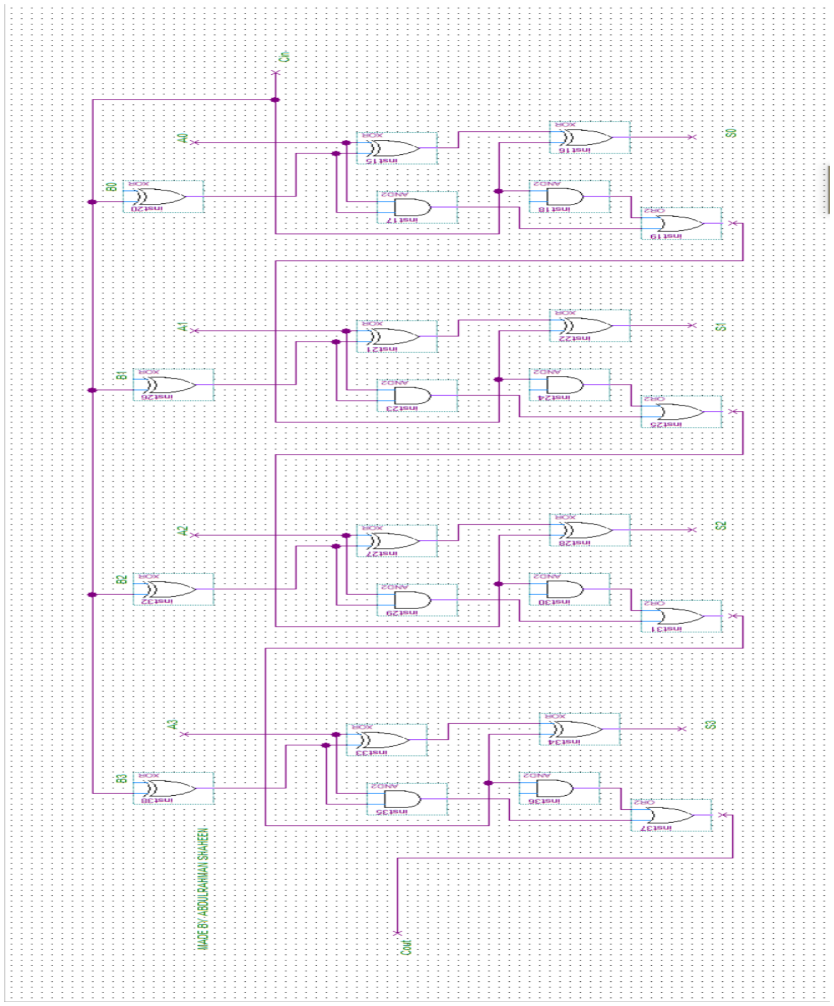
[picture p273: page 7]

Q1: all sections:

Design a three-bit comparator (using the basic comparator) and hand it out to your TA. (Pre Lab).

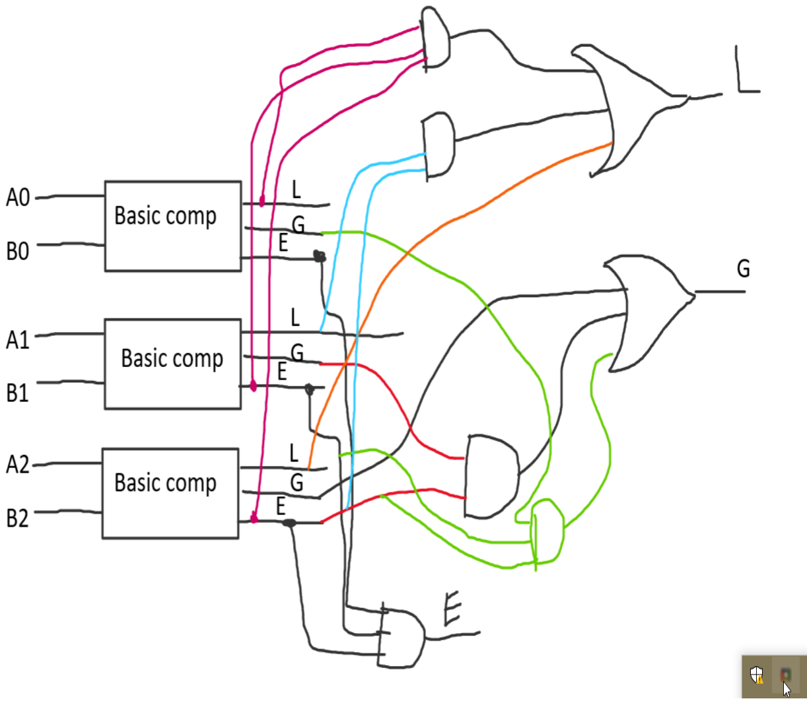
[picture p274: figure]

Hand out, Design, Boolean function, and truth table of half- and full-adder to your TA. (Pre Lab).

Done already in the previous sections. Q2+Q4

Hand out, Design, Boolean function, and truth table of half- and fullsubtractor to your TA. (Pre Lab).

Half subtractor:

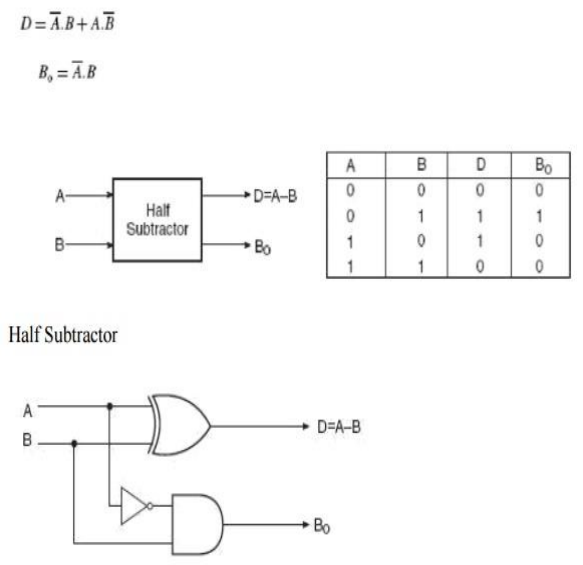
[picture p275: figure]

full subtractor:

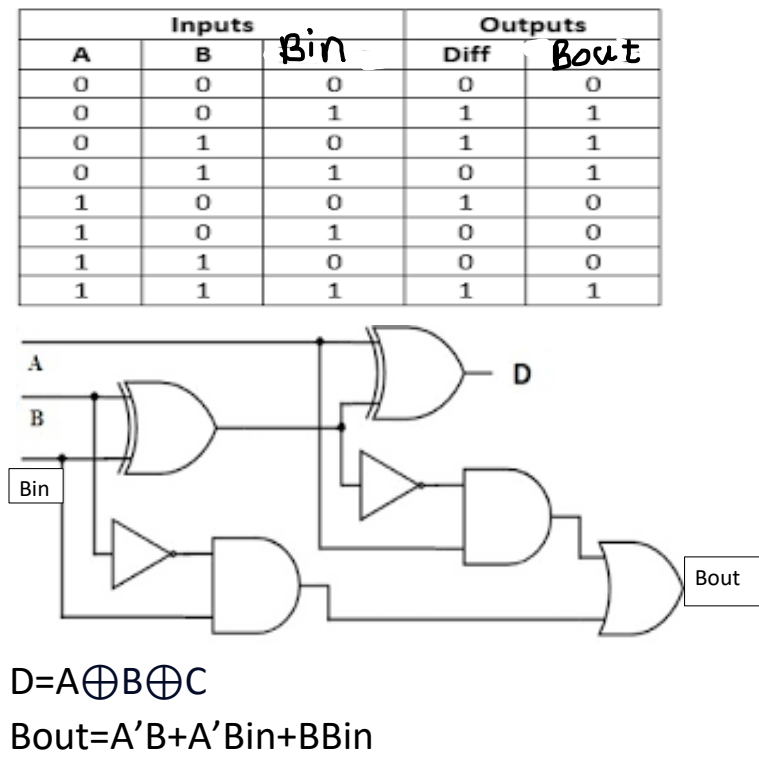
[picture p276: page 12]
Bin; Bout

Bout=A’B+A’Bin+BBin
