MrAbdalrahman/university/lunix/pythonFinal/WqR0DPPn1b.png

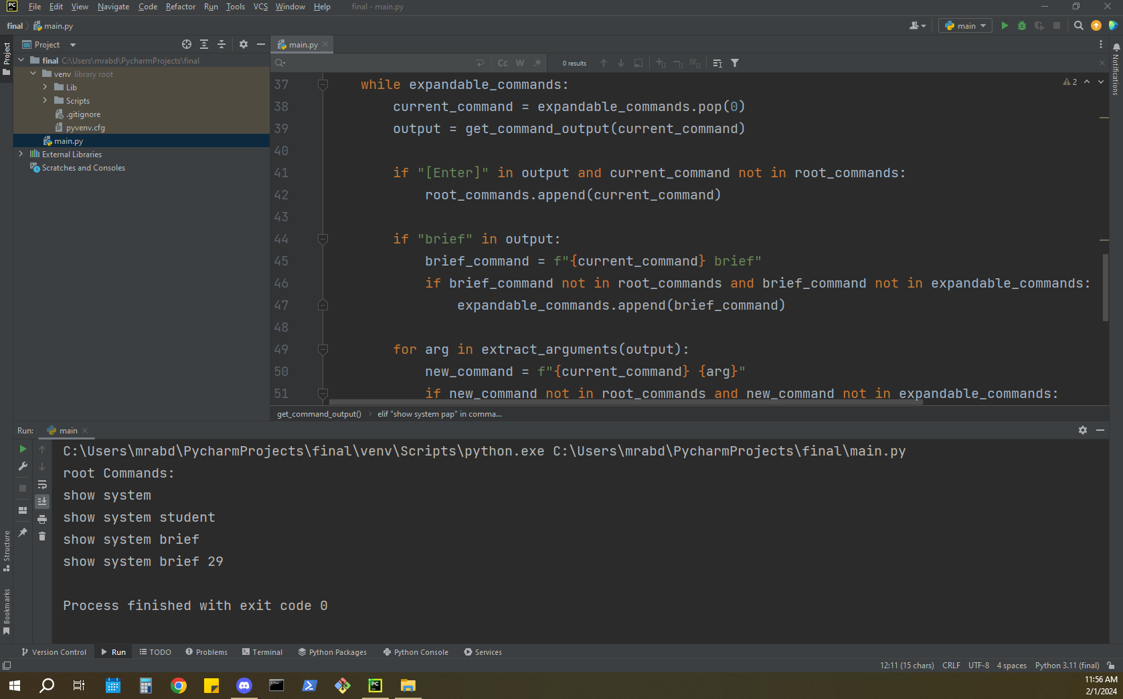
lunix/pythonFinal/WqR0DPPn1b.png
