MrAbdalrahman/university/lunix/shellFinal/in1.png

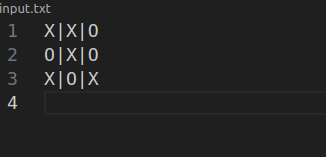
lunix/shellFinal/in1.png
