MrAbdalrahman/university/lunix/shellFinal/in2.png

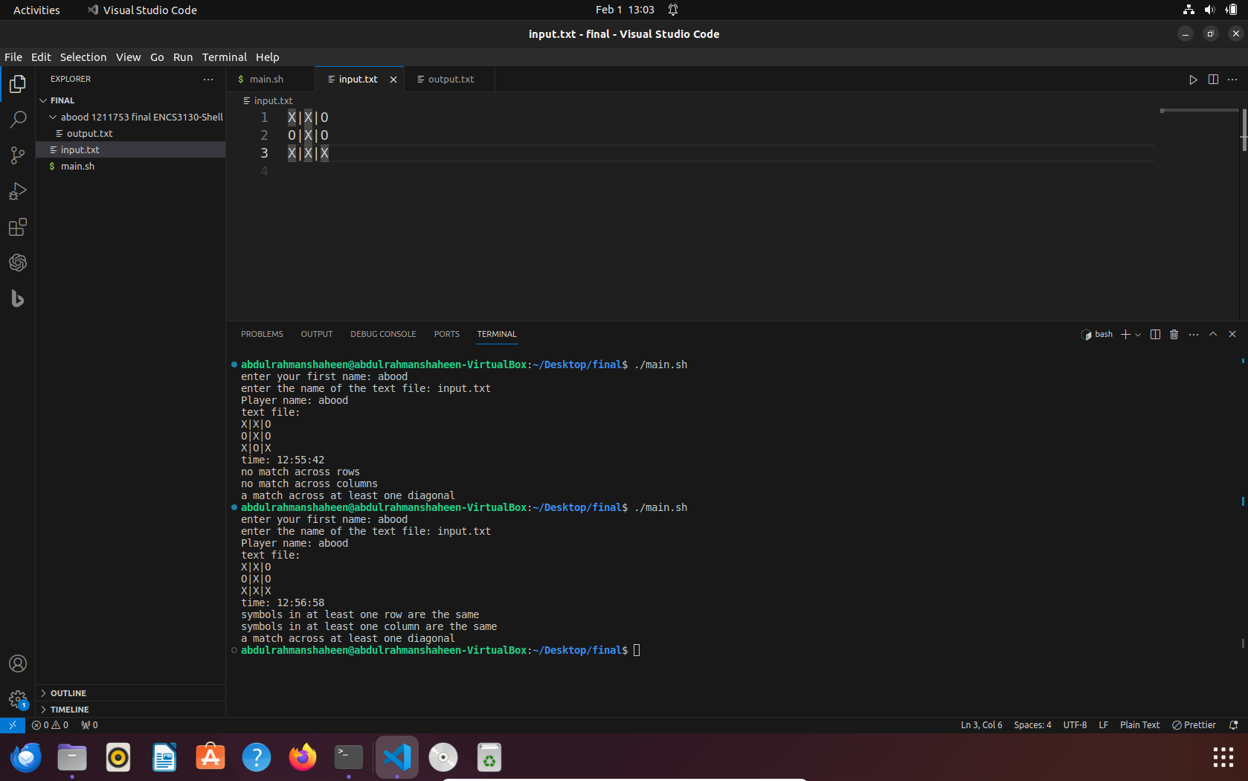
lunix/shellFinal/in2.png
