MrAbdalrahman/university/lunix/shellFinal/out1.png

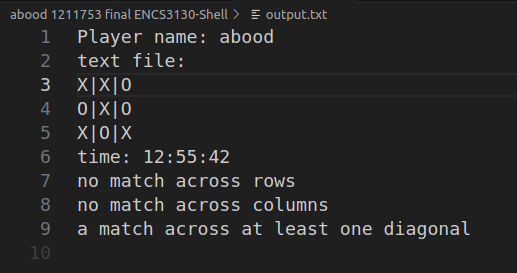
lunix/shellFinal/out1.png
