MrAbdalrahman/university/lunix/shellFinal/workspace.png

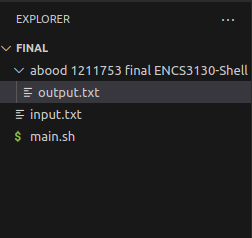
lunix/shellFinal/workspace.png
