MrAbdalrahman/university/operating_systems/OS_TASK1/OS.docx

C:\Users\mrabd\AppData\Local\Microsoft\Windows\INetCache\Content.MSO\2F00C463.tmp

Faculty of Engineering and Technology

Electrical and Computer Engineering Department

Operating Systems

ENCS33990

Task1

Process and Thread Management

Prepared by:

Abdel Rahman Shahen 1211753

Partners:

no partners

Instructor: Dr. Abdel Salam Sayyad

Section: 2

Date: 11/24/2023

# Theory:

The provided C code implements matrix multiplication using three different approaches: a naive sequential method, a parallelized version using pthreads (POSIX threads), and a multiprocess approach using fork() and shared memory. The matrices are generated using predefined content arrays, and the results are printed along with the execution time for each method.

The naive sequential approach calculates matrix multiplication straightforwardly with nested loops. The pthreads implementation divides the task among multiple threads for parallel execution, enhancing performance. The multiprocess approach relies on fork() to create child processes that independently compute submatrices in parallel, and shared memory facilitates communication between processes.

These approaches demonstrate the trade-offs between simplicity and performance optimization in matrix multiplication, offering insights into the benefits of parallelization and multiprocessing in computational tasks.

In this experimental context, the optimal configuration for matrix multiplication was found to be 6-15 (10) processes and 6-15 (10) threads for larger matrices (size: 1000), leveraging the benefits of parallel processing. However, for smaller matrices (size: 100), a more efficient performance was observed with 4 threads and 6 processes. This nuanced approach takes into account the matrix size, demonstrating that a tailored balance of threads and processes is crucial for optimizing parallelization benefits. The experiment reveals that, while a higher thread count is effective for larger matrices, a more conservative configuration yields better results for smaller matrices, emphasizing the importance of adaptability in parallel computing strategies.

T/O/size| Approach | Naive | Multiprocess | Multithread (joined threads) | Multithread (detached threads)
2/ 2/ 1000 | 3.91s | 3.16s | 4.047s | 0.0008s (zeros)
4 /4/ 1000 | 3.92s | 2.10 | 2.692s | 0.0023s (ZEROS)
6/ 6 /1000 | 3.75s | 1.83s | 2.431s | 0.0125s (ZEROS)
10/ 10 /1000 | 3.79s | 1.81s | 2.264s | 0.054s (ZEROS)
15/ 15 /1000 | 3.86s | 1.85s | 2.563s | 0.1359s (ZEROS)
2/ 2/ 100 | 0.003s | 0.006s | 0.0007s | 0.001s (zeros)
4 /4/100 | 0.003s | 0.008s | 0.002s | 0.002s(zeros)
6 /6 /100 | 0.003s | 0.006s | 0.009s | 0.002s(zeros)
10/ 10/ 100 | 0.003s | 0.009s | 0.007s | 0.003s (ZEROS)
15 /15/ 100 | 0.004s | 0.016s | 0.010s | 0.002s (ZEROS)

Summary:

In the experiments, the naive approach consistently exhibited the longest execution time, indicating its sequential nature. The multiprocess approach showed significant improvement over the naive method for larger matrices (size: 1000), leveraging parallel processes. The joined threads in multithreading also demonstrated notable efficiency gains, while detached threads exhibited the fastest performance, particularly for smaller matrices (size: 100). Overall, the average times highlight the superiority of the multiprocess and multithreaded (detached threads) approaches in optimizing matrix multiplication tasks, showcasing the benefits of parallelization for enhanced computational efficiency.

Detached threads, while providing efficiency in some parallel computing scenarios, are not ideal for matrix multiplication due to their lack of synchronization control. In matrix multiplication tasks, data dependencies are critical, and detached threads lack the ability to ensure synchronized execution, leading to potential data inconsistencies and errors. Joined threads offer a more controlled and coordinated approach, ensuring accurate computation and maintaining the integrity of the results in complex tasks like matrix multiplication.
