MrAbdalrahman/university/operating_systems/OS_TASK3/Available.csv

ResourceA | ResourceB | ResourceC | ResourceD | ResourceE #note that the number of instances of ResourceB=2 now
2 | 2 | 2 | 1 | 3
