MrAbdalrahman/university/operating_systems/OS_TASK3/Allocation.csv

Process | ResourceA | ResourceB | ResourceC | ResourceD | ResourceE
P1 | 5 | 6 | 0 | 3 | 1
P2 | 1 | 0 | 6 | 5 | 4
P3 | 2 | 4 | 1 | 0 | 2
P4 | 4 | 3 | 2 | 0 | 4
P5 | 6 | 2 | 3 | 2 | 2
P6 | 1 | 1 | 3 | 2 | 3
P7 | 0 | 0 | 5 | 1 | 1
P8 | 0 | 5 | 7 | 3 | 0
P9 | 2 | 6 | 0 | 5 | 0
P10 | 3 | 7 | 1 | 6 | 2
