MrAbdalrahman/university/operating_systems/OS_TASK3/Request.csv

Process | ResourceA | ResourceB | ResourceC | ResourceD | ResourceE
P1 | 2 | 0 | 4 | 5 | 5
P2 | 3 | 4 | 2 | 2 | 3
P3 | 0 | 3 | 3 | 4 | 4
P4 | 1 | 2 | 1 | 1 | 2
P5 | 3 | 1 | 4 | 4 | 1
P6 | 2 | 5 | 5 | 3 | 4
P7 | 0 | 3 | 2 | 2 | 3
P8 | 2 | 2 | 1 | 1 | 2
P9 | 3 | 1 | 6 | 0 | 1
P10 | 5 | 0 | 3 | 3 | 4
