MrAbdalrahman/university/computer_architicure/project1_MIPS32/tests.txt

1300555: HGB, 2025-06, 14.6e
1300523: HGB, 2020-01, 18.1e
1300566: BGT, 2026-07, 79.9e
1300511: BGT, 2021-02, 50.2e
1300511: BGT, 2021-02, 103.2e
1300522: LDL, 2022-03, 120.3e
1300577: LDL, 2027-09, 60.8e
1300522: LDL, 2022-03, 100.1e
1300533: BPTS, 2023-04, 180.4e
1300588: BPTS, 2028-09, 100.9e
1300588: BPTS, 2028-09, 45.1e
1300544: BPTD, 2024-05, 90.5e
1300599: BPTD, 2029-10, 40.0e
1300599: BPTD, 2029-10, 130.0e
1234567: HGB, 2022-02, 67.2e
