MrAbdalrahman/university/networks_lap/todos/todo3/ping_test.png

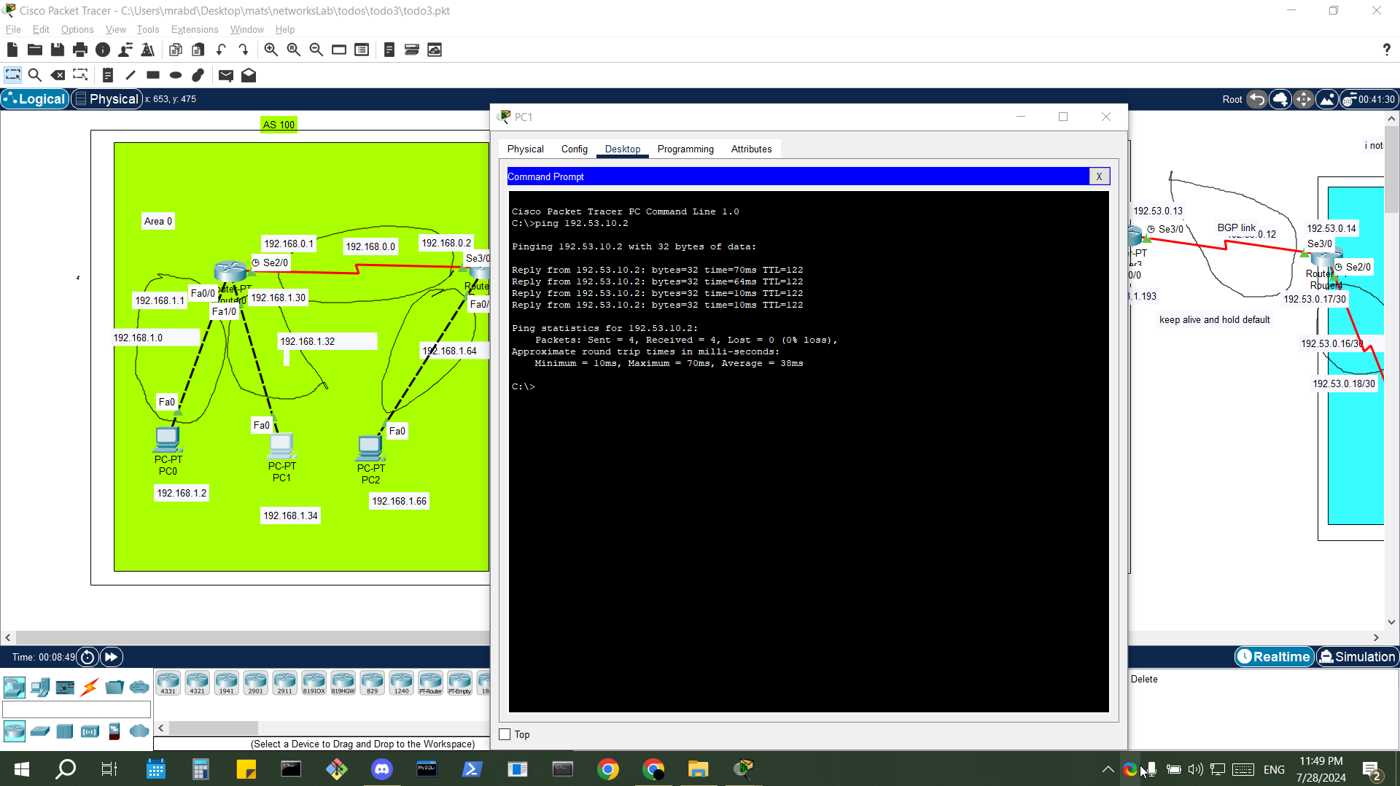
networks_lap/todos/todo3/ping_test.png
