MrAbdalrahman/university/networks_lap/todos/todo3/sh_run_test.png

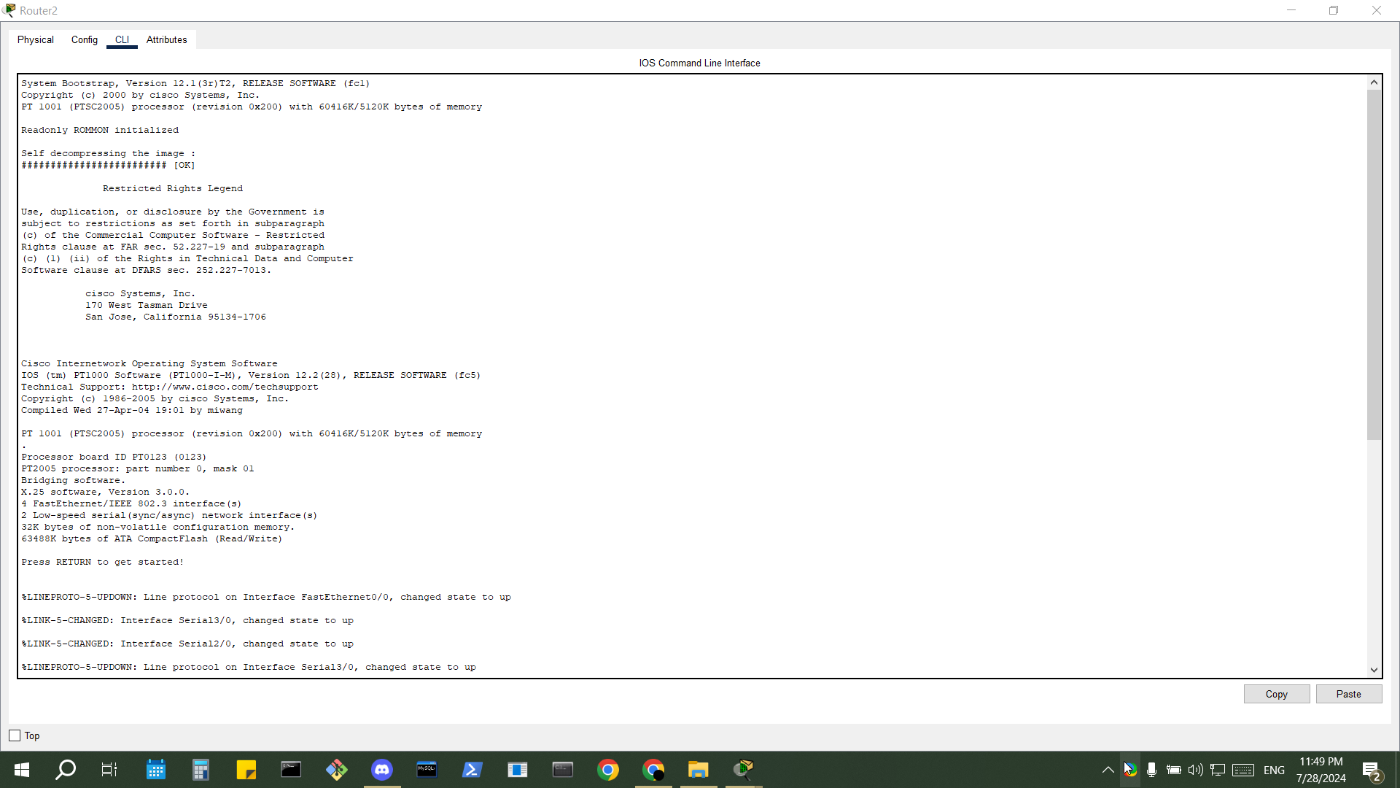
networks_lap/todos/todo3/sh_run_test.png
