MrAbdalrahman/university/networks_lap/todos/todo1/todo1_1211753.pdf

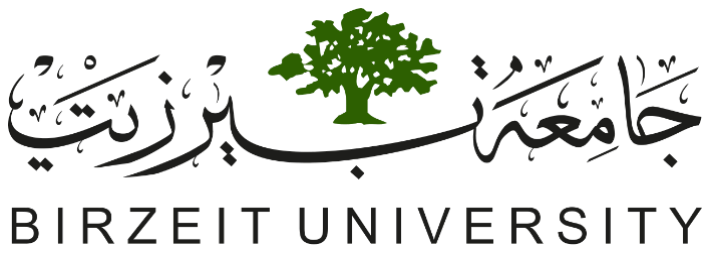
[picture p319: figure]

Faculty of Engineering and Technology Electrical and Computer Engineering Department TO DO #1 – Subnetting & Static Routing

NOTE: X represents the last 2 digits of your students ID.
Question: Given the following network address, 198.X.19.24/29 . Do the following:
1- Add a new router, switch and PC to the topology of EXP#2 that you have done, you are free to add it next to any existing router.
2- The PC IP is the second valid IP address.
3- Complete the following table:

First allowed IP

Last allowed IP

Broadcast IP

# of hosts

4- Complete the static routing for the new added network, check the connectivity of this new network!
