MrAbdalrahman/university/networks_lap/todos/todo1/pingsImages/pc0_pings.png

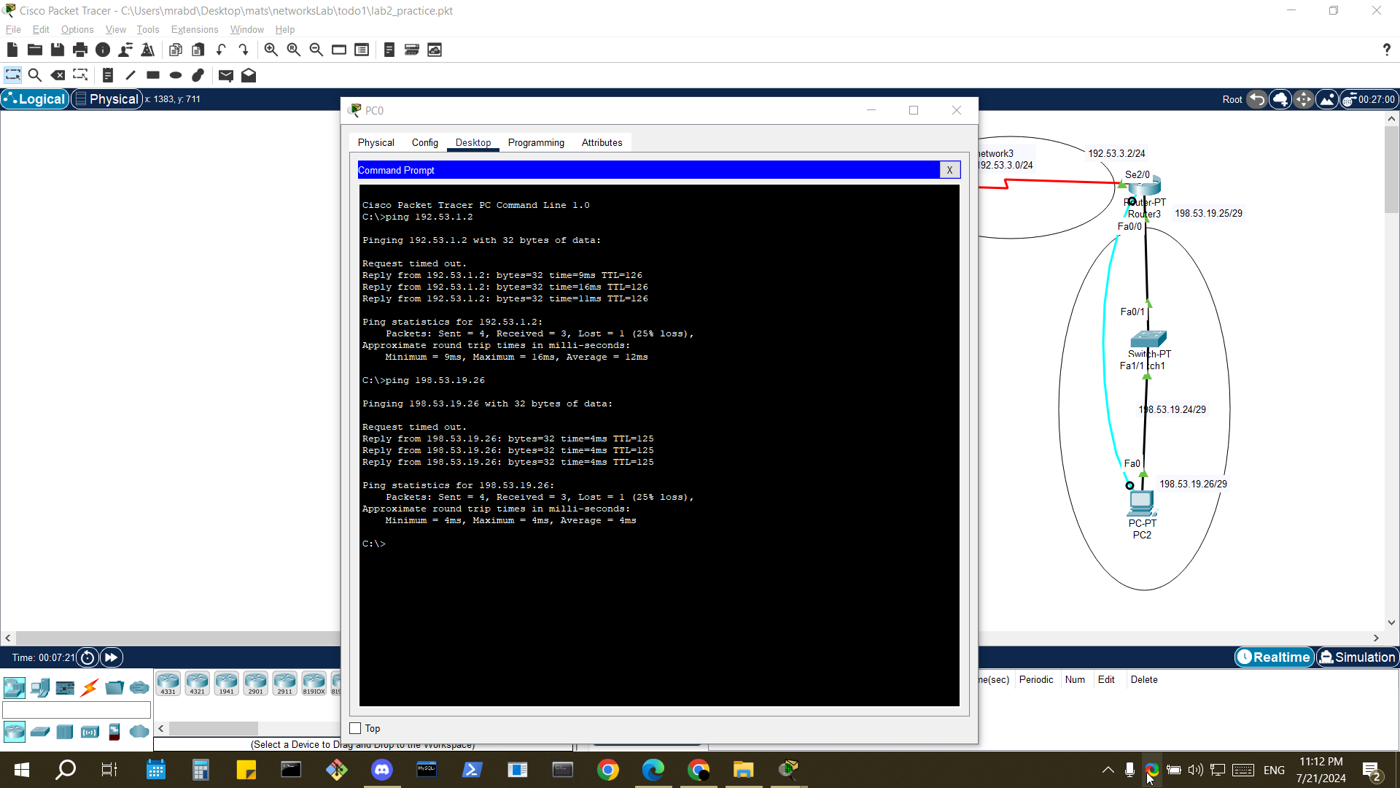
networks_lap/todos/todo1/pingsImages/pc0_pings.png
