MrAbdalrahman/university/computer_architicure/ArchProject2_multicycle_RISC_processor/datapathDesign/Multi_Cycle_dataPath_1211753.pdf

Register File INST IF_ID IF = Instruction Fetch | ID = Instruction Decode control Unit | ID_

# Signals and data ID_EX

Execute; Signals and Data PC_control; Signals and Data MEM = Memory Access; Write Back Extender; ALUSRC BusB Instruction Memory; dress Instruction; BusA BusB; address RW; BusA RARB; Address data in ExtOp; TTeextxt m JumpOffset Instruction Decoder Rs1 Rs2 SImm Imm; Func; input1 input2 ALUALU result; V 00011011 PCSrc Textxt +; {pc_out[15:12], (JumpOffset << 1)}; ALU flags pc_out; 01SV SImm; 01 BusA ALU result BusB; data_in SImm; 0001 Data Memory data out CLKC; LOAD_EXT; 00011x {LType,m} R7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
