MrAbdalrahman/university/(list of files, drawings)

Other design files:
advanced_digital/AdvancedHW21211753/Design1.ms14
computer_applications/exp_6/labWork_1_A/labWork1_A.pdsprj
computer_applications/exp_6/labWork_1_B/experiemnt6.pdsprj
computer_applications/exp_6/labWork_2/workLab_2.pdsprj
computer_applications/exp_6/labWork_3/labWork_3.pdsprj
computer_applications/exp_6/toDo4/toDo4.pdsprj
computer_applications/exp_7/labwork1/labwork7.pdsprj
computer_applications/exp_7/labwork2/labwork2.pdsprj
computer_applications/exp_7/labwork3_todo5/toDo5.pdsprj
computer_applications/exp_8/labWork_1/labwork8.1.pdsprj
computer_applications/exp_8/labWork_2/labwork8.2.pdsprj
computer_applications/exp_8/LABWork_3/labwork8.3.pdsprj
computer_applications/exp_8/toDo6/todo6_1211753.pdsprj
computer_applications/exp_9/labwork_1/exp9.pdsprj
computer_applications/exp_9/labWork_2/expp9.pdsprj
computer_applications/exp_9/labWork_3/LabWork3.pdsprj
computer_applications/exp_9/todo/LabWork3.pdsprj
computer_applications/exp_9/two_communication _chanels/New Project.pdsprj
computer_applications/exp_10/labWork_1/exp10.pdsprj
computer_applications/exp_10/todo_1/labwork2.pdsprj
computer_applications/exp_10/todo_2/labWork3.pdsprj
computer_applications/final_practical1/test.pdsprj
computer_applications/final_practical2/final.pdsprj
