MrAbdalrahman/university/advanced_digital/HM1/H1_DFF/compile.cfg

[View]
Entity=jcb_T
Architecture=
TopLevelType=3
[file:.\src\untitled.asdb]
Enabled=1
[file:.\src\untitled.awc]
Enabled=1
[file:.\src\jcb.v]
Enabled=1
[file:.\src\jcs.v]
Enabled=1
[file:.\src\wave.asdb]
Enabled=1
[file:.\src\jcs_wave.asdb]
Enabled=1
[file:.\src\jcs_wave.awc]
Enabled=1
[file:.\src\jcb_wave.asdb]
Enabled=1
[file:.\src\jcb_wave.awc]
Enabled=1
[file:.\src\jcb_wave.asdb]
Enabled=1
[file:.\src\jcb_wave.awc]
Enabled=1
