MrAbdalrahman/university/computer_architicure/ArchProject2_multicycle_RISC_processor/verilogCodes/PC.v

module pc(
    input clk,
    input reset,
    input [15:0] d,
    output reg [15:0] q
);

    always @(posedge clk or posedge reset) begin
        if (reset) begin
            q <= 0;
        end else begin
            q <= d;
        end
    end

endmodule
