MrAbdalrahman/university/(commit log)

2023-11-26 networ proggress on socket code
2023-11-29 experiemnt 6 progress
    [experiemnt6.pdsprj, labWork1_A.pdsprj]
2023-11-30 experiemnt 6 finished
    [toDo4.pdsprj]
2023-11-30 assembly files
2023-12-03 circuit assigment
2023-12-06 computer design
    [labwork7.pdsprj, toDo5.pdsprj]
2023-12-10 computer applications
    [labwork2.pdsprj, labwork7.pdsprj, toDo5.pdsprj]
2023-12-15 computer applications lab8
    [labwork8.1.pdsprj, labwork8.2.pdsprj, labwork8.3.pdsprj]
2023-12-15 computer applications lab8 todo
    [todo6_1211753.pdsprj]
2023-12-20 computer applications exp9
    [exp9.pdsprj, expp9.pdsprj]
2024-01-13 experiemnt 10
    [labWork3.pdsprj, labwork2.pdsprj]
2024-01-17 experiemnts micro
    [LabWork3.pdsprj]
2024-01-17 final practical
    [test.pdsprj]
2024-01-17 additional task
    [New Project.pdsprj]
2024-01-20 operating systems task3
    [Allocation.csv, Available.csv, Request.csv]
2024-01-23 final practical_2
    [final.pdsprj, test.pdsprj]
2024-04-12 advanced digital HM1 done
    [compile.cfg, library.cfg, projlib.cfg]
2024-06-08 advanced digital hw 2 done
    [Design1.ms14]
